mbolgar11/zenit/assets/video/zenit_projekt_poster.jpg

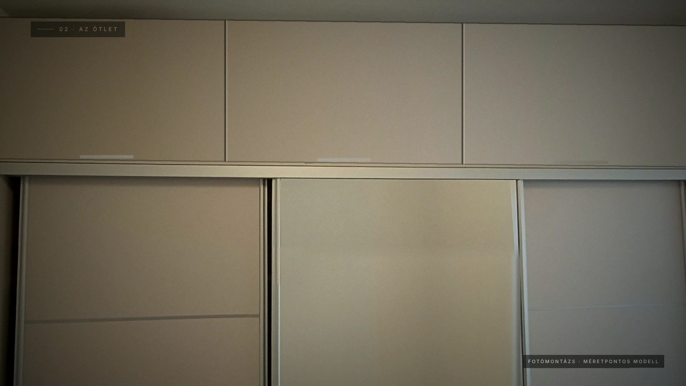
assets/video/zenit_projekt_poster.jpg
