mbolgar11/zenit/assets/img/r2/kezikonyv_hero_m.jpg

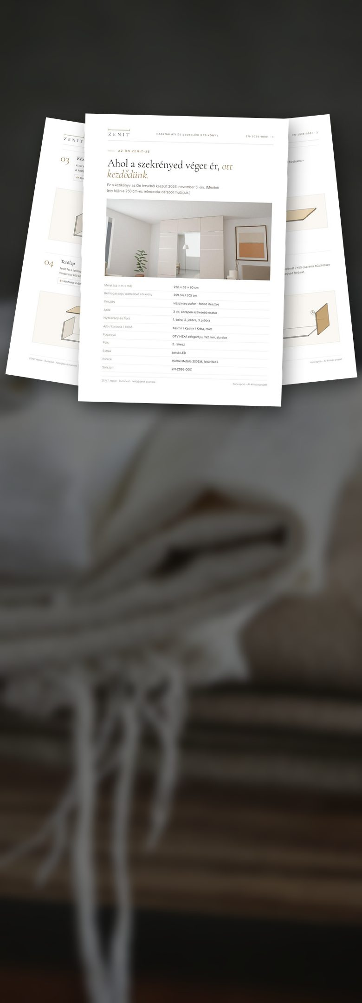
assets/img/r2/kezikonyv_hero_m.jpg
