mbolgar11/zenit/letoltes/ZENIT_kezikonyv_referencia.pdf

## Z E N I T

H A S Z N Á L AT I É S S Z E R E L É S I K É Z I K Ö N Y V | Z N - 2 0 2 6 - 0 0 0 1 · 1

A Z Ö N Z E N I T - J E

# Ahol a szekrényed véget ér, ott

kezdődünk.

Ez a kézikönyv az Ön tervéből készült 2026. november 5.-án. (Mentett terv híján a 250 cm-es referencia-darabot mutatjuk.)

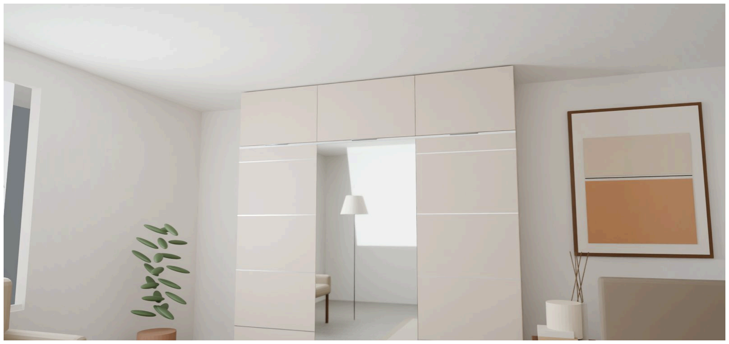
[picture p3: figure]

Méret (sz × m × mé) | 250 × 53 × 60 cm
Belmagasság / alatta lévő szekrény | 259 cm / 205 cm
Illesztés | vízszintes plafon · falhoz illesztve
Ajtók | 3 db, középen szélesebb osztás
Nyitásirány és front | 1. balra, 2. jobbra, 3. jobbra
Ajtó / korpusz / belső | Kasmír / Kasmír / Kréta, matt
Fogantyú | GTV HEXA élfogantyú, 192 mm, alu elox
Polc | 2. rekesz
Extrák | belső LED
Pántok | Häfele Metalla 300SM, felül fékes
Sorszám | ZN-2026-0001
ZENIT Atelier · Budapest · hello@zenit.example | Koncepció – AI-kihívás projekt

M I E L Ő T T E L K E Z D E N É | Z N - 2 0 2 6 - 0 0 0 1 · 2
Három szabály, és minden sikerül.
1. Puha takarón dolgozzon – a lapok éle és felülete hálás lesz érte.
2. A konfirmátot ütközésig húzza, utána csak negyed fordulatot.
3. Emelni mindig ketten kell: a korpusz ajtók nélkül kb. 56 kg.

# Szerszámok

Akkus csavarozó, PZ2 bit
Konfirmát kulcs (4 mm, a csomagban) Gumikalapács
Kis kalapács
Mérőszalag
Két létra
Ø2,5 fúrószár
PZ2 csavarhúzó
Vízmérték
Két ember

# Vasalat az Ön tervéhez

Fatipli 8×35 | 16 db
Konfirmát 7×50 + takarósapka | 16 db

Häfele Metalla 300SM
pánt (fékes + rugós)

6 db

Häfele szerelőtalp | 6 db
Csavar 3,5×16 | 30 db
Csavar 3,5×30 (rögzítés a szekrényhez) | 4 db
Polctartó csap Ø5 | 6 db
Hátfalszeg 1,6×25 | 50 db
GTV HEXA 192 élfogantyú | 3 db

LED-szalag +
ajtókapcsoló

3 db

Az ábrák a 250 cm-es, három ajtós referencia-darabot mutatják. Az Ön 3 ajtós ZENIT-je pontosan ugyanígy, ugyanebben a sorrendben áll össze – csak a közfalak és az ajtók száma más.

01

# Tiplik a helyükre

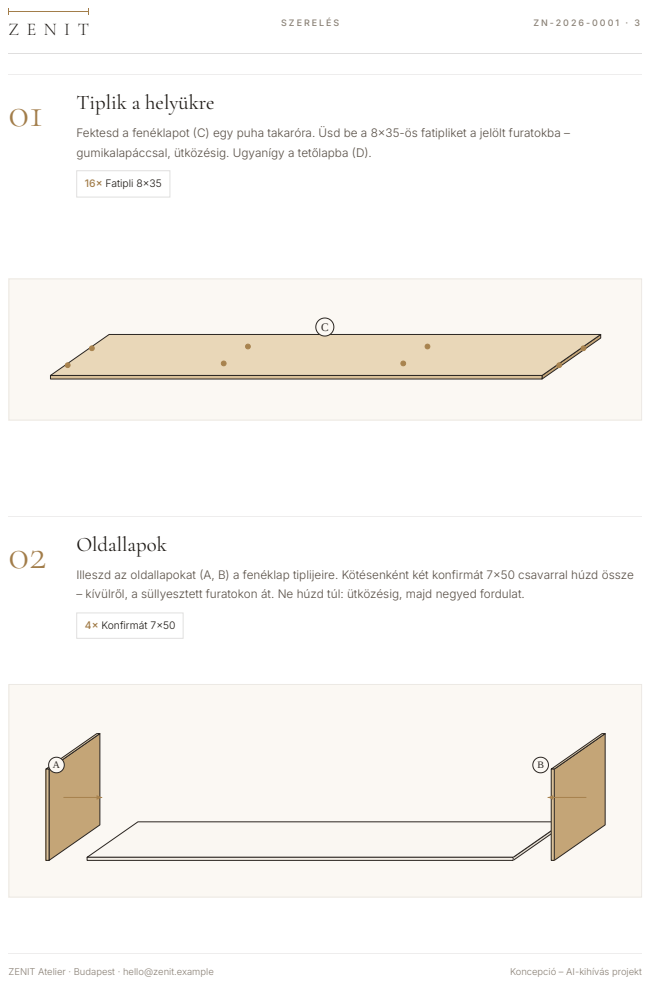
[picture p4: page 3]
16× Fatipli 8×35; Oldallapok; 4× Konfirmát 7×50

Fektesd a fenéklapot (C) egy puha takaróra. Üsd be a 8×35-ös fatipliket a jelölt furatokba –
gumikalapáccsal, ütközésig. Ugyanígy a tetőlapba (D).

Illeszd az oldallapokat (A, B) a fenéklap tiplijeire. Kötésenként két konfirmát 7×50 csavarral húzd össze
– kívülről, a süllyesztett furatokon át. Ne húzd túl: ütközésig, majd negyed fordulat.

03

# Közfalak

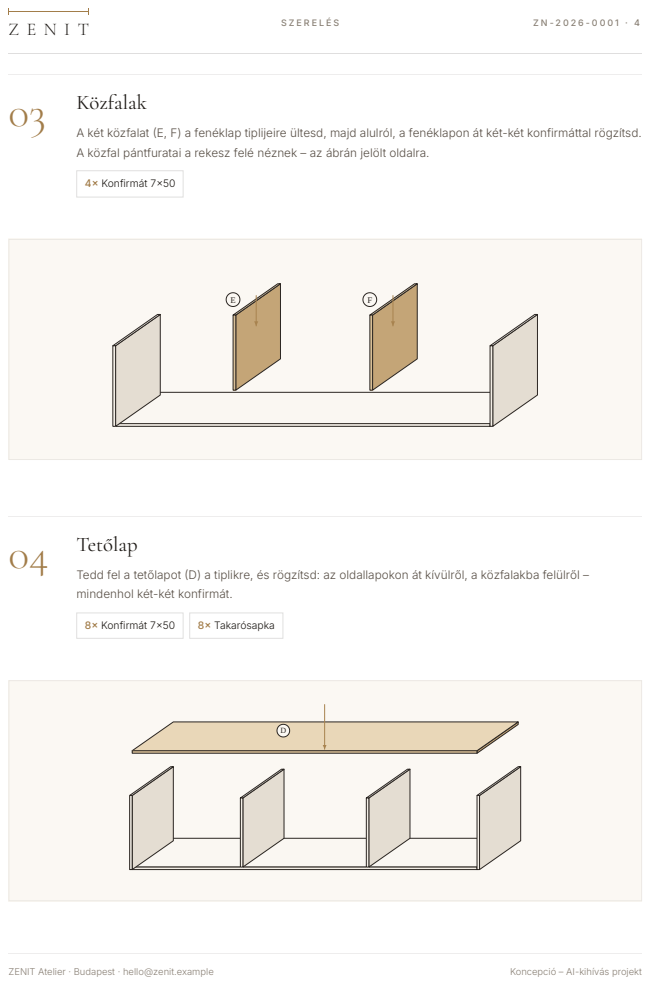
[picture p5: page 4]
4× Konfirmát 7×50; Tetőlap; 8× Konfirmát 7×50; 8× Takarósapka

A két közfalat (E, F) a fenéklap tiplijeire ültesd, majd alulról, a fenéklapon át két-két konfirmáttal rögzítsd.
A közfal pántfuratai a rekesz felé néznek – az ábrán jelölt oldalra.

Tedd fel a tetőlapot (D) a tiplikre, és rögzítsd: az oldallapokon át kívülről, a közfalakba felülről –
mindenhol két-két konfirmát.

05

# Derékszög

Mérd meg a korpusz két átlóját. Ha egyformák (±2 mm), a szekrény derékszögű – ez a záródó ajtók titka. Ha eltérnek, a hosszabb átló sarkait finoman nyomd össze.

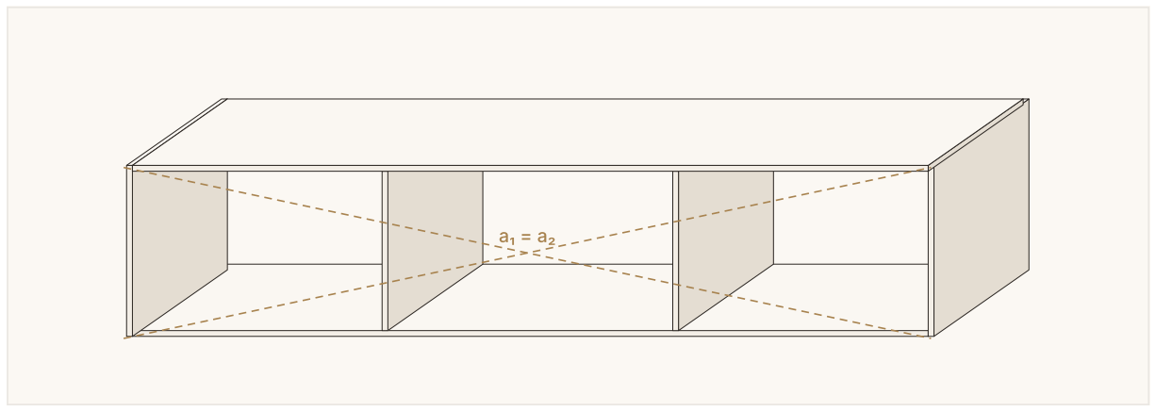
[picture p6: figure]

06

# Hátfal

Fordítsd a korpuszt elejével lefelé. Fektesd rá a hátfalat (H), igazítsd a sarkokhoz, és ~15 cm-enként üsd be a hátfalszegeket – körbe és a közfalakba is. Előfúrni nem kell.

50× Hátfalszeg 1,6×25

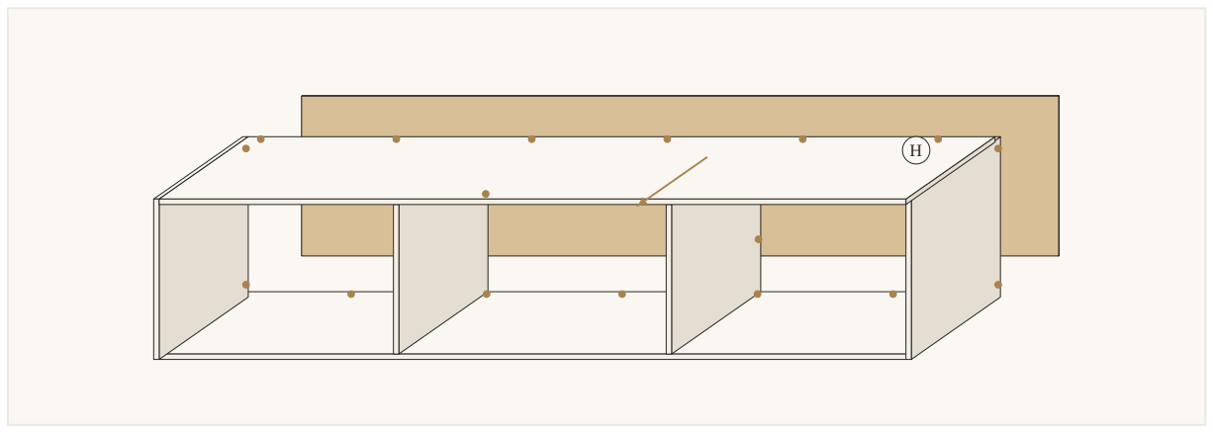
[picture p7: figure]

07

# Pánttalpak

Csavarozd fel a hat Häfele szerelőtalpat az előfúrt helyekre: az oldallapokra és a 2. közfalra, két-két 3,5×16 csavarral.

6× Häfele szerelőtalp 12× Csavar 3,5×16

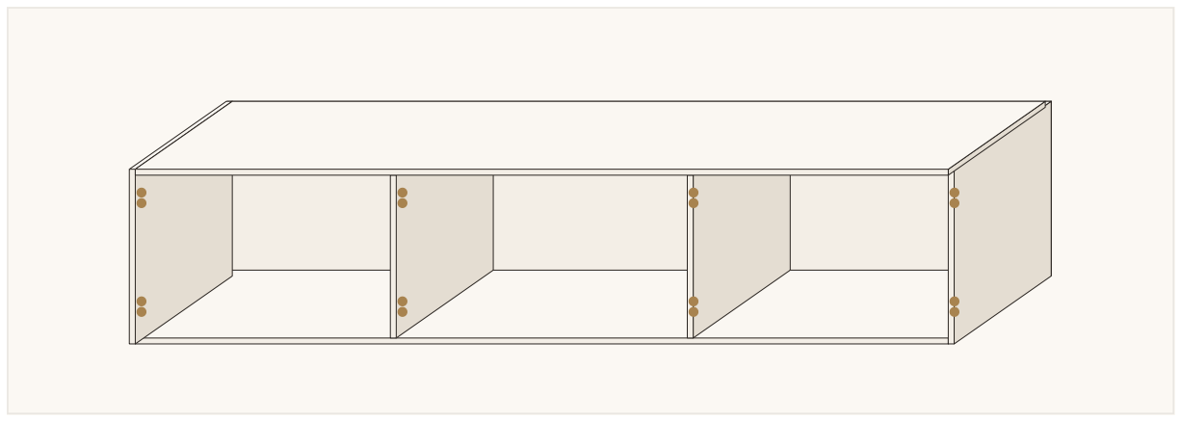
[picture p8: figure]

08

# Fel a szekrényre

Ketten emeljétek fel a korpuszt a meglévő szekrény tetejére – vízszintesen, és toljátok hátra. A plafonig ~10 mm marad, ezért billenteni nem lehet. Belülről, a két szélső rekeszben 2-2 csavarral rögzítsd a szekrény tetejéhez (Ø2,5 előfurat).

4× Csavar 3,5×30

Emeléskor mindig ketten! A korpusz kb. 56 kg ajtók nélkül.

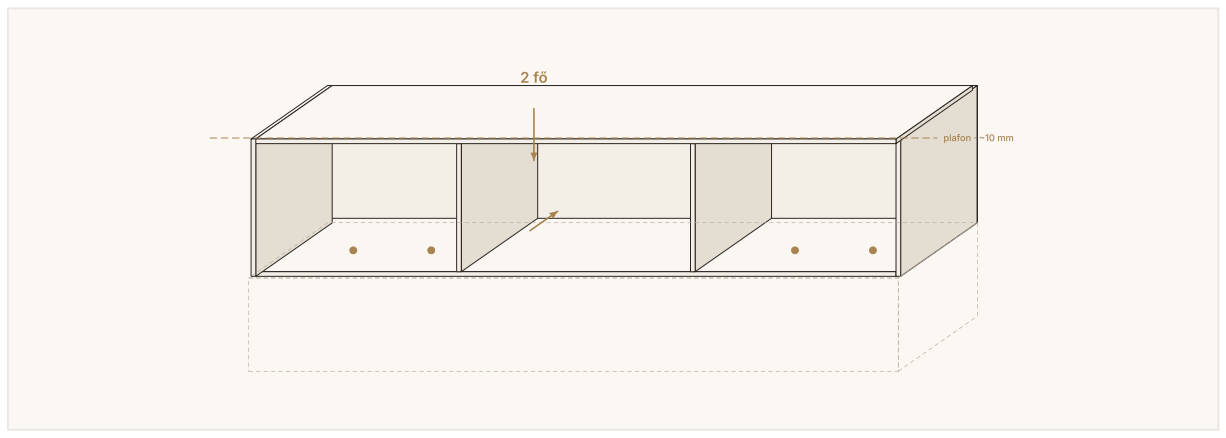
[picture p9: figure]
plafon · 10 mm

09

# Polc

Nyomd a polctartó csapokat a középső rekesz furataiba – oldalanként hármat. Csúsztasd be a polcot (G).

6× Polctartó csap Ø5

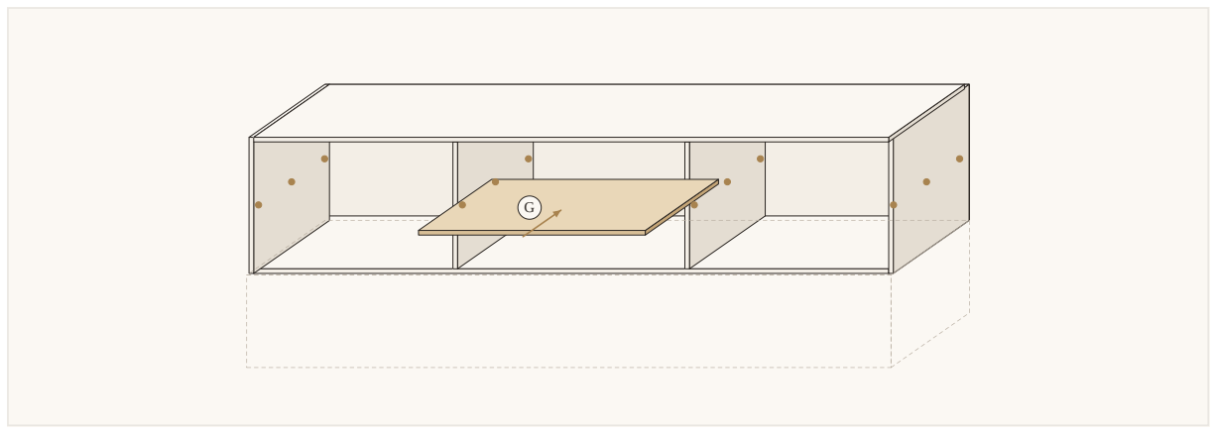
[picture p10: figure]

10

# Ajtók

Pattintsd az ajtókat (J, K, L) a szerelőtalpakra – szerszám nélkül, egy kattanásig. A pántok három csavarjával állítsd be a hézagokat: 3 mm az ajtók között, egyenes vonal alul és felül. Az Ön terve szerint: 1. ajtó balra, 2. ajtó jobbra, 3. ajtó jobbra.

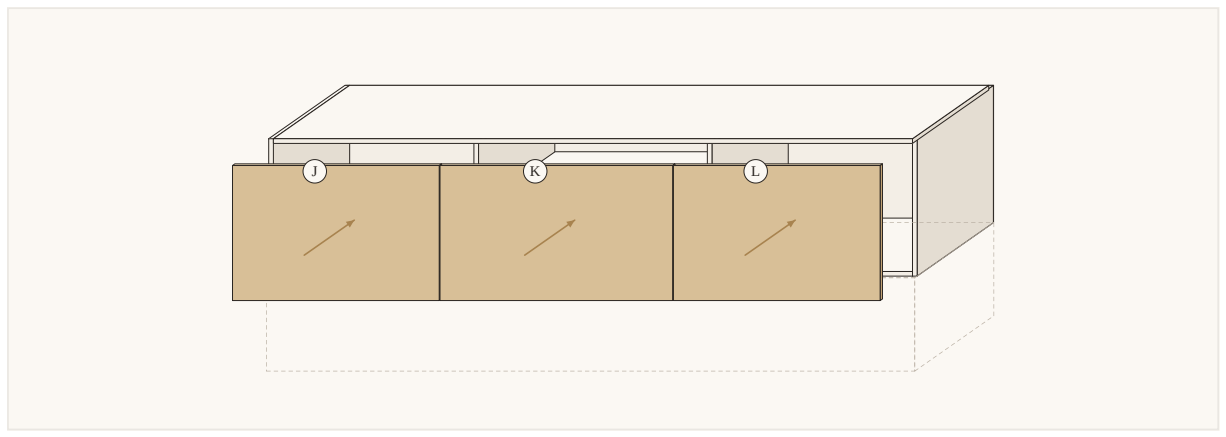
[picture p11: figure]

11

# Fogantyúk

Nyisd ki az ajtót, és belülről, két-két 3,5×16 csavarral rögzítsd a GTV HEXA élfogantyút az alsó él közepére. A furatok előre elkészültek, 192 mm-re egymástól.

3× GTV HEXA 192 élfogantyú 6× Csavar 3,5×16

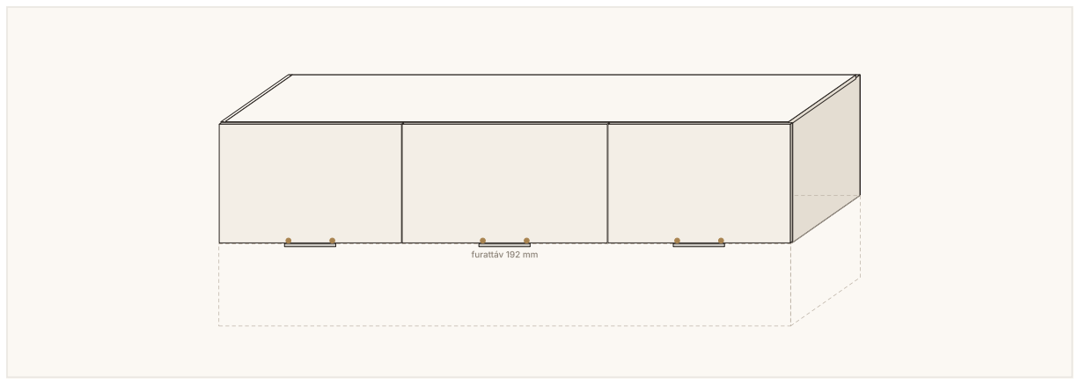
[picture p12: figure]
furattáv 192 mm

12
Kész. Csend.

Húzd le a védőfóliát, töröld át a felületeket puha, száraz kendővel. Csukd be az ajtókat – és hallgasd, ahogy a fékes pántok csendben behúzzák őket. A LED-et a csomagban lévő dugós csatlakozóval kösd össze, és tedd a konnektorba.

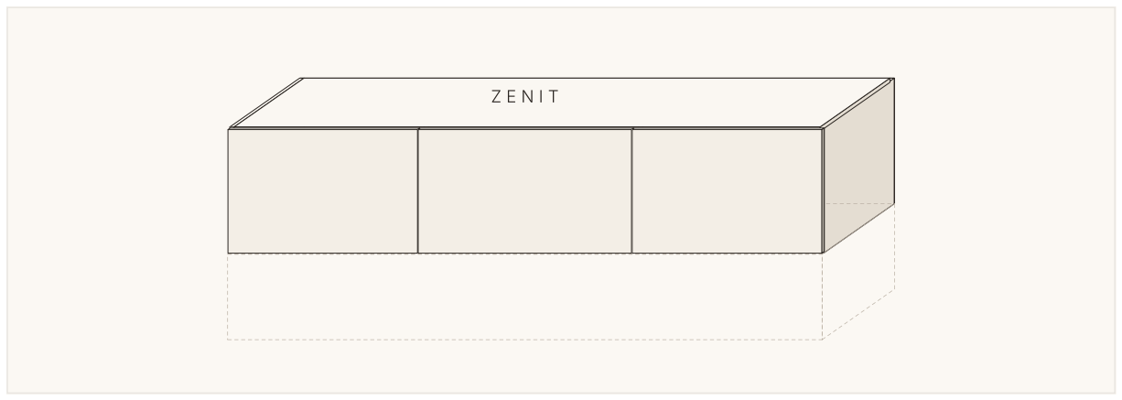
[picture p13: figure]

# Ápolás

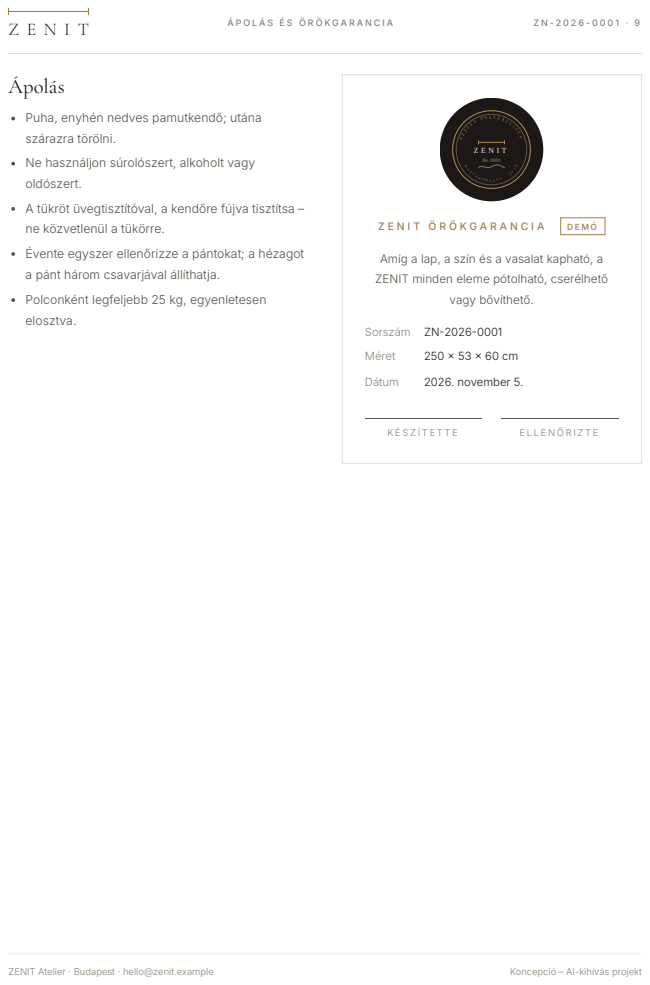
[picture p14: page 9]
vagy bővíthető.; Sorszám ZN-2026-0001; Méret; Dátum; 2026. november 5.

Puha, enyhén nedves pamutkendő; utána
szárazra törölni.
Ne használjon súrolószert, alkoholt vagy
oldószert.
A tükröt üvegtisztítóval, a kendőre fújva tisztítsa –
ne közvetlenül a tükörre.
Évente egyszer ellenőrizze a pántokat; a hézagot
a pánt három csavarjával állíthatja.
Polconként legfeljebb 25 kg, egyenletesen
elosztva.

Amíg a lap, a szín és a vasalat kapható, a
ZENIT minden eleme pótolható, cserélhető
