mbolgar11/zenit/letoltes/Ratet_v10_gyartasi_dokumentacio.pdf

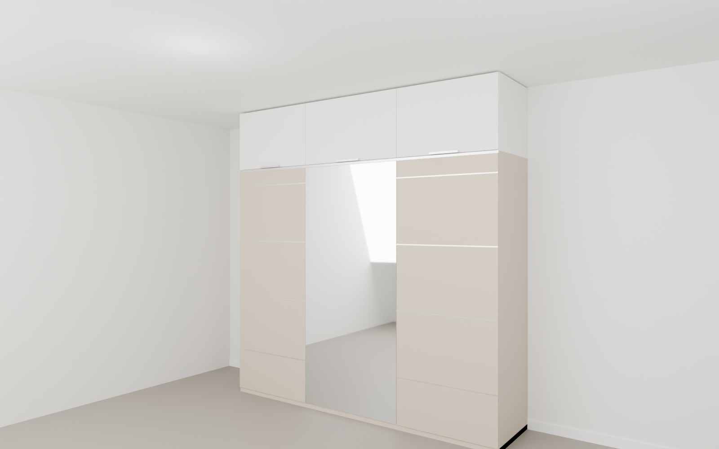
[picture p15: figure]

Rátétszekrény ELIA D 250-re · v10 végleges · gyártási dokumentáció · Bolgár Milán, 2026 | 1. oldal

# Rátétszekrény – v10 (végleges)

# az ELIA D 250 tolóajtós szekrény tetejére

Méret | 2500 × 530 × 600 mm (sz × m × mé) · 10 mm hely marad a plafonig (2590 mm)
Felépítés | Egy korpusz: 2 oldallap + 2 közfal, egybefüggő 2464 mm-es tető/fenék, 1 HDF hátfal · ajtóosztás 800 + 900 + 800 mm
Ajtók | 797 / 897 / 797 × 521 mm, körbe 2 mm ABS · hézag 1,5 mm oldalt, 3 mm az ajtók közt, 4.5 mm fent/lent · a középső megfordítható
Pántok | Häfele Metalla 300SM kombi 110° – ajtónként fent FÉKES, lent rugós; a közfalon félig ráütődő
Fogantyú | GTV HEXA lekerekített alu élfogantyú (elox), 192/225 mm, az ajtók alsó élének közepén, hátulról csavarozva
Anyag | OBI fehér 18 mm laminált forgácslap (4160321) · ajtók 2 mm ABS, minden más elülső él 0,4 mm ABS · 3 mm fehér HDF
Kötés | Élenként 2 konfirmát 7×50 + 2 bükk tipli 8×35 – szétszedhető
Polc | Középen levehető polc 3 + 3 Ø5 csapon; csapfuratok mindhárom rekeszben (később a szélsőkbe is tehető polc)
Hátfal | Beütős hátfalszeg 1,6×25, kb. 15 cm-enként körbe és a 4 függőleges elembe (50 db) – előfúrás, jelölés nem kell
Rögzítés | 4 db 3,5×30 a két szélső rekeszben, a fenéklapon át az ELIA tetejébe; falhoz/plafonhoz nem
Kötőelemek | 3 csavarfajta (7×50 · 3,5×16 · 3,5×30) + hátfalszeg
Tömeg | korpusz ajtó nélkül ~56.4 kg, ajtókkal ~71.6 kg (3 ember emelje)

Tartalom: 1 Áttekintés · 2 Nézetrajz és 3D modell · 3 Szabásjegyzék és szabásterv · 4 Vasalat · 5 Szerelés · 6–13 Alkatrészrajzok furattáblával · 14–16 Fúrósablon 1:1. Készült 2026. 11. 04. – Claude (Anthropic) + Bolgár Milán; paraméteres modell: Python → Fusion 360 / CadQuery.

# Nézetrajz és 3D modell (Autodesk Fusion)

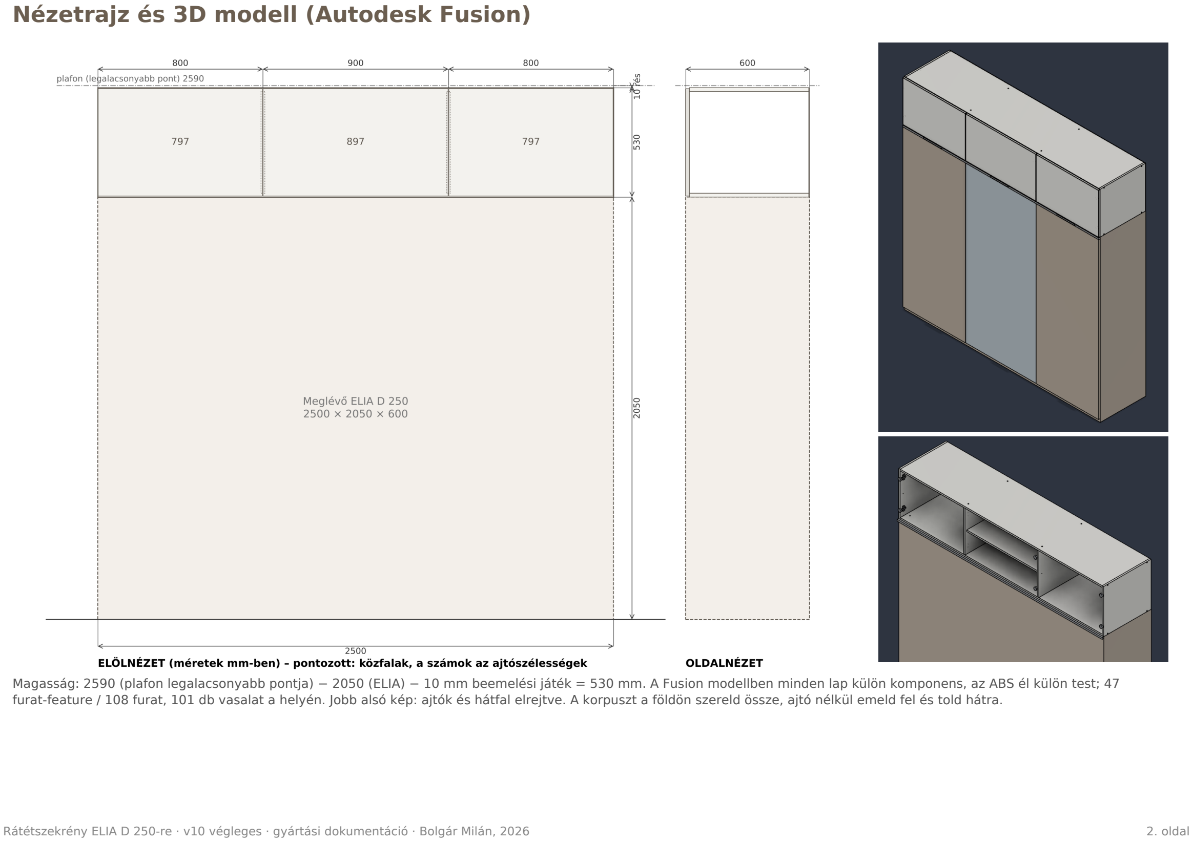
[picture p16: page 2]

Rátétszekrény ELIA D 250-re · v10 végleges · gyártási dokumentáció · Bolgár Milán, 2026 | 2. oldal

Magasság: 2590 (plafon legalacsonyabb pontja) − 2050 (ELIA) − 10 mm beemelési játék = 530 mm. A Fusion modellben minden lap külön komponens, az ABS él külön test; 47 furat-feature / 108 furat, 101 db vasalat a helyén. Jobb alsó kép: ajtók és hátfal elrejtve. A korpuszt a földön szereld össze, ajtó nélkül emeld fel és told hátra.

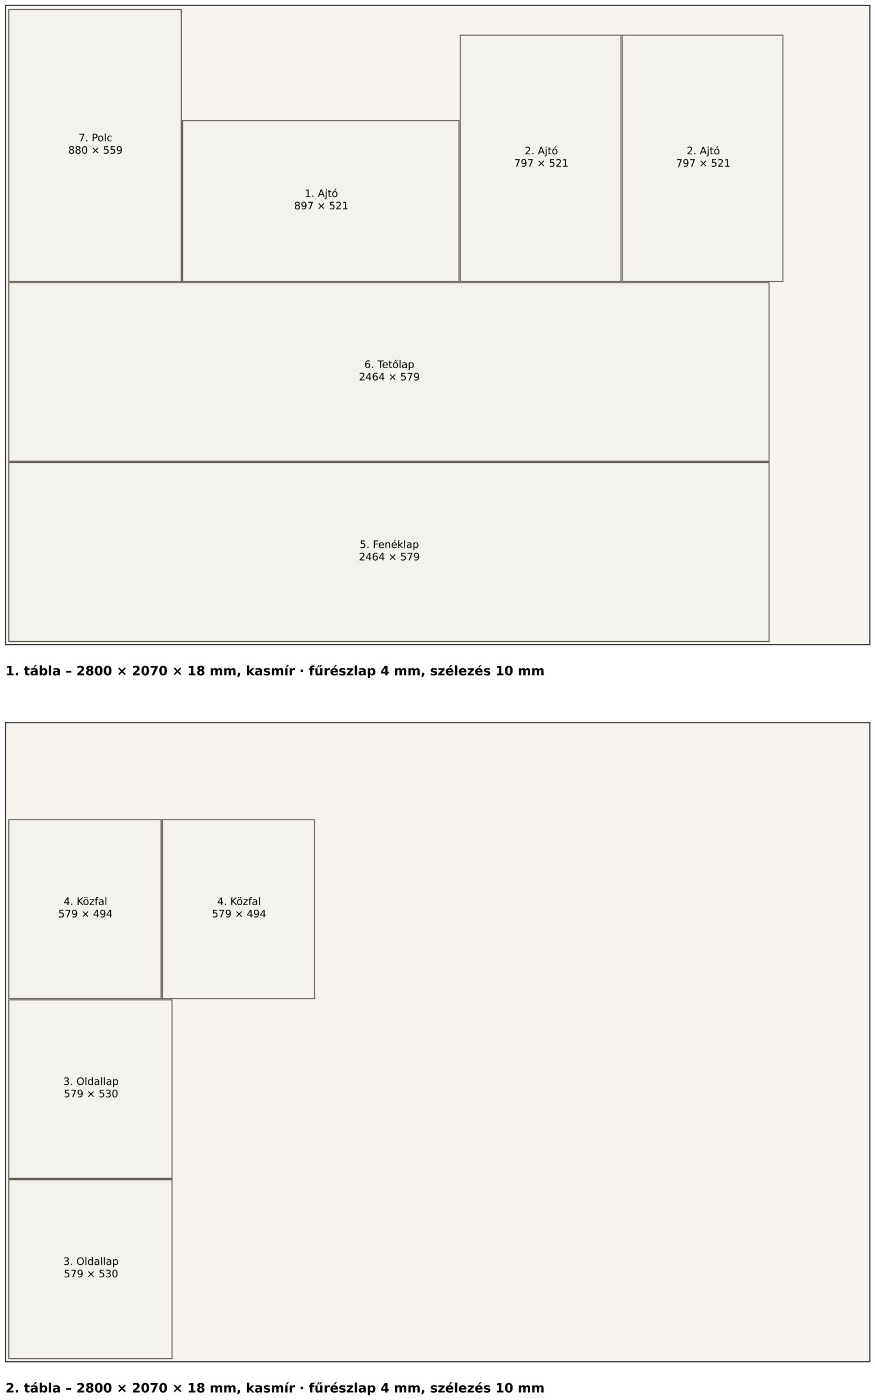
[picture p17: figure]

Rátétszekrény ELIA D 250-re · v10 végleges · gyártási dokumentáció · Bolgár Milán, 2026 | 3. oldal

# Szabásjegyzék és szabásterv – rendeléshez (OBI / lapszabászat)

Poz. | Megnevezés | Hossz | Szél. | Vast. | Db | Élzárás | Rajz
1 | Ajtó | 897 | 521 | 18 | 1 | körbe 2 mm ABS | A08–A10
2 | Ajtó | 797 | 521 | 18 | 2 | körbe 2 mm ABS | A08–A10
3 | Oldallap | 579 | 530 | 18 | 2 | 1 rövid él (530) 0,4 mm ABS – elülső él | A01
4 | Közfal | 579 | 494 | 18 | 2 | 1 rövid él (494) 0,4 mm ABS – elülső él | A04–A05
5 | Fenéklap | 2464 | 579 | 18 | 1 | 1 hosszú él (2464) 0,4 mm ABS – elülső él | A02
6 | Tetőlap | 2464 | 579 | 18 | 1 | 1 hosszú él (2464) 0,4 mm ABS – elülső él | A03
7 | Polc | 880 | 559 | 18 | 1 | 1 hosszú él (880) 0,4 mm ABS – elülső él | nincs furat
8 | Hátfal | 2498 | 528 | 3 | 1 | nincs | nincs furat
| Összesen | | | | 11

Készméretek mm-ben, élzárással együtt. Fehér uni: nincs szálirány. HDF hátfal 3 mm. Anyag: 18 mm lap nettó 5.83 m² → 2 tábla 2800×2070 · HDF 1 tábla · élzáró 0,4 mm 7.9 fm · 2 mm 8.1 fm.
Rendeléskor kérd: pántcsésze-fúrás az ajtókon – Ø35×13 mm, csészeközép 21,5 mm-re a pántoldali éltől, 95,5 mm-re az ajtó aljától és tetejétől; pántoldal: bal ajtó bal, középső jobb, jobb ajtó jobb. A 2464 mm-es lapok autóba nem férnek – szállítás kell. Ha a többi furatot is vállalják, add oda a 6–13. oldalt és az Excel „Furatok” lapját.

Rátétszekrény ELIA D 250-re · v10 végleges · gyártási dokumentáció · Bolgár Milán, 2026 | 4. oldal

# Vasalat, kötőelem, szerszám

Tétel | Menny. | Hova / megjegyzés
Pánt: Häfele Metalla 300SM kombi 110°, RÁÜTŐDŐ, FÉKES (311.60.525) | 2 db | Bal és jobb ajtó FELSŐ pántja. Csésze Ø35×13, 21,5 mm-re a pántoldali éltől, 95,5 mm-re az ajtó tetejétől
Pánt: Häfele Metalla 300SM kombi 110°, RÁÜTŐDŐ, rugós (311.60.620) | 2 db | Bal és jobb ajtó ALSÓ pántja, 95,5 mm-re az ajtó aljától
Pánt: Häfele Metalla 300SM kombi 110°, FÉLIG RÁÜTŐDŐ, FÉKES (311.60.526) | 1 db | Középső ajtó FELSŐ pántja (a 2. közfalon)
Pánt: Häfele Metalla 300SM kombi 110°, FÉLIG RÁÜTŐDŐ, rugós (311.60.621) | 1 db | Középső ajtó ALSÓ pántja
Szerelőtalp: Häfele Metalla 300SM kombi D0 (311.71.540) | 6 db | Mind a 6 pánthoz ugyanaz; 2 db 3,5×16 csavarral, Ø2,5×10 előfuratba
Élfogantyú: GTV HEXA, alu elox, 192 mm furattáv / 225 mm hossz (UA-HEXA-192-05, butorkellek.hu 1342) | 3 db | Ajtónként 1 db az alsó él közepén, lekerekített profil; hátulról, az ajtó belső lapjába 2 db 3,5×16 csavarral, Ø2,5×12 előfurat, 192 mm-re egymástól, 10 mm-re az alsó éltől
Polctartó csap Ø5, fém | 6 db | A középső levehető polchoz, oldalanként 3 db (elöl, középen, hátul); szélső rekeszekbe későbbi polchoz +6-6 db
1. csavar: konfirmát 7×50 + takarósapka | 20 db | Modellben 16 db (kötésenként 2); takarósapka 8 db kell (a két külső oldallapra)
Bükk fatipli 8×35 mm, hornyolt | 20 db | Modellben 16 db (kötésenként 2)
2. csavar: forgácslapcsavar 3,5×16, süllyesztett, PZ2 | 50 db | Pántcsészék 12, pánttalpak 12, élfogantyúk 6 = 30 db
3. csavar: forgácslapcsavar 3,5×30, süllyesztett, PZ2 | 10 db | Rögzítés az ELIA tetejéhez: 4 db, a két szélső rekeszben 2-2 (az ELIA tetejét Ø2,5-tel előfúrni)
Hátfalszeg 1,6×25, horganyzott (beütős) | 100 db | Hátfal: 50 db, kb. 15 cm-enként körbe és a 4 függőleges elembe; előfúrás és jelölés nem kell, kalapáccsal beütni
Szerszám | Mire kell
Akkus fúró-csavarozó | Mindenhez
Konfirmát lépcsős fúrószár Ø5/Ø7 | Konfirmát furatok egy mozdulattal (~1500–2500 Ft)
Ø8 mm fafúró + mélységütköző gyűrű | Tiplifuratok: 12 mm (lapfelület) és 25 mm (lapél)
Ø35 mm Forstner fúró | Csak ha a lapszabászat nem fúrja ki a pántcsészéket
Ø5 mm fafúró + mélységütköző (12 mm) | Polctartó csapfuratok: oldallapon 12 mm mély, közfalon átmenő
Ø2,5 mm fafúró | Előfuratok: pánttalp, élfogantyú, ELIA teteje
Mérőszalag, derékszög, ceruza, kinyomtatott fúrósablon | A sablon 1:1-ben a dokumentáció végén
Gumikalapács + kis kalapács | Tiplis kötések összeütése; hátfalszegek

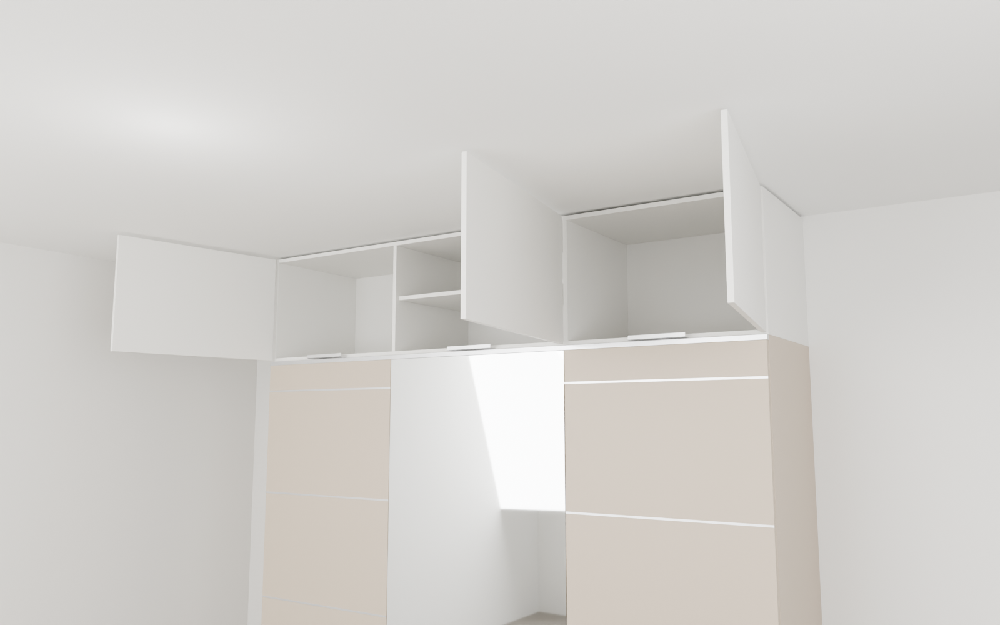
[picture p18: figure]

Rátétszekrény ELIA D 250-re · v10 végleges · gyártási dokumentáció · Bolgár Milán, 2026 | 5. oldal

# Szerelési útmutató

1. Előkészítés | Fúrósablon nyomtatása 100%-on (ellenőrizd a 100 mm-es vonalzót). Tető- és fenéklapon a közfalak középvonala: 800 és 1700 mm balról.
2. Fúrás | A 6–13. oldal szerint: konfirmát Ø7 átmenő + süllyesztés, Ø5×50 a lapélben; tipli Ø8×12 / Ø8×25; polccsap Ø5 – oldallapon 12 mm mély, közfalon átmenő, oldalanként 3 db (37 / 289.5 / 542 mm elölről, oldallapon 253.5, közfalon 235.5 mm magasan); pánttalp Ø2,5×10 (100 és 430 mm magasan, 37 mm elölről); élfogantyú Ø2,5×12 az ajtók belső lapján, 10 mm-re az alsó éltől, 192 mm-re egymástól.
3. Korpusz a FÖLDÖN | Fenéklapra tiplik → oldallapok és közfalak rá → konfirmátok alulról a fenéklapon át és oldalról az oldallapokon át.
4. Tetőlap | Tetőlap a tiplikre → konfirmátok felülről a közfalakba, oldalról az oldallapokon át.
5. Hátfal | Átlómérés (egyformák legyenek), majd a 2498×528 HDF beütős hátfalszeggel, kb. 15 cm-enként körbe és a 4 függőleges elembe – előfúrás, jelölés nélkül, a lapok közepére célozva. A polcba nem.
6. Vasalat | Pánttalpak 2-2 db 3,5×16 csavarral (bal oldallap, 2. közfal bal lapja, jobb oldallap). Fent a FÉKES, lent a rugós pánt. Élfogantyúk az ajtók alsó élének közepére, hátulról a belső lapba, 2-2 db 3,5×16. Polccsapok (3 + 3) és polc a középső rekeszbe.
7. Felemelés | Ajtó nélkül ~56.4 kg, 2,5 m hosszú – 3 ember. A plafonig csak 10 mm marad: a korpuszt elölről, vízszintesen told fel az ELIA tetejére, ne billentsd. Rögzítés: 4 db 3,5×30 a fenéklapon át (az ELIA tetejét Ø2,5-tel előfúrni).
8. Ajtók | Rákattintás a pántokra, beállítás: 1,5 mm oldalt, 3 mm az ajtók között, 4.5 mm fent/lent. A középső ajtó fejjel lefelé fordítva a másik közfalra is felrakható (tartalék előfuratok).

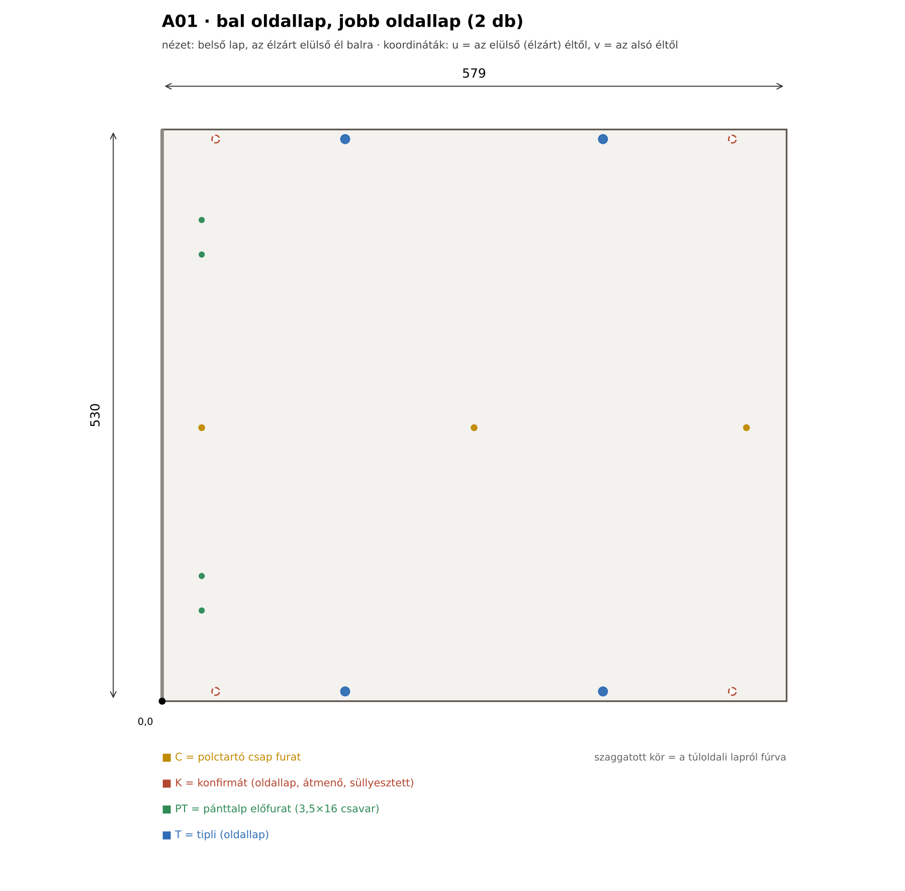
[picture p19: figure]

Rátétszekrény ELIA D 250-re · v10 végleges · gyártási dokumentáció · Bolgár Milán, 2026 | 6. oldal

# Alkatrészrajz A01 – bal és jobb oldallap (2 db)

Jel | Felület | u | v | Ø | Mély. | Süll.
C | belső lap | 37 | 253.5 | 5 | 12
C | belső lap | 289.5 | 253.5 | 5 | 12
C | belső lap | 542 | 253.5 | 5 | 12
PT | belső lap | 37 | 84 | 2.5 | 10
PT | belső lap | 37 | 116 | 2.5 | 10
PT | belső lap | 37 | 414 | 2.5 | 10
PT | belső lap | 37 | 446 | 2.5 | 10
T | belső lap | 170 | 9 | 8 | 12
T | belső lap | 409 | 9 | 8 | 12
T | belső lap | 170 | 521 | 8 | 12
T | belső lap | 409 | 521 | 8 | 12
K | külső lap | 50 | 9 | 7 | 18 | 10.5
K | külső lap | 529 | 9 | 7 | 18 | 10.5
K | külső lap | 50 | 521 | 7 | 18 | 10.5
K | külső lap | 529 | 521 | 7 | 18 | 10.5

Jelek: K konfirmát · T tipli · P pántcsésze · PT pánttalp-előfurat (* tartalék a megfordítható középső ajtóhoz) · C polctartó csap · F élfogantyú-előfurat · R rögzítőcsavar. Lapél-furatnál a „v” az elülső éltől mért távolság, a furat az él közepén (9 mm) van. A polc (880×559) és a hátfal furat nélküli.

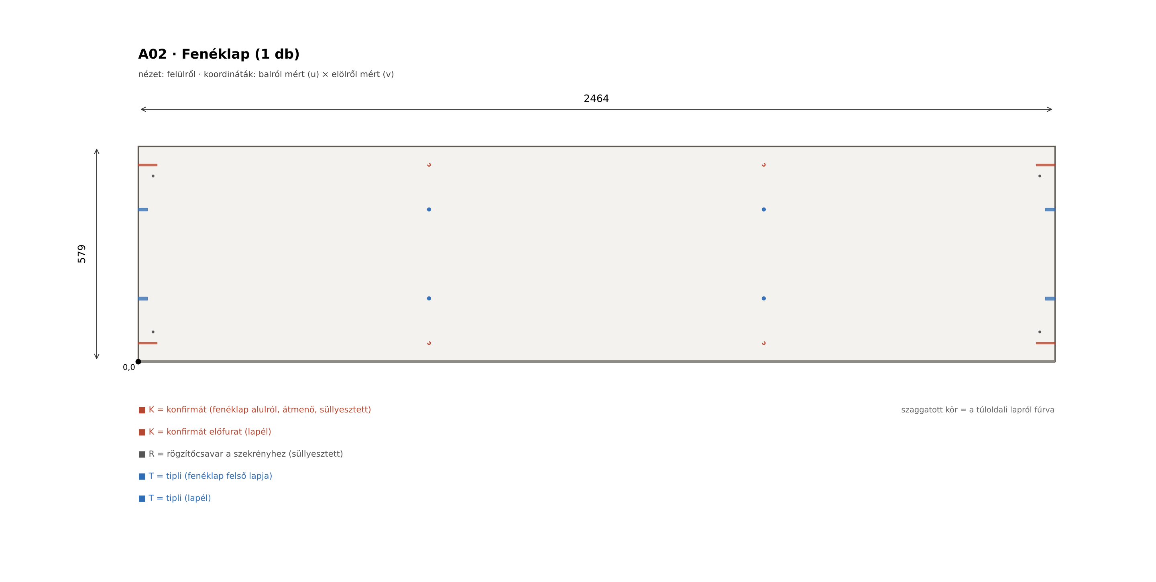
[picture p20: figure]

Rátétszekrény ELIA D 250-re · v10 végleges · gyártási dokumentáció · Bolgár Milán, 2026 | 7. oldal

# Alkatrészrajz A02 – fenéklap

Jel | Felület | u | v | Ø | Mély. | Süll.
K | alsó lap | 782 | 50 | 7 | 18 | 10.5
K | alsó lap | 1682 | 50 | 7 | 18 | 10.5
K | alsó lap | 782 | 529 | 7 | 18 | 10.5
K | alsó lap | 1682 | 529 | 7 | 18 | 10.5
K | bal él | él | 50 | 5 | 50
K | bal él | él | 529 | 5 | 50
T | bal él | él | 170 | 8 | 25
T | bal él | él | 409 | 8 | 25
R | felső lap | 40 | 80 | 4 | 18 | 8
R | felső lap | 2424 | 80 | 4 | 18 | 8
R | felső lap | 40 | 499 | 4 | 18 | 8
R | felső lap | 2424 | 499 | 4 | 18 | 8
T | felső lap | 782 | 170 | 8 | 12
T | felső lap | 1682 | 170 | 8 | 12
T | felső lap | 782 | 409 | 8 | 12
T | felső lap | 1682 | 409 | 8 | 12
K | jobb él | él | 50 | 5 | 50
K | jobb él | él | 529 | 5 | 50
T | jobb él | él | 170 | 8 | 25
T | jobb él | él | 409 | 8 | 25

Jelek: K konfirmát · T tipli · P pántcsésze · PT pánttalp-előfurat (* tartalék a megfordítható középső ajtóhoz) · C polctartó csap · F élfogantyú-előfurat · R rögzítőcsavar. Lapél-furatnál a „v” az elülső éltől mért távolság, a furat az él közepén (9 mm) van. A polc (880×559) és a hátfal furat nélküli.

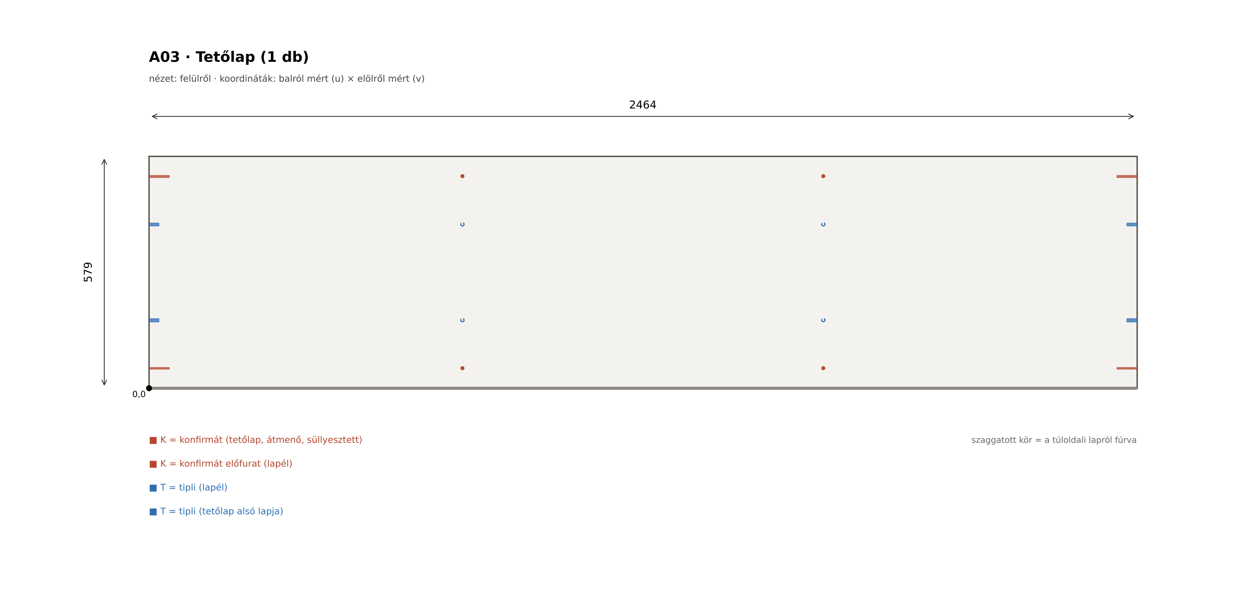
[picture p21: figure]

Rátétszekrény ELIA D 250-re · v10 végleges · gyártási dokumentáció · Bolgár Milán, 2026 | 8. oldal

# Alkatrészrajz A03 – tetőlap

Jel | Felület | u | v | Ø | Mély. | Süll.
T | alsó lap | 782 | 170 | 8 | 12
T | alsó lap | 1682 | 170 | 8 | 12
T | alsó lap | 782 | 409 | 8 | 12
T | alsó lap | 1682 | 409 | 8 | 12
K | bal él | él | 50 | 5 | 50
K | bal él | él | 529 | 5 | 50
T | bal él | él | 170 | 8 | 25
T | bal él | él | 409 | 8 | 25
K | felső lap | 782 | 50 | 7 | 18 | 10.5
K | felső lap | 1682 | 50 | 7 | 18 | 10.5
K | felső lap | 782 | 529 | 7 | 18 | 10.5
K | felső lap | 1682 | 529 | 7 | 18 | 10.5
K | jobb él | él | 50 | 5 | 50
K | jobb él | él | 529 | 5 | 50
T | jobb él | él | 170 | 8 | 25
T | jobb él | él | 409 | 8 | 25

Jelek: K konfirmát · T tipli · P pántcsésze · PT pánttalp-előfurat (* tartalék a megfordítható középső ajtóhoz) · C polctartó csap · F élfogantyú-előfurat · R rögzítőcsavar. Lapél-furatnál a „v” az elülső éltől mért távolság, a furat az él közepén (9 mm) van. A polc (880×559) és a hátfal furat nélküli.

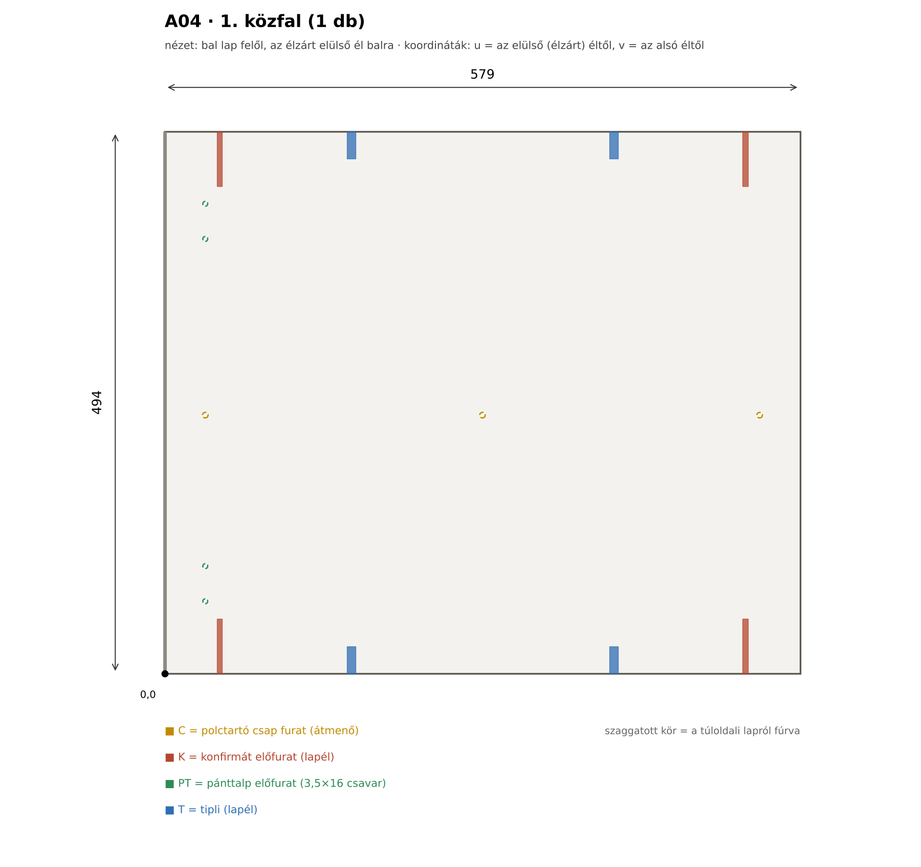
[picture p22: figure]

Rátétszekrény ELIA D 250-re · v10 végleges · gyártási dokumentáció · Bolgár Milán, 2026 | 9. oldal

# Alkatrészrajz A04 – 1. közfal

Jel | Felület | u | v | Ø | Mély. | Süll.
K | alsó él | 50 | 0 | 5 | 50
K | alsó él | 529 | 0 | 5 | 50
T | alsó él | 170 | 0 | 8 | 25
T | alsó él | 409 | 0 | 8 | 25
K | felső él | 50 | 494 | 5 | 50
K | felső él | 529 | 494 | 5 | 50
T | felső él | 170 | 494 | 8 | 25
T | felső él | 409 | 494 | 8 | 25
C | jobb lap | 37 | 235.5 | 5 | 18
C | jobb lap | 289.5 | 235.5 | 5 | 18
C | jobb lap | 542 | 235.5 | 5 | 18
PT | jobb lap | 37 | 66 | 2.5 | 10
PT | jobb lap | 37 | 98 | 2.5 | 10
PT | jobb lap | 37 | 396 | 2.5 | 10
PT | jobb lap | 37 | 428 | 2.5 | 10

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

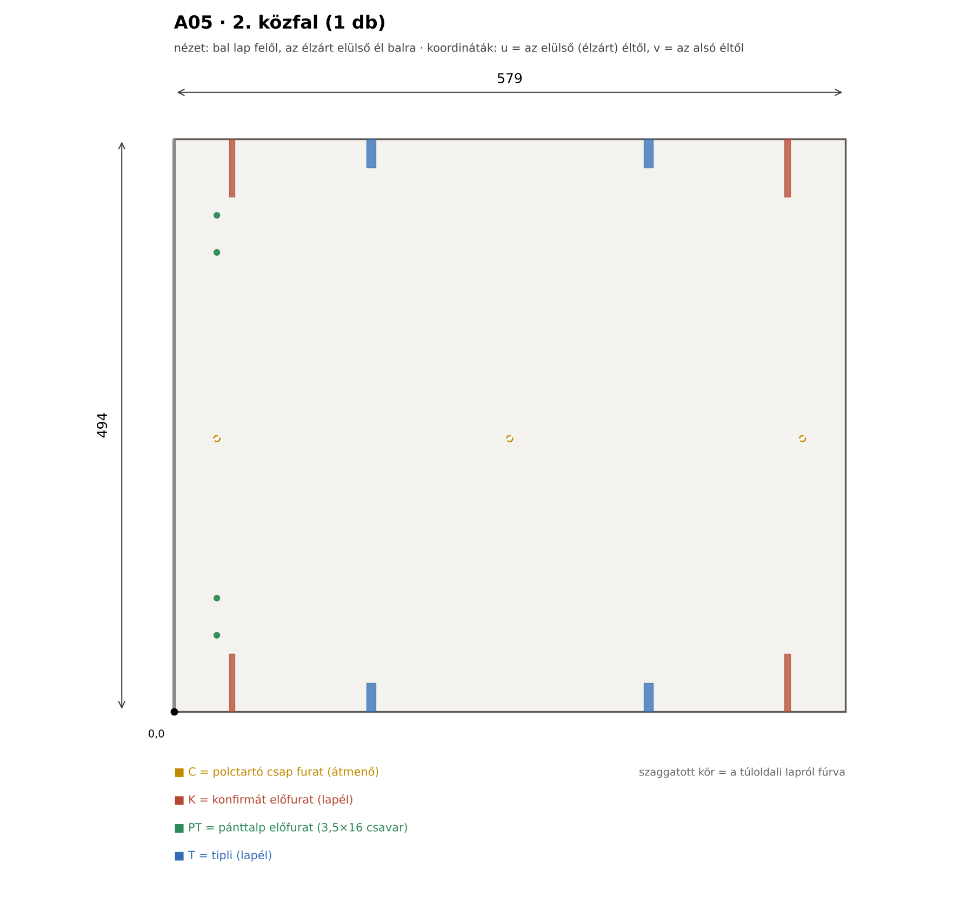
[picture p23: figure]

Rátétszekrény ELIA D 250-re · v10 végleges · gyártási dokumentáció · Bolgár Milán, 2026 | 10. oldal

# Alkatrészrajz A05 – 2. közfal

Jel | Felület | u | v | Ø | Mély. | Süll.
K | alsó él | 50 | 0 | 5 | 50
K | alsó él | 529 | 0 | 5 | 50
T | alsó él | 170 | 0 | 8 | 25
T | alsó él | 409 | 0 | 8 | 25
PT | bal lap | 37 | 66 | 2.5 | 10
PT | bal lap | 37 | 98 | 2.5 | 10
PT | bal lap | 37 | 396 | 2.5 | 10
PT | bal lap | 37 | 428 | 2.5 | 10
K | felső él | 50 | 494 | 5 | 50
K | felső él | 529 | 494 | 5 | 50
T | felső él | 170 | 494 | 8 | 25
T | felső él | 409 | 494 | 8 | 25
C | jobb lap | 37 | 235.5 | 5 | 18
C | jobb lap | 289.5 | 235.5 | 5 | 18
C | jobb lap | 542 | 235.5 | 5 | 18

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

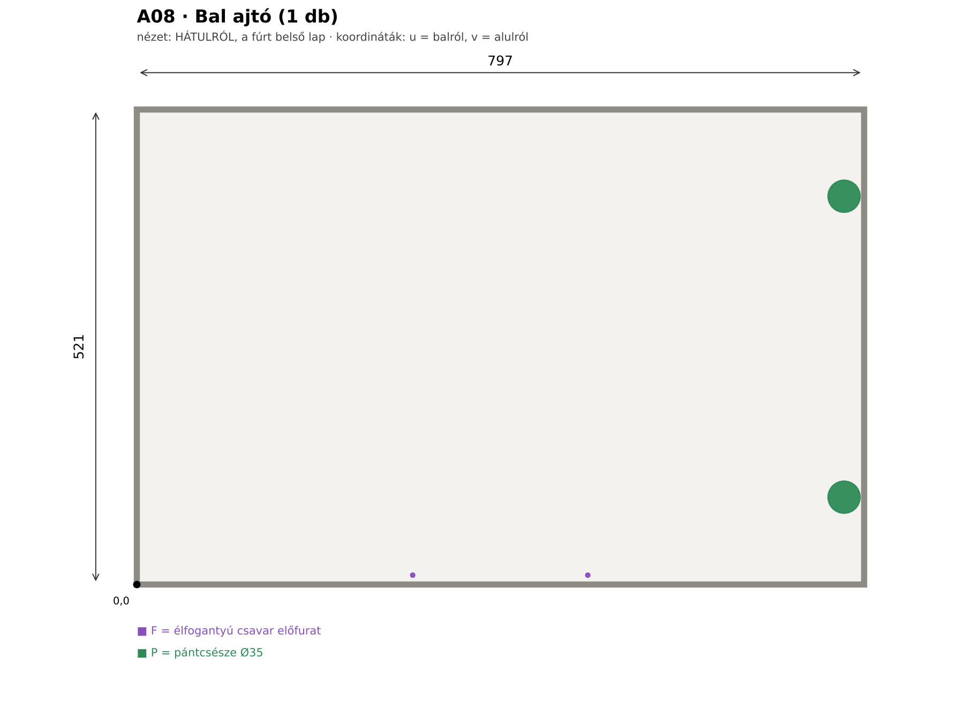
[picture p24: figure]

Rátétszekrény ELIA D 250-re · v10 végleges · gyártási dokumentáció · Bolgár Milán, 2026 | 11. oldal

# Alkatrészrajz A08 – bal ajtó, hátulról nézve

Jel | Felület | u | v | Ø | Mély. | Süll.
F | belső (hátsó) lap | 302.5 | 10 | 2.5 | 12
F | belső (hátsó) lap | 494.5 | 10 | 2.5 | 12
P | belső (hátsó) lap | 775.5 | 95.5 | 35 | 13
P | belső (hátsó) lap | 775.5 | 425.5 | 35 | 13

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

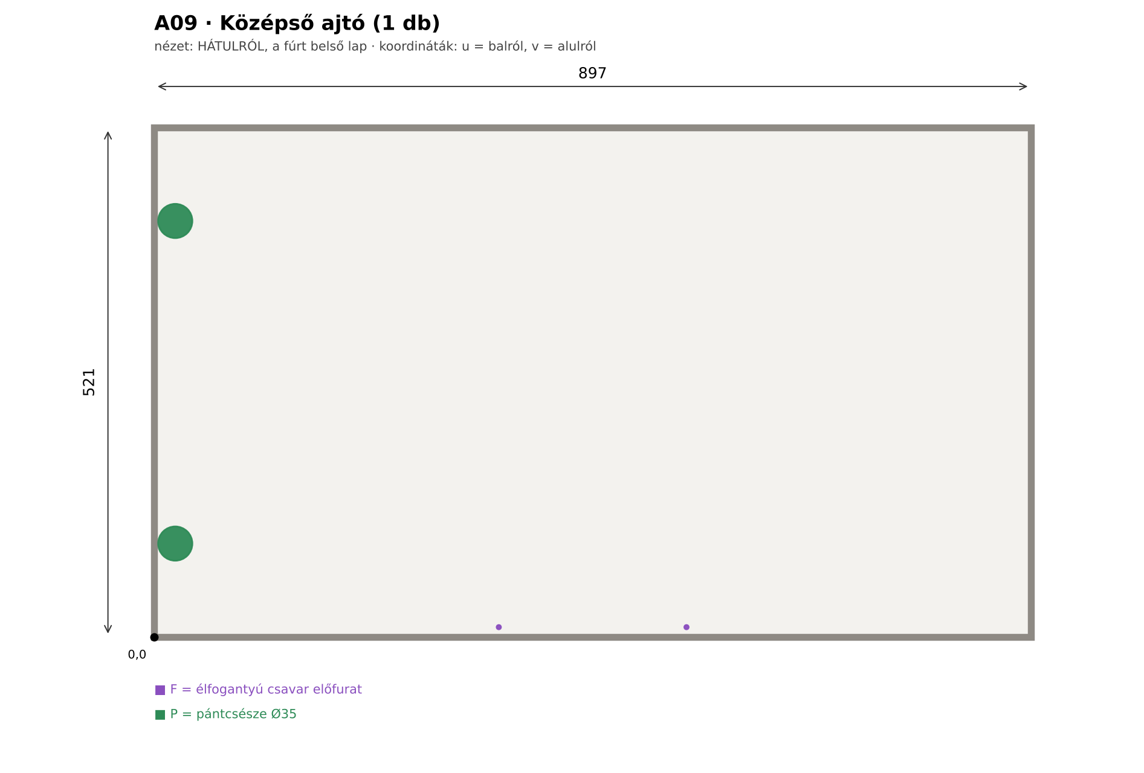
[picture p25: figure]

Rátétszekrény ELIA D 250-re · v10 végleges · gyártási dokumentáció · Bolgár Milán, 2026 | 12. oldal

# Alkatrészrajz A09 – középső ajtó, hátulról nézve

Jel | Felület | u | v | Ø | Mély. | Süll.
F | belső (hátsó) lap | 352.5 | 10 | 2.5 | 12
F | belső (hátsó) lap | 544.5 | 10 | 2.5 | 12
P | belső (hátsó) lap | 21.5 | 95.5 | 35 | 13
P | belső (hátsó) lap | 21.5 | 425.5 | 35 | 13

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

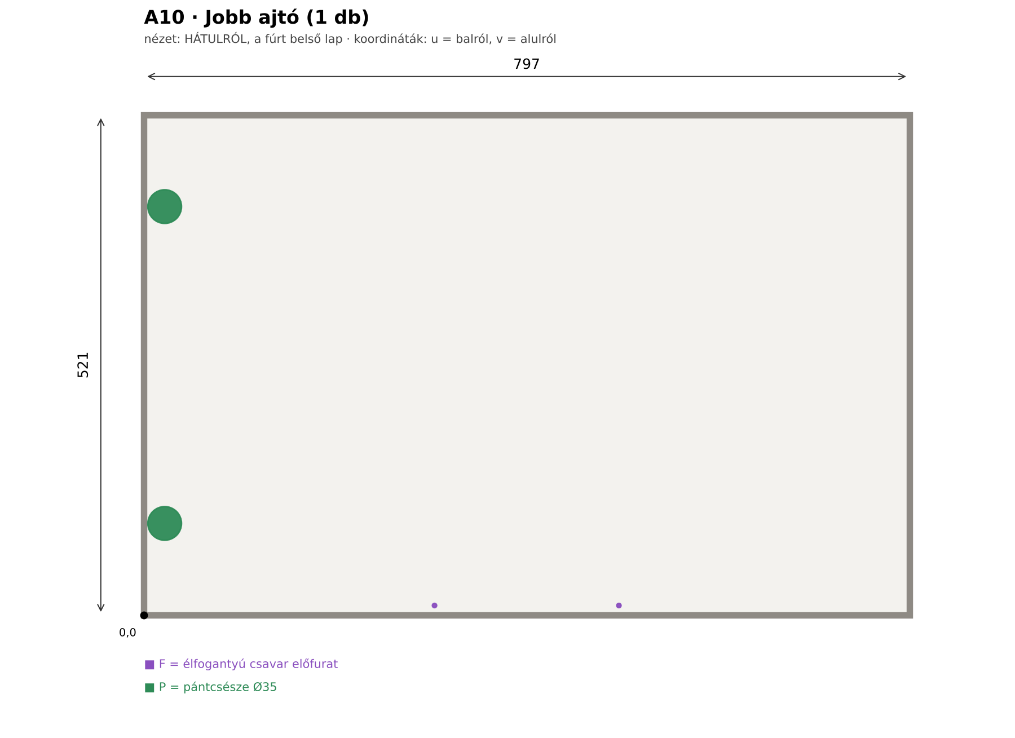
[picture p26: figure]

Rátétszekrény ELIA D 250-re · v10 végleges · gyártási dokumentáció · Bolgár Milán, 2026 | 13. oldal

# Alkatrészrajz A10 – jobb ajtó, hátulról nézve

Jel | Felület | u | v | Ø | Mély. | Süll.
F | belső (hátsó) lap | 302.5 | 10 | 2.5 | 12
F | belső (hátsó) lap | 494.5 | 10 | 2.5 | 12
P | belső (hátsó) lap | 21.5 | 95.5 | 35 | 13
P | belső (hátsó) lap | 21.5 | 425.5 | 35 | 13

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

Rátétszekrény ELIA D 250-re · v10 végleges · gyártási dokumentáció · Bolgár Milán, 2026 | 14. oldal

## Fúrósablon 1:1 – 1/3. lap (0–200 mm)

Nyomtatás: 100% / „Tényleges méret” – NE „Oldalhoz igazítva”. Ellenőrizd a lenti 100 mm-es vonalzót. Vágd ki a csíkokat, és ragaszd össze a lapokat az illesztésnél.

◄ EZT AZ ÉLT A LAP SZÉLÉHEZ ILLESZD (felső / alsó él, vagy a lapél felülete)

A sablon – oldallap/tető/fenék kötés; a közfal kötéséhez a tető/fenék lapján a szaggatott vonalat a közfal középvonalára (800 / 1700 mm) illeszd

0 = ELÖL

konfirmát

50
tipli

170

▲ illesztés

◄ EZT AZ ÉLT A LAP SZÉLÉHEZ ILLESZD (felső / alsó él, vagy a lapél felülete)

B sablon – polctartó csap (3 db) · az élt a ceruzavonalhoz illeszd: oldallapon 253.5 mm, közfalon 235.5 mm a lap aljától

0 = ELÖL

polccsap Ø5

37

▲ illesztés

100 mm – ha nem pontosan ennyi, rossz a nyomtatási méretezés

Rátétszekrény ELIA D 250-re · v10 végleges · gyártási dokumentáció · Bolgár Milán, 2026 | 15. oldal

## Fúrósablon 1:1 – 2/3. lap (190–400 mm)

Nyomtatás: 100% / „Tényleges méret” – NE „Oldalhoz igazítva”. Ellenőrizd a lenti 100 mm-es vonalzót. Vágd ki a csíkokat, és ragaszd össze a lapokat az illesztésnél.

◄ EZT AZ ÉLT A LAP SZÉLÉHEZ ILLESZD (felső / alsó él, vagy a lapél felülete)

A sablon – oldallap/tető/fenék kötés; a közfal kötéséhez a tető/fenék lapján a szaggatott vonalat a közfal középvonalára (800 / 1700 mm) illeszd

▲ illesztés | ▲ illesztés

◄ EZT AZ ÉLT A LAP SZÉLÉHEZ ILLESZD (felső / alsó él, vagy a lapél felülete)

B sablon – polctartó csap (3 db) · az élt a ceruzavonalhoz illeszd: oldallapon 253.5 mm, közfalon 235.5 mm a lap aljától

polccsap Ø5

289.5

▲ illesztés | ▲ illesztés

100 mm – ha nem pontosan ennyi, rossz a nyomtatási méretezés

Rátétszekrény ELIA D 250-re · v10 végleges · gyártási dokumentáció · Bolgár Milán, 2026 | 16. oldal

## Fúrósablon 1:1 – 3/3. lap (390–579 mm)

Nyomtatás: 100% / „Tényleges méret” – NE „Oldalhoz igazítva”. Ellenőrizd a lenti 100 mm-es vonalzót. Vágd ki a csíkokat, és ragaszd össze a lapokat az illesztésnél.

◄ EZT AZ ÉLT A LAP SZÉLÉHEZ ILLESZD (felső / alsó él, vagy a lapél felülete)

A sablon – oldallap/tető/fenék kötés; a közfal kötéséhez a tető/fenék lapján a szaggatott vonalat a közfal középvonalára (800 / 1700 mm) illeszd

konfirmát

529
tipli

409

▲ illesztés

◄ EZT AZ ÉLT A LAP SZÉLÉHEZ ILLESZD (felső / alsó él, vagy a lapél felülete)

B sablon – polctartó csap (3 db) · az élt a ceruzavonalhoz illeszd: oldallapon 253.5 mm, közfalon 235.5 mm a lap aljától

polccsap Ø5

542

▲ illesztés

100 mm – ha nem pontosan ennyi, rossz a nyomtatási méretezés
