mbolgar11/zenit/letoltes/ZENIT_uzleti_terv.pdf

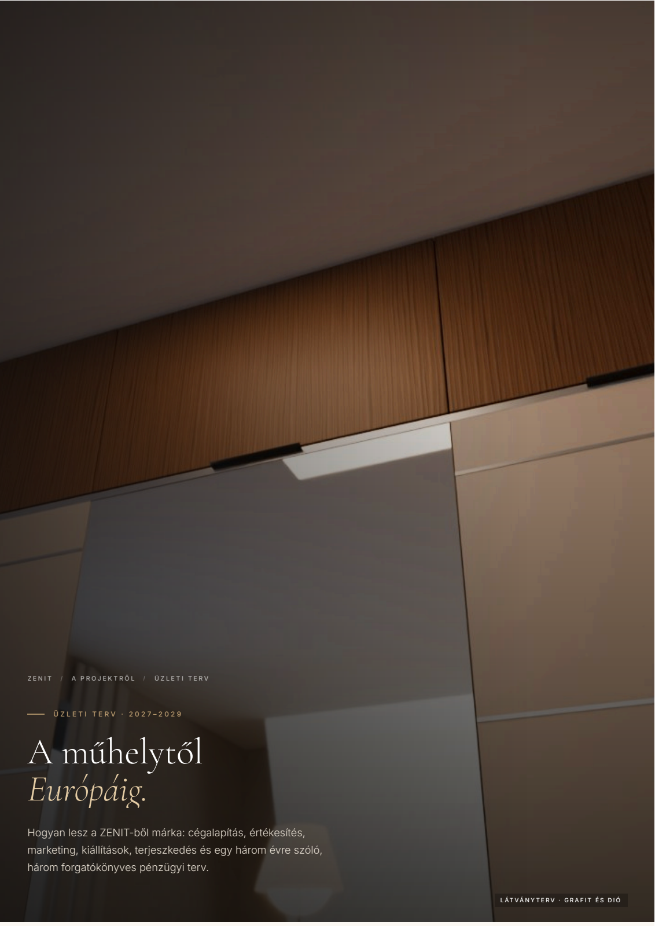
[picture p27: page 1]

Ü Z L E T I T E R V · 2 0 2 7 – 2 0 2 9

# A műhelytől

Európáig.

Hogyan lesz a ZENIT-ből márka: cégalapítás, értékesítés, marketing, kiállítások, terjeszkedés és egy három évre szóló, három forgatókönyves pénzügyi terv.

Z E N I T (http://localhost:8766/index.html) / A P R O J E K T R Ő L (http://localhost:8766/projekt.html) / Ü Z L E T I T E R V

L ÁT VÁ N Y T E R V · G R A F I T É S D I Ó

Koncepció.

Ez a terv az AI-kihívás része: a piaci adatok forrásoltak, a darabszámok, árak és költségek tervezői becslések (guesswork), egy induló prémium bútormárka szokásos arányaival.

Ö S S Z E F O G L A L Ó

# Egy új kategória, prémium

áron, nyugodt tempóban.

A ZENIT a meglévő gardrób fölötti fél métert alakítja egyetlen, méretre gyártott felső szekrénnyé. Budapesten indulunk, 2028-ban Bécs, Pozsony és Prága, 2029-ben a német nyelvterület és Észak-Olaszország következik. Az alap forgatókönyvben a működés 2028 végére nyereséges, a legmagasabb finanszírozási igény kb. 60 M Ft.

I N D U L Á S 2027. március pilot Budapesten, 20 alapító ügyféllel | T Ő K E I G É N Y ( A L A P ) 59,7 M Ft a legmélyebb pont + 8% tartalék, 2029 Q2 | P O Z I T Í V E B I T D A 2028 Q4 a 22. hónaptól; óvatosan 2029 Q3
E L A D Á S 3 É V A L AT T 1 930 db alap forgatókönyv, 4 csatorna | Á R B E V É T E L 2 0 2 9 427,6 M Ft ≈ 1.1 M €, 7 országban | F E D E Z E T ≈ 50% közvetlen költségek után, csatornától függően

0 1 · P I A C É S R E A L I T Á S

# Van piaca? Igen – ha

megmutatjuk.

A szekrény fölötti üres sáv szinte minden otthonban ott van, de ritkán keresnek rá: ez rejtett igény. A feladat ezért nem a kereslet kiszolgálása, hanem a probléma láthatóvá tétele.

# 330 Mrd Ft

a hazai háztartások bútor- és világításköltése 2020-ban (GVH / Pénzcentrum)

# ~98 Mrd Ft

az IKEA magyarországi árbevétele egy évben (2019/20)

# 3,2 Mrd $

az európai beépített gardróbpiac becsült mérete (DataHorizzon)

300 000+

vevő 28 országban a lengyel Tylko méretre szabott bútoraira – az online konfigurátoros modell működik

## Kinek szól?

30–55 éves, jól kereső városi párok és családok új lakásba költözők és felújítók
meglévő gardróbbal: IKEA PAX, Bútorline, XXXLutz, asztalosmunka
belsőépítészek, akiknek „befejezett” megoldás kell

## Becslés a piac méretére

Magyarországon kb. 4,5 millió lakás; nagyjából minden harmadikban van beépített vagy álló gardrób
prémium szegmens (vásárlóerő + igény): kb. 3–4%, azaz 45– 60 ezer háztartás
a 3 éves terv ebből kb. 0,8 ezer magyar vevővel számol – a prémium szegmens 1,5–2%-a
Európában a beépített gardróbpiac kb. 3,2 Mrd $, évi 5% körüli növekedéssel

Ítélet: a piac létezik, de kicsi és rejtett – ezért a ZENIT prémium rés-márkaként működik: magas árrés, kevés, de büszke vevő, erős tartalom. A tanulság a német deinSchrank.de-től (2010, kb. 80 fő, 2023-ban fizetésképtelenség, majd felvásárlás): a méretre gyártás online is eladható, de a túl korai saját gyár és a tőkeigényes növekedés veszélyes. Ezért gyártunk partnerrel, és csak 2029-ben lépünk saját CNC-cella felé.

0 2 · M Á R K A
A szekrény, amit befejeztek.

A ZENIT nem újabb szekrény, hanem egy hiányzó gesztus: a meglévő bútor befejezése a plafonig. Erről kell, hogy beszéljenek.

0 1 Kategória Nem szekrényt adunk el, hanem egy új kategóriát: a felső szekrényt, ami befejezi a meglévőt. A név a jelenség neve legyen: „ZENIT-elni” a szekrényt. | 0 2 Ígéret Ahol a szekrényed véget ér, ott kezdődünk. Méretre, 10 mm-re a plafontól, falfúrás nélkül, három óra alatt.
0 3 Jelek Bronz vonal, 10 mm-es rés, sorszámozott tetőlap, aláírt tanúsítvány, Örökgarancia – minden érintési ponton ugyanaz. | 0 4 Hang Nyugodt, pontos, meleg. Nem kiabál akciót – megmutatja az előtte–utánát, és hagyja, hogy a csend beszéljen.

0 3 · Ü Z L E T I M O D E L L E K

# Hat út ugyanahhoz a

vevőhöz.

Az első év a közvetlen eladásé és a belsőépítészeké, a második a partnereké, a harmadik a licencé és a visszatérő bevételé.

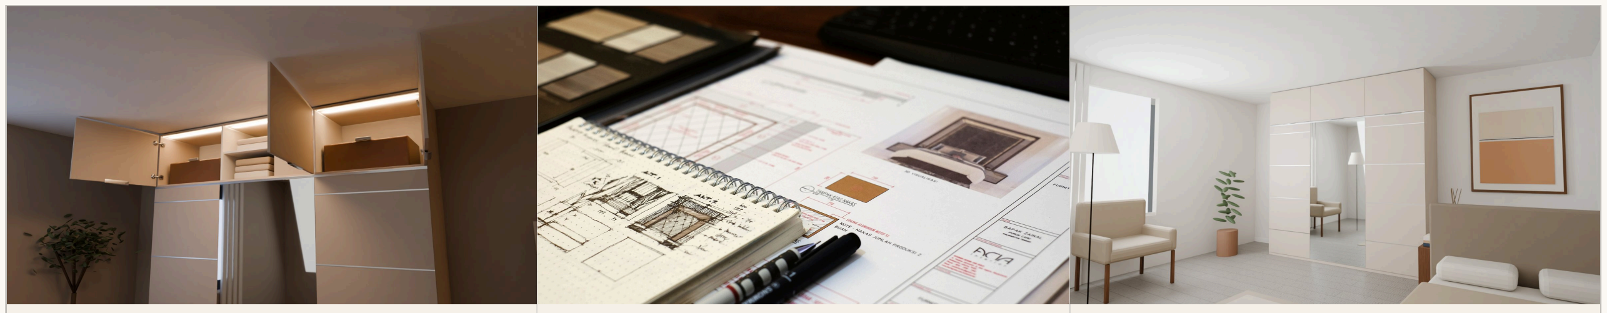
[picture p28: figure]

0 1 · D 2 C Közvetlen online eladás Tervező → mentett terv → videós konzultáció → felmérés → 50% előleg. A legmagasabb árrés, a márka itt épül. | 0 2 · B 2 B 2 C Belsőépítészek és stúdiók 10% jutalék, mintadoboz, saját tervezői hozzáférés. Bizalmi ajánlás, nagyobb kosárérték. | 0 3 · B 2 B Ingatlanfejlesztők „Plafonig” felárcsomag prémium új lakásokhoz – sorozatgyártási ár, egy szerződés sok lakásra.

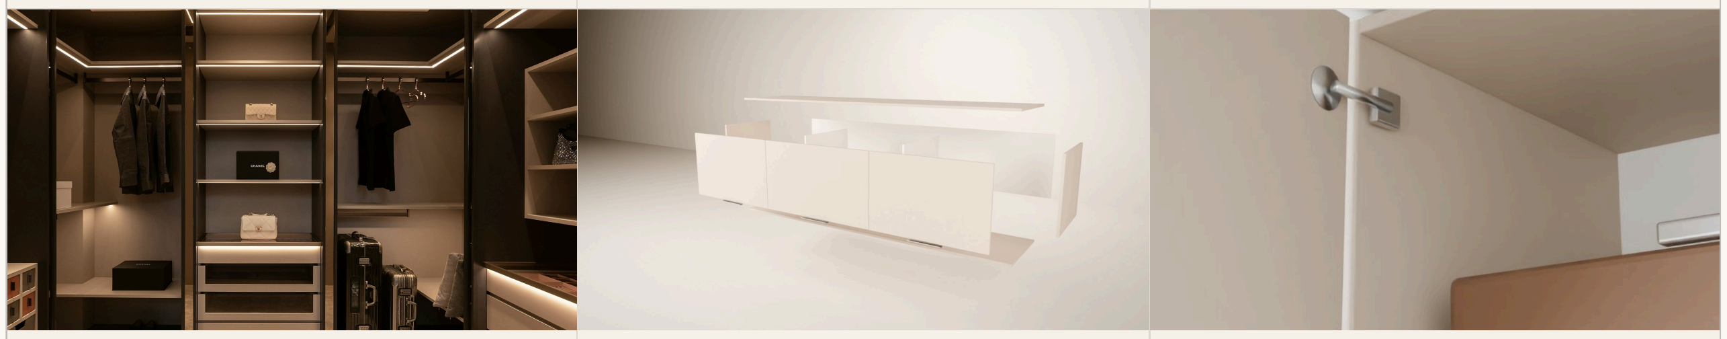
[picture p29: figure]

0 4 · R E TA I L Bemutatótermi partnerek Shop-in-shop sarok gardróbstúdiókban: mintadarab, QR-kód a tervezőhöz, nagykereskedelmi ár (−35%). | 0 5 · L I C E N C White label és licenc Szekrénygyártóknak: a ZENIT-rendszer (tervező + gyártási modell) licencdíjért vagy darabdíjért. | 0 6 · S Z O L G Á LTATÁ S Örökgarancia és bővítés Pót- és bővítőelemek, költözési átszerelés, LED-utólag – visszatérő bevétel a meglévő vevőktől.

# Harminchat hónap, kilenc

mérföldkő.

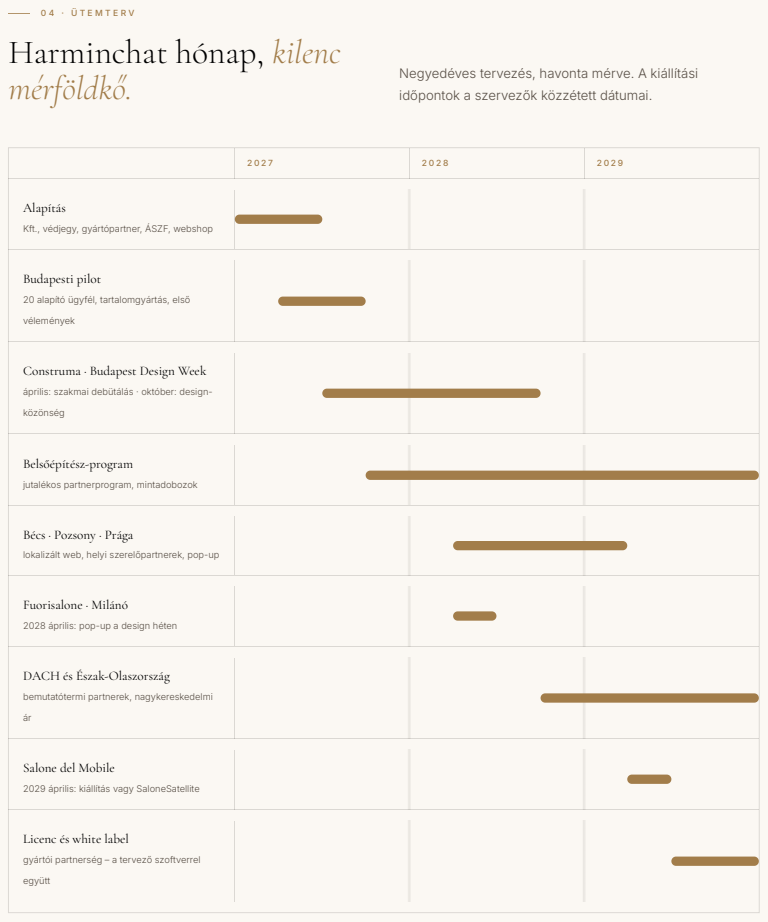
[picture p30: page 6]
Alapítás; Budapesti pilot; vélemények; közönség; Belsőépítész-program; Fuorisalone · Milánó; együtt

Negyedéves tervezés, havonta mérve. A kiállítási
időpontok a szervezők közzétett dátumai.

Kft., védjegy, gyártópartner, ÁSZF, webshop

20 alapító ügyfél, tartalomgyártás, első

Construma · Budapest Design Week

április: szakmai debütálás · október: design-

jutalékos partnerprogram, mintadobozok

Bécs · Pozsony · Prága

lokalizált web, helyi szerelőpartnerek, pop-up

2028 április: pop-up a design héten

DACH és Észak-Olaszország

bemutatótermi partnerek, nagykereskedelmi

Salone del Mobile

2029 április: kiállítás vagy SaloneSatellite

Licenc és white label

gyártói partnerség – a tervező szoftverrel

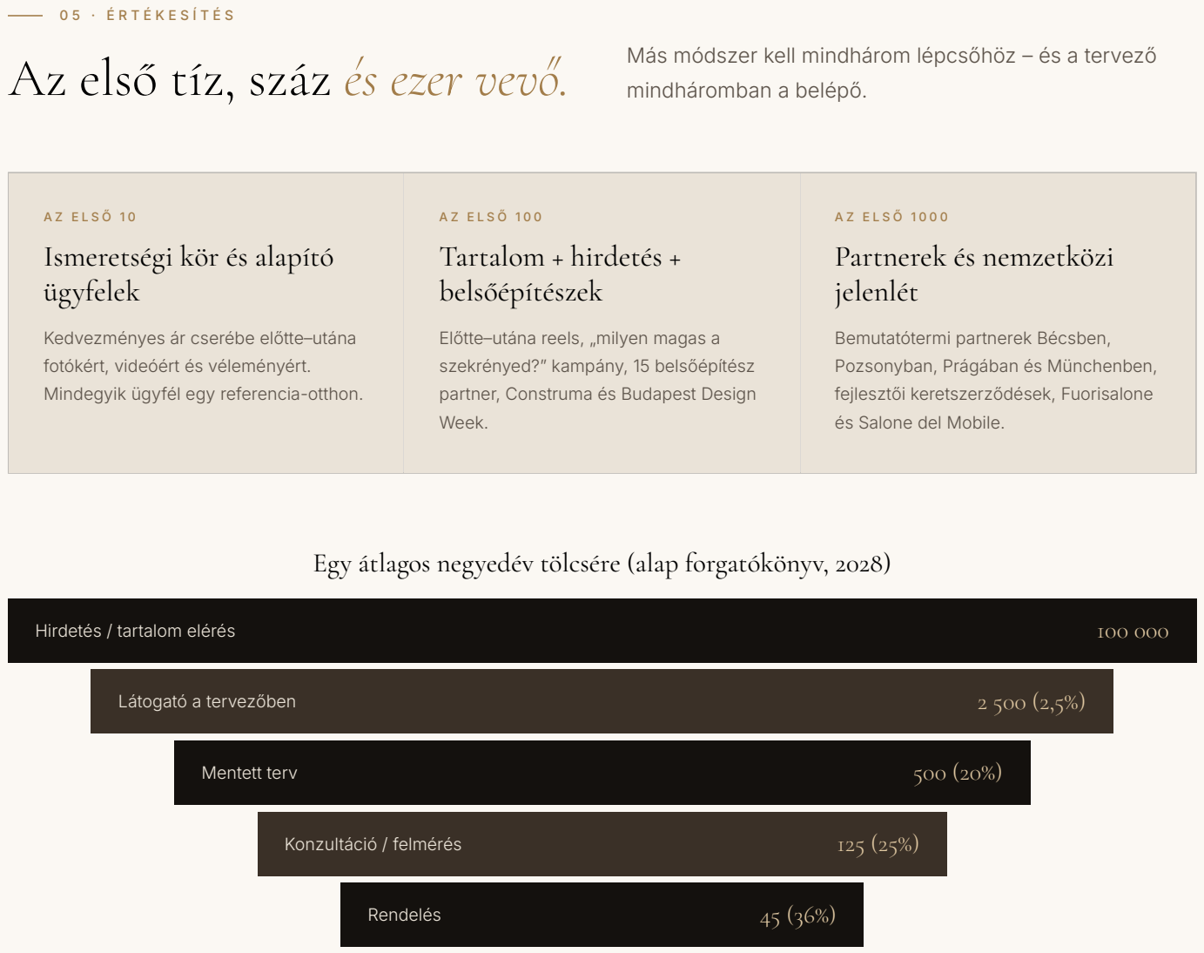
[picture p31: figure]
0 5 · É R T É K E S Í T É S Az első tíz, száz és ezer vevő.; mindháromban a belépő.; A Z E L S Ő 1 0 Ismeretségi kör és alapító ügyfelek; Kedvezményes ár cserébe előtte–utána fotókért, videóért és véleményért. Mindegyik ügyfél egy referencia-otthon.; A Z E L S Ő 1 0 0 Tartalom + hirdetés + belsőépítészek; Előtte–utána reels, „milyen magas a szekrényed?” kampány, 15 belsőépítész partner, Construma és Budapest Design Week.; A Z E L S Ő 1 0 0 0 Partnerek és nemzetközi jelenlét; Bemutatótermi partnerek Bécsben, Pozsonyban, Prágában és Münchenben,; és Salone del Mobile.; Hirdetés / tartalom elérés; Látogató a tervezőben; Mentett terv; Konzultáció / felmérés; Rendelés

Más módszer kell mindhárom lépcsőhöz – és a tervező

fejlesztői keretszerződések, Fuorisalone

## Egy átlagos negyedév tölcsére (alap forgatókönyv, 2028)

0 6 · M A R K E T I N G É S P R

# Online és fizikai térben –

ugyanazzal a csenddel.

A tartalom motorja az előtte–utána: minden beépítésből fotó, rövid videó és vélemény lesz.

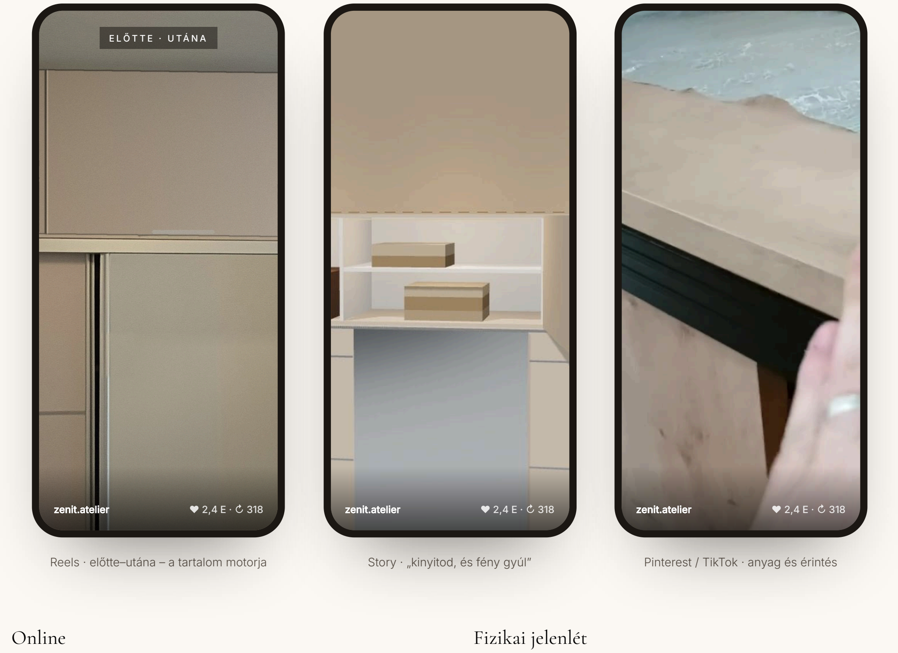
[picture p32: figure]
Online; Fizikai jelenlét

Reels · előtte–utána – a tartalom motorja | Story · „kinyitod, és fény gyúl” | Pinterest / TikTok · anyag és érintés

SEO és tartalom. „szekrény fölötti tér”, „gardrób magasítás”, „plafonig érő szekrény” kulcsszavak; útmutatók, mérési segédlet, előtte–utána galéria.

Meta és Pinterest. Előtte–utána reels, carousel a tervezőből, retargeting a mentett tervekre; Pinterest-táblák lakberendezőknek.

Google Search. Magas szándékú keresések (egyedi gardrób, szekrény plafonig, beépített szekrény ár) – a tervezőre irányítva.

YouTube és TikTok. Szerelési videó, „3 óra alatt plafonig” time-lapse, belsőépítész-interjúk, a műhely kulisszái.

Influencerek. 8–12 lakberendezési mikroinfluenszer (10–80 ezer követő) – valódi beépítéssel, nem fizetett képpel.

CRM és hírlevél. Mentett terv → emlékeztető, mintadoboz-ajánlat, ünnepi kampány; ajánlói program: 25 000 Ft kupon mindkét félnek.

Kiállítások. Construma (Hungexpo, 2027. ápr. 8–11.), Budapest Design Week (október), Vienna Design Week, Designblok Prága.

Milánó. 2027: látogatás és kapcsolatépítés · 2028: Fuorisalone pop-up · 2029: Salone del Mobile vagy SaloneSatellite (35 év alatti tervezőknek).

Bemutatóterem. Budapesti „atelier” időponttal – mintafal 3 színnel, élő tervezővel; később shop-in-shop partnereknél.

Sajtó és díjak. Lakáskultúra, Elle Decoration, Otthon; nemzetközileg Dezeen, Designboom. Valódi nevezés: Magyar Formatervezési Díj, German Design Award, Red Dot.

Partnerprogram. Belsőépítészeknek mintadoboz, tervezői belépés, 10% jutalék és közös referenciafotózás.

Fejlesztők. Mintalakás-beépítés prémium projektekben, „Plafonig” felárcsomag a vevői menüben.

zenit.atelier | ♥ 2,4 E · ↻ 318 | zenit.atelier | ♥ 2,4 E · ↻ 318 | zenit.atelier | ♥ 2,4 E · ↻ 318

Három kör Európában.

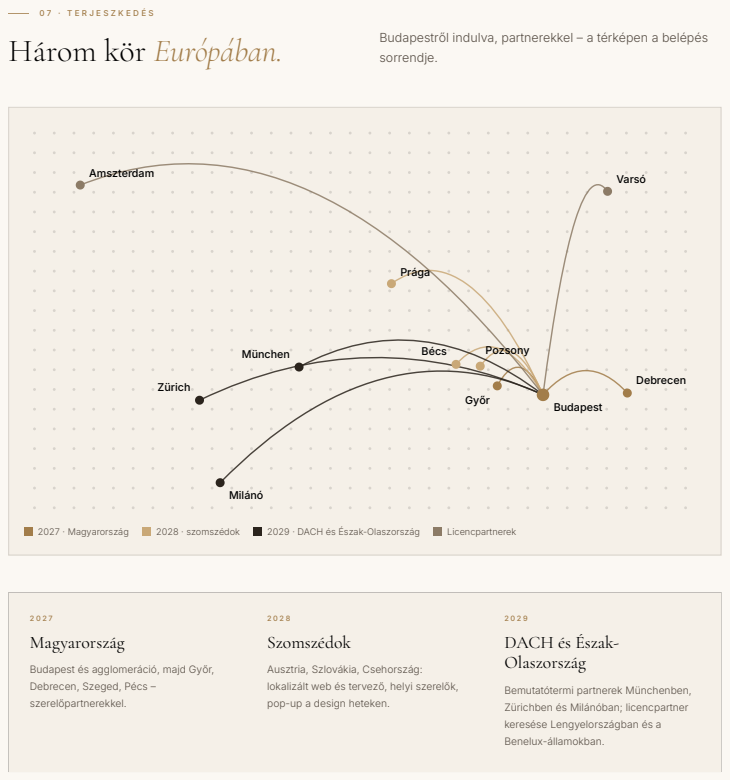
[picture p33: page 9]
Budapest; Győr; Debrecen; Bécs; Pozsony; Prága; München; Zürich; Milánó; Varsó Amszterdam; 2027 · Magyarország; 2028 · szomszédok; 2029 · DACH és Észak-Olaszország; Licencpartnerek; 2 0 2 7 Magyarország; 2 0 2 8 Szomszédok; 2 0 2 9 DACH és Észak- Olaszország

Budapestről indulva, partnerekkel – a térképen a belépés
sorrendje.

Budapest és agglomeráció, majd Győr,
Debrecen, Szeged, Pécs –
szerelőpartnerekkel.

Ausztria, Szlovákia, Csehország:
lokalizált web és tervező, helyi szerelők,
pop-up a design heteken.

Bemutatótermi partnerek Münchenben,
Zürichben és Milánóban; licencpartner
keresése Lengyelországban és a
Benelux-államokban.

0 8 · M Ű K Ö D É S É S C S A P A T
Kicsi csapat, erős partnerek.
0 1 Cégforma Kft., 3 M Ft törzstőke; alapítás ügyvéddel, egyszerűsített eljárásban. | 0 2 Védjegy Előzetes névkutatás (ZENIT/Zenith ütközés!), majd HU és EUIPO bejelentés – EU-ban 1 osztály 850 €, 2 osztály 900 €. | 0 3 Gyártás Partner asztalosüzem CNC-vel és élzáróval; a 3D modellből gépi fájl; Häfele vasalat keretszerződéssel; minőségellenőrzés nálunk.
0 4 Szerelés Saját kétfős csapat Budapesten, alvállalkozó szerelők vidéken és külföldön, egységes szerelési protokoll és kézikönyv. | 0 5 Jog és pénzügy ÁSZF (egyedi gyártás – elállási kivétel), 3 év kötelező jótállás 250 e Ft felett, termékfelelősség-biztosítás, online könyvelés. | 0 6 Rendszerek Saját tervező + webshop, Barion/Stripe fizetés, HubSpot vagy Pipedrive CRM, felmérő app, gyártási ütemező tábla.

## Csapat évente

2027. 2 alapító (értékesítés és termék) + 1 szerelő (H2-től), külsős marketing és könyvelés.

2028. + ügyfélkapcsolati vezető, + szerelő, + DACH/CEE partnermenedzser (részmunkaidő).

2029. + marketingvezető, + 2 szerelő, + gyártáskoordinátor; országonkénti partnerhálózat.

## Az első 90 nap

1. Névkutatás és védjegybejelentés
2. Kft. alapítása, bankszámla, könyvelő
3. Két gyártópartner ajánlata, próbagyártás
4. ÁSZF, jótállási jegy, biztosítás
5. Webshop és fizetés élesítése
6. 20 alapító ügyfél kiválasztása
7. Construma-stand foglalása (korai ár)

0 9 · P É N Z Ü G Y I T E R V

# Három év, három

forgatókönyv.

Nettó, ezer forintos negyedéves modell; árfolyam 390 Ft/ €. Az óvatos forgatókönyv 60%-os darabszámmal és karcsúbb költségekkel, az optimista 140%-kal számol.

## Árbevétel évente · M Ft

Óvatos | Alap | Optimista

22,4

37,2

52,0

2027

93,5

155,8

218,0

2028

256,4

427,6

598,8

2029

## Halmozott pénzállás negyedévente · M Ft

0

-50

+50

+100

2027 | 2028 | 2029

Óvatos

Optimista

Alap

legnagyobb tőkeigény: 55,2 M Ft

## Eladott darabszám csatornánként · alap forgatókönyv

2027 | 125 | 143 db
2028 | 300 | 90 | 105 | 518 db
2029 | 455 | 170 | 304 | 340 | 1269 db
HU közvetlen (D2C) | Belsőépítészek, fejlesztők | CEE közvetlen (AT·SK·CZ) | DACH·IT partnerek
ALAP FORGATÓKÖNYV · M FT | 2027 | 2028 | 2029
Eladott darab | 143 | 518 | 1 269
Nettó árbevétel | 37,2 | 155,8 | 427,6
Közvetlen költség (gyártás, szerelés, szállítás) | 19,8 | 79,7 | 214,4
Fedezet | 17,3 | 76,0 | 213,2
Működési költség | 44,0 | 92,4 | 163,2
EBITDA | -26,7 | -16,4 | 50,0
Halmozott pénzállás (év végén) | -30,7 | -51,5 | -9,5

ÓVATOS FORGATÓKÖNYV · M FT | 2027 | 2028 | 2029
Eladott darab | 86 | 311 | 761
Nettó árbevétel | 22,4 | 93,5 | 256,4
Közvetlen költség (gyártás, szerelés, szállítás) | 11,9 | 47,9 | 128,6
Fedezet | 10,4 | 45,7 | 127,8
Működési költség | 32,8 | 67,3 | 118,1
EBITDA | -22,4 | -21,6 | 9,8
Halmozott pénzállás (év végén) | -26,4 | -52,5 | -50,7
OPTIMISTA FORGATÓKÖNYV · M FT | 2027 | 2028 | 2029
Eladott darab | 200 | 725 | 1 777
Nettó árbevétel | 52,0 | 218,0 | 598,8
Közvetlen költség (gyártás, szerelés, szállítás) | 27,8 | 111,6 | 300,3
Fedezet | 24,2 | 106,4 | 298,6
Működési költség | 44,0 | 92,4 | 163,2
EBITDA | -19,8 | 14,0 | 135,4
Halmozott pénzállás (év végén) | -23,8 | -14,2 | 113,2

## Egységgazdaságtan

CSATORNA | NETTÓ ÁR / DB | KÖZVETLEN KÖLTSÉG / DB | FEDEZET
HU közvetlen (D2C) | 265 eFt | 140 eFt | 47%
Belsőépítészek, fejlesztők | 225 eFt | 130 eFt | 42%

CEE közvetlen
(AT·SK·CZ)
448 eFt | 205 eFt | 54%
DACH·IT partnerek | 390 eFt | 195 eFt | 50%

A közvetlen költség tartalmazza a lapot, a megmunkálást, a Häfele-vasalatot, a fogantyút, a csomagolást, a szállítást és a szerelést. LED és tükör felár külön fedezetet hoz.

## Az első év költségvetése

Csapat (bér + járulék) | 12,5 M Ft
Marketing és hirdetés | 10,0 M Ft
Kiállítás, design hét, pop-up | 7,8 M Ft
Bemutatóterem, minták | 6,1 M Ft
Beruházás (minták, eszközök) | 4,0 M Ft
Jog, könyvelés, védjegy, biztosítás | 3,0 M Ft
Szoftver, web, tervező | 2,4 M Ft
Egyéb, utazás, tartalék | 2,2 M Ft
Összesen kb. 48,0 M Ft. A Construma-stand 24 m²-en a korai árral (170–195 €/m²) és építéssel kb. 4 M Ft.

## Megtérülés

Alap: pozitív EBITDA 2028 Q4-től, a legmélyebb pénzállás 2029 Q2-ben kb. 55,2 M Ft, a halmozott megtérülés 2030 elején.
Óvatos: pozitív EBITDA 2029 Q3-tól, kb. 67,4 M Ft tőkeigény, megtérülés 2031 körül.
Optimista: pozitív EBITDA 2028 Q3-tól, kb. 32,3 M Ft tőkeigény, a halmozott megtérülés 2029 Q2-ben.

## Finanszírozás (alap)

8 M Ft alapítói saját forrás
20–25 M Ft kedvezményes vállalkozói hitel (pl. Széchenyi Kártya Program)
30 M Ft angyalbefektető, két mérföldkőhöz kötve (100. és 400. eladás)
2028-tól exportpiaci és innovációs pályázatok figyelése

1 0 · K O C K Á Z A T O K
Ami elsőre nem fog menni.
KOCKÁZAT | MI TÖRTÉNHET? | VÁLASZ
Rejtett igény | Kevesen keresnek rá a „szekrény fölötti térre”. | Problémát mutató tartalom (előtte–utána), és a tervező mint játékos belépő.
Ár-érzékenység itthon | Helyi asztalos olcsóbb. | Sebesség, garantált illeszkedés, design, Örökgarancia; részletfizetés.
Gyártói kapacitás | Partnernél csúszás. | Két gyártópartner, sorozatba rendezett gyártási napok, 2029-től saját CNC- cella.
Utánzás | Nagy szereplők lemásolják. | Márka, közösség, partnerhálózat, a tervező és a szerelési protokoll mint előny; formatervezési minta oltalom.
Export-logisztika | Szállítás és szerelés drága. | Lapra szerelt csomag, helyi szerelőpartnerek, régiónkénti gyűjtőszállítás.
Finanszírozás | Lassabb növekedés. | Óvatos forgatókönyv karcsú költségekkel; mérföldkőhöz kötött befektetési részletek.

F O R R Á S O K
Amire a számok épülnek.
1. Salone del Mobile 2027 időpont (https://www.salonemilano.it/en/articles/salone-del-mobile-2027-dates)
2. CONSTRUMA 2027 kiállítói anyag (időpont, m²-ár) (https://hungexpo.hu/wp-content/uploads/CONSTRUMA2027_kiallitoi_prezi_EN.pdf)
3. Budapest Design Week 2025 (Time Out) (https://www.timeout.com/hu/budapest/hirek/hamarosan-kezdodik-a-budapest-design-week-2025-100725)
4. EU védjegy díjak 2026 (https://tmarkmetric.com/insights/eu-trademark-cost)
5. Fitted wardrobe market (DataHorizzon) (https://datahorizzonresearch.com/fitted-wardrobe-market-38623)
6. Bútorpiac, IKEA és XXXLutz számok (Pénzcentrum) (https://www.penzcentrum.hu/vallalkozas/20210606/folytatodik-a-magyar-butorhaboru-lenyomhatja-az-ikea-t-a-tronkovetelo-xxxlutz-1115167/amp)
7. Tylko – vélemények, 28 ország (https://tylko.com/en-dk/review-list)
8. deinSchrank.de felvásárlása (2023) (https://www.unternehmeredition.de/rheinische-moebelwerke-kauft-deinschrank-de/)
9. Kft. alapítás költségei (https://financera.hu/befektetes/cegalapitas-menete/)
10. Facebook hirdetési benchmarkok 2026 (https://influee.co/hu/blog/facebook-ads-benchmarks)

Minden más szám – darabszám, ár, költség, konverzió – tervezői becslés. A ZENIT márka, a díjak és az események a látványprojekt részeként kitaláltak.
