mbolgar11/zenit/assets/img/fusion_inside.png

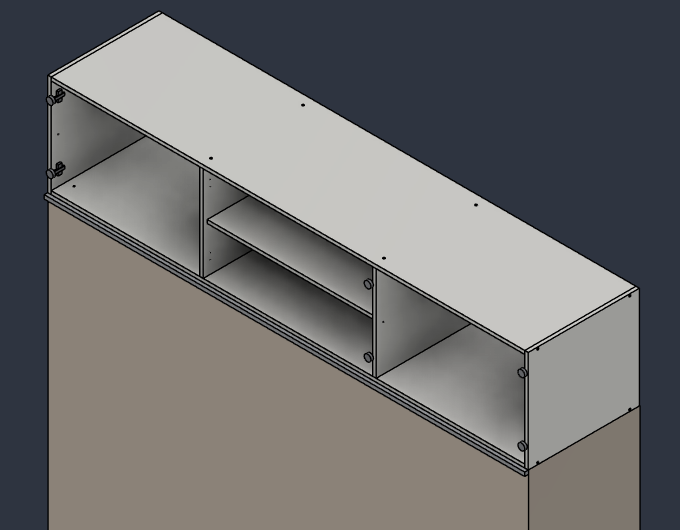
assets/img/fusion_inside.png
