mbolgar11/zenit/assets/img/og/anyagok.jpg

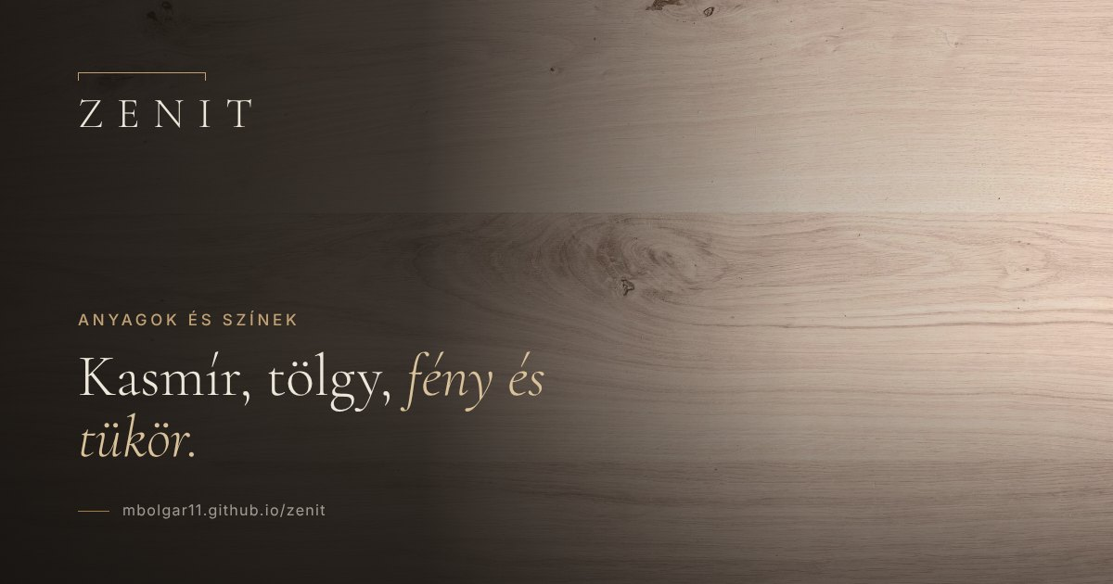
assets/img/og/anyagok.jpg
