mbolgar11/zenit/assets/img/og/aszf.jpg

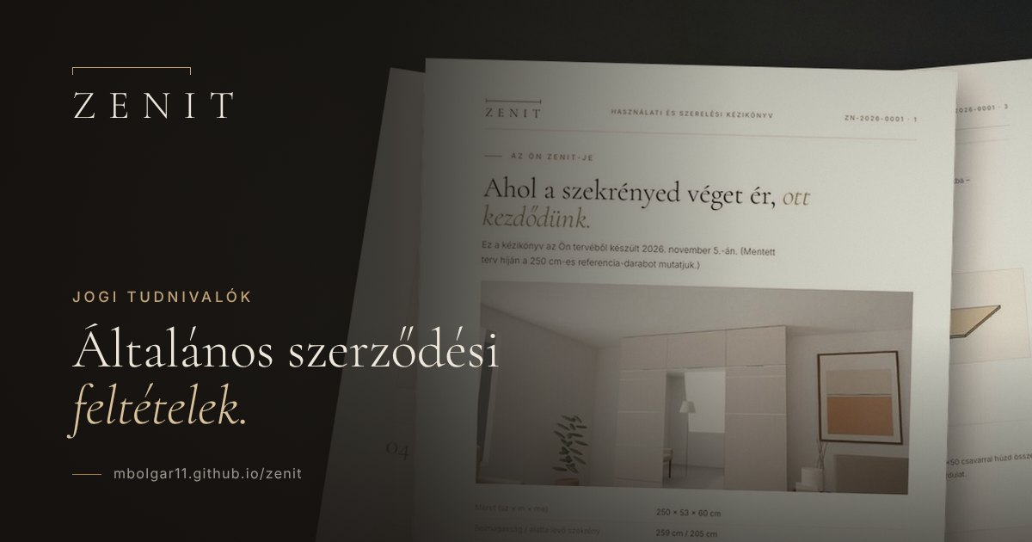
assets/img/og/aszf.jpg
