mbolgar11/zenit/assets/img/og/concierge.jpg

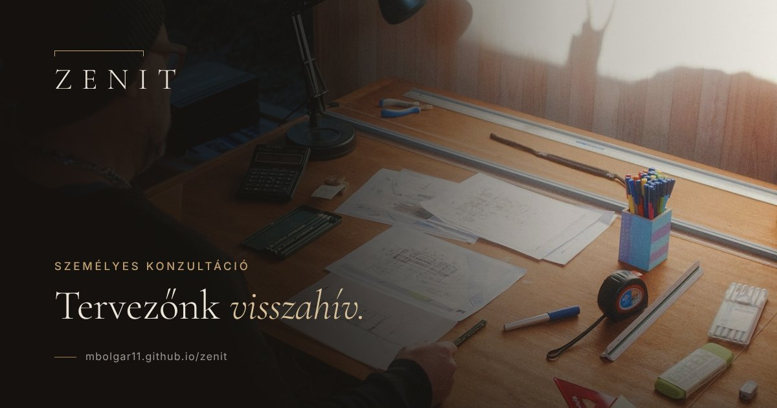
assets/img/og/concierge.jpg
