mbolgar11/zenit/assets/img/og/garancia.jpg

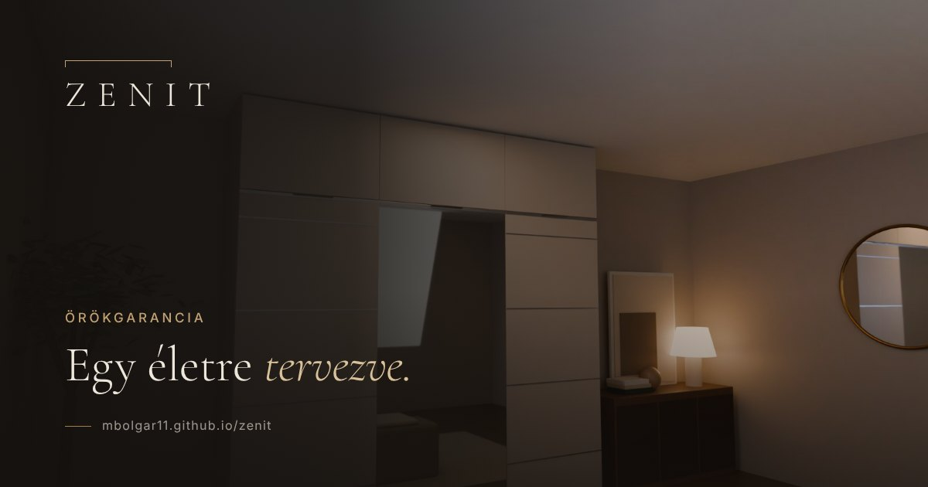
assets/img/og/garancia.jpg
