mbolgar11/zenit/assets/img/og/index.jpg

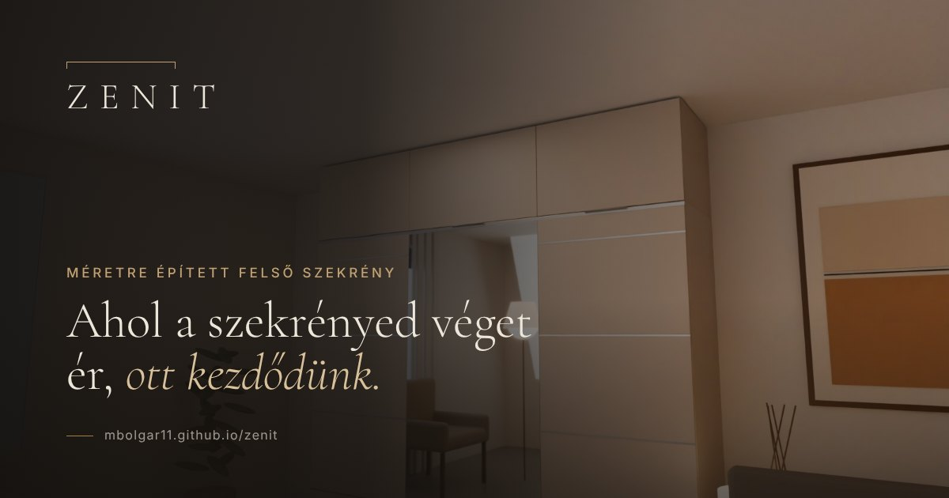
assets/img/og/index.jpg
