mbolgar11/zenit/assets/img/og/inspiracio.jpg

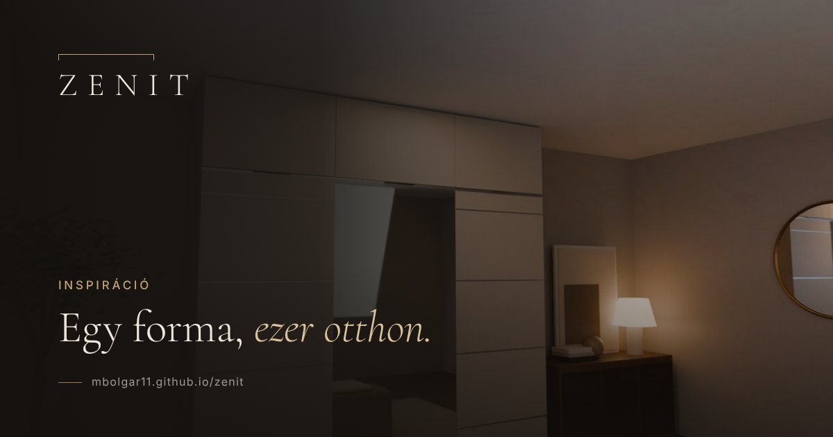
assets/img/og/inspiracio.jpg
