mbolgar11/zenit/assets/img/og/keszites.jpg

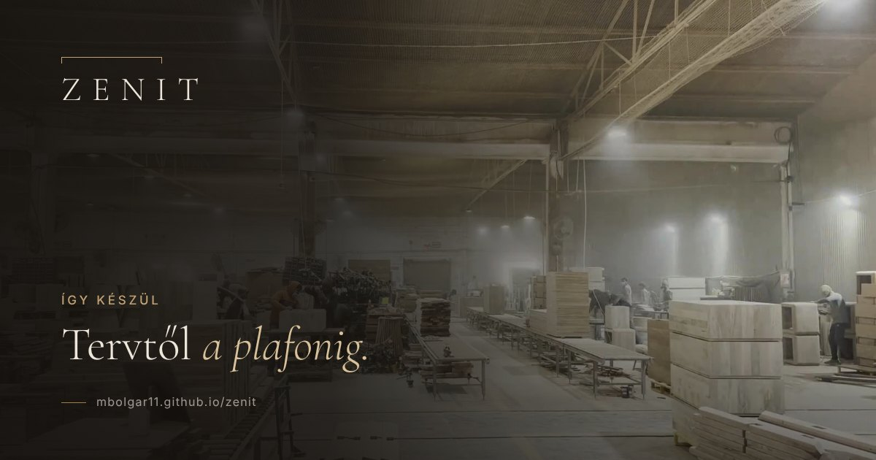
assets/img/og/keszites.jpg
