mbolgar11/zenit/assets/img/og/kezikonyv.jpg

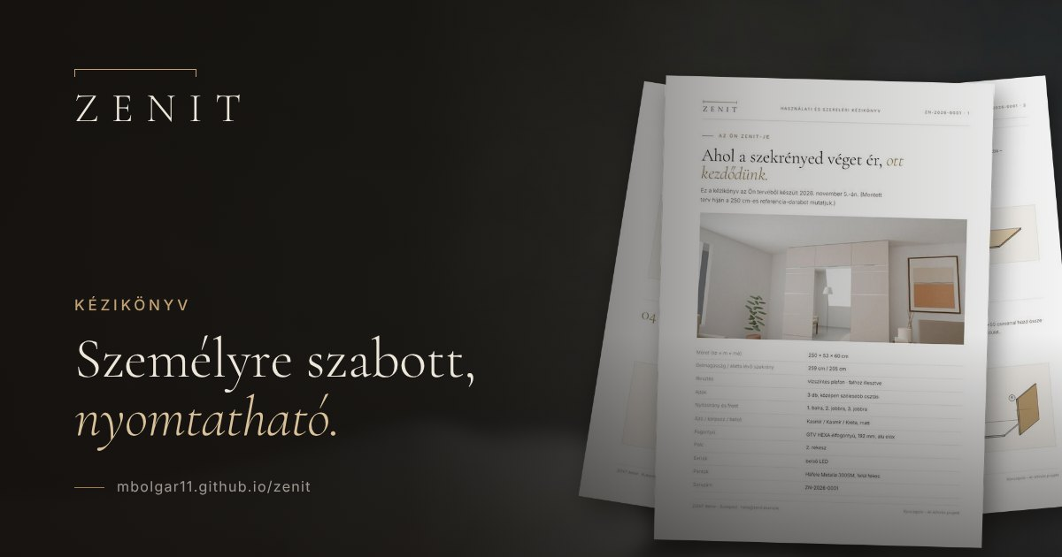
assets/img/og/kezikonyv.jpg
