mbolgar11/zenit/assets/img/og/letoltes.jpg

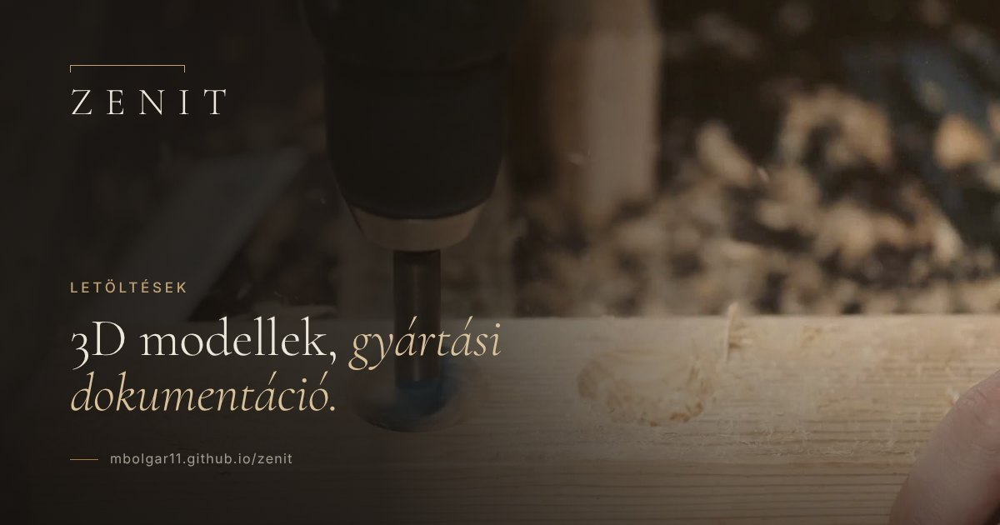
assets/img/og/letoltes.jpg
