mbolgar11/zenit/assets/img/og/manufaktura.jpg

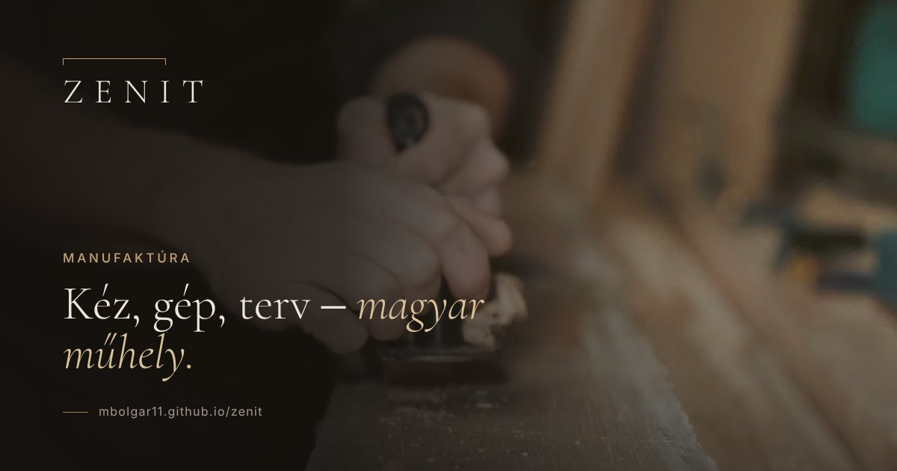
assets/img/og/manufaktura.jpg
