mbolgar11/zenit/assets/img/og/naplo.jpg

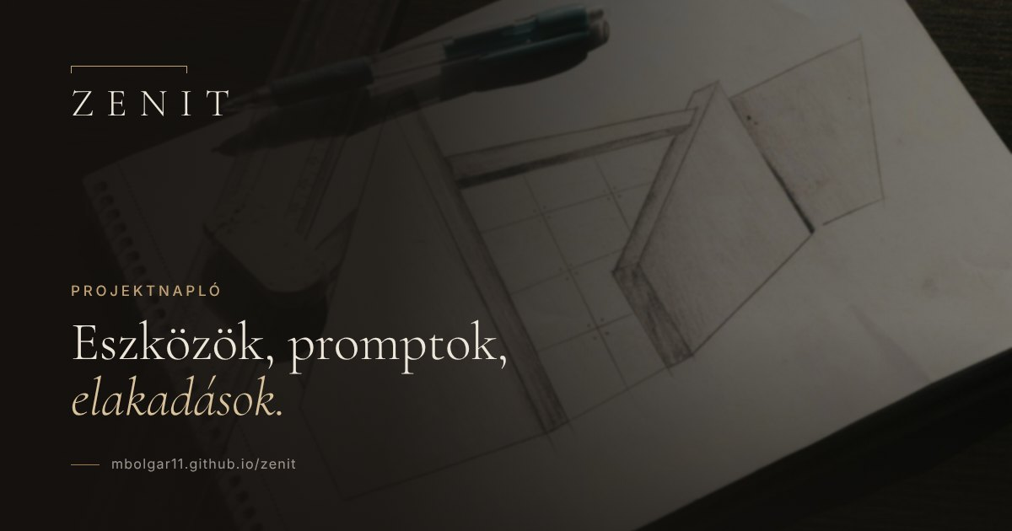
assets/img/og/naplo.jpg
