mbolgar11/zenit/assets/img/og/suti.jpg

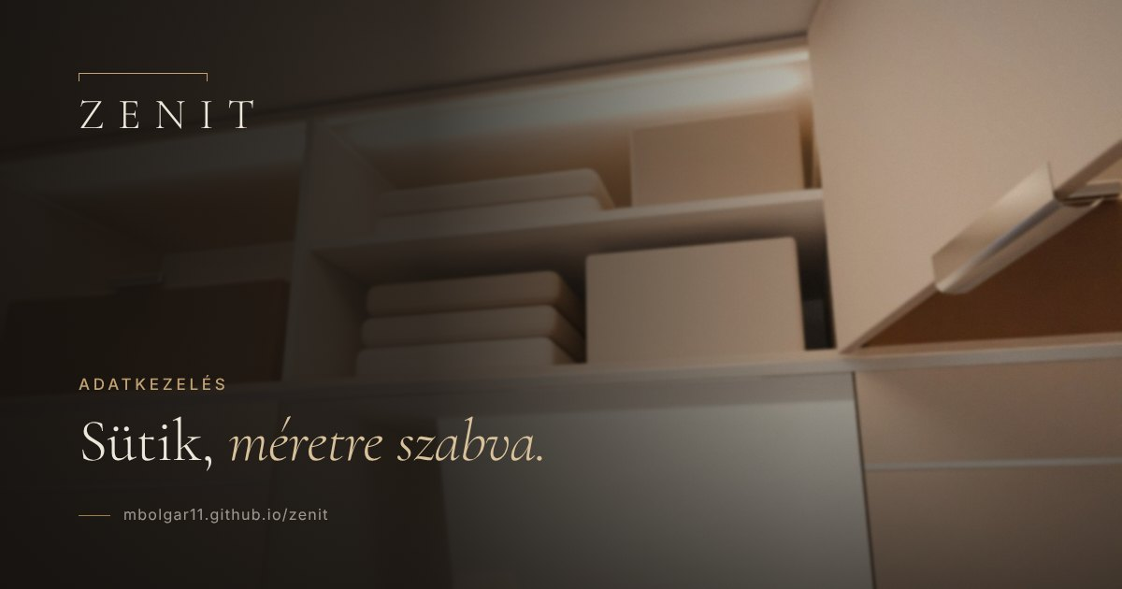
assets/img/og/suti.jpg
