mbolgar11/zenit/assets/img/og/szereles.jpg

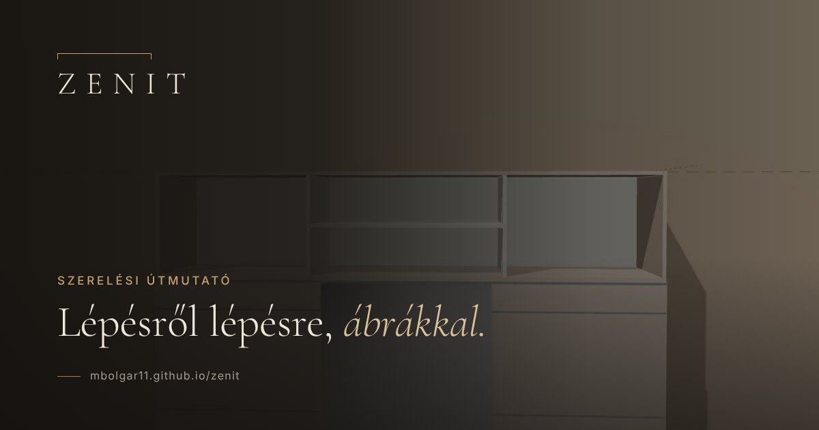
assets/img/og/szereles.jpg
