mbolgar11/zenit/assets/img/og/terv.jpg

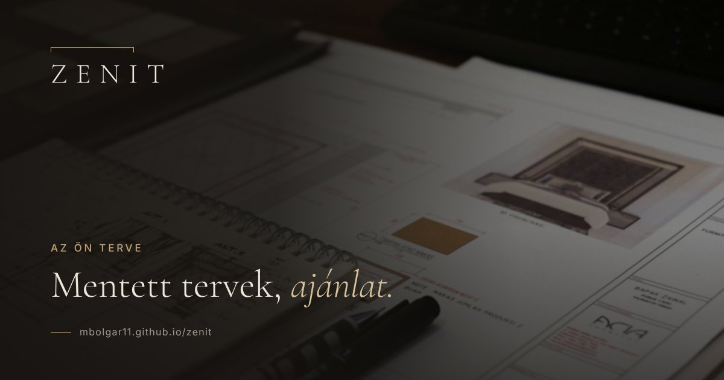
assets/img/og/terv.jpg
