mbolgar11/zenit/assets/img/og/tervezo.jpg

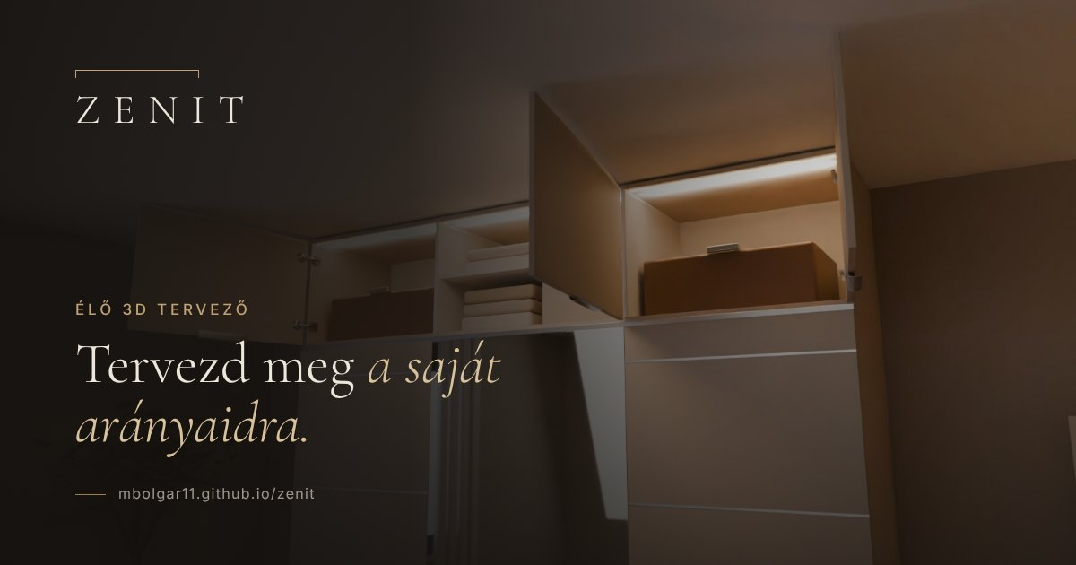
assets/img/og/tervezo.jpg
