mbolgar11/zenit/assets/img/og/uzleti-terv.jpg

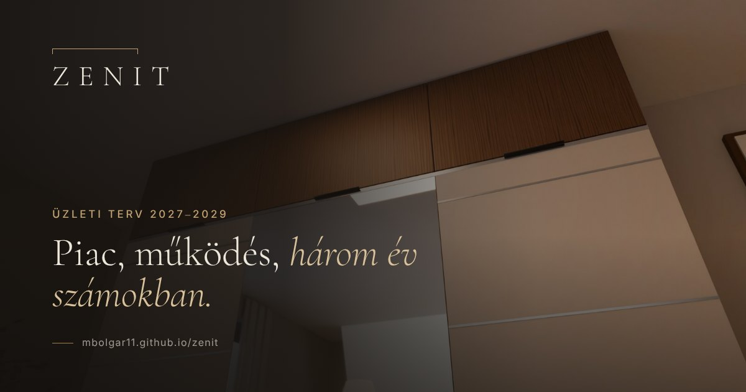
assets/img/og/uzleti-terv.jpg
