mbolgar11/zenit/assets/img/og/zenit.jpg

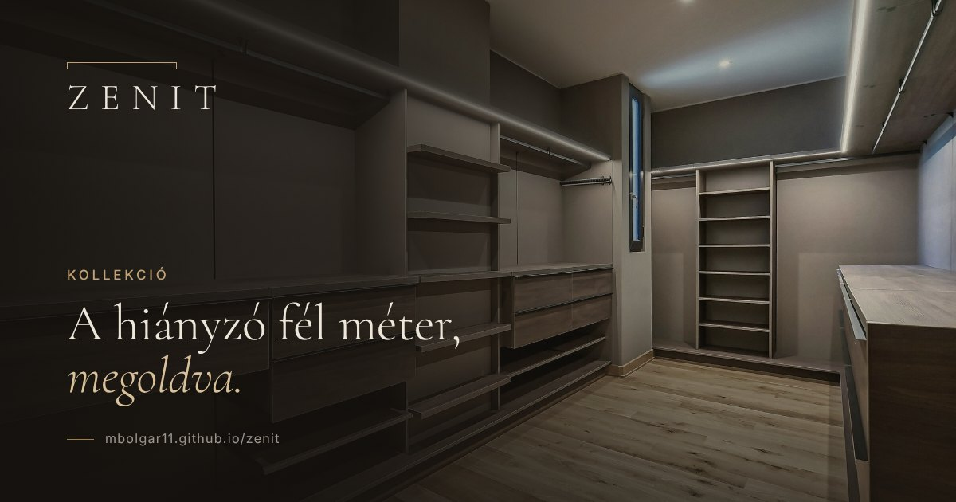
assets/img/og/zenit.jpg
