mbolgar11/zenit/assets/img/own/after_real.jpg

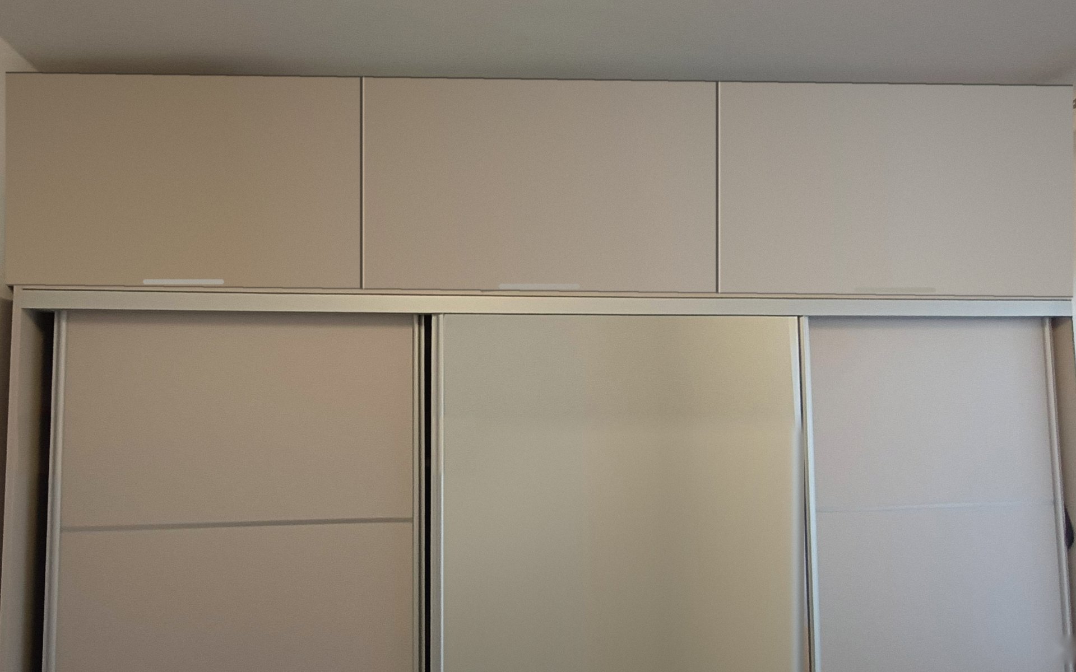
assets/img/own/after_real.jpg
