mbolgar11/zenit/assets/img/own/alapito.jpg

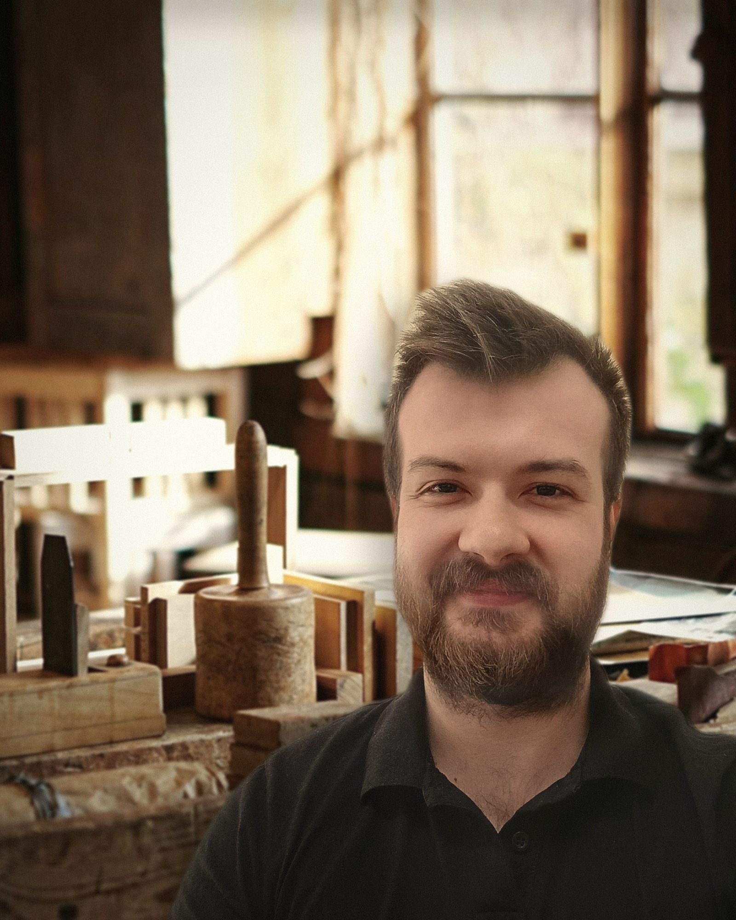
assets/img/own/alapito.jpg
