mbolgar11/zenit/assets/img/own/aszf_hero.jpg

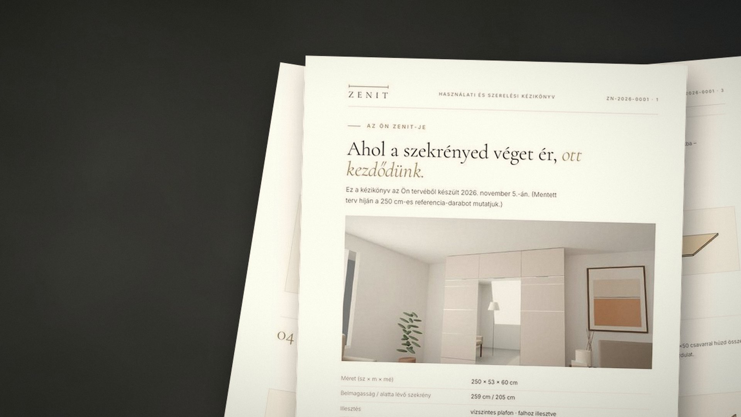
assets/img/own/aszf_hero.jpg
