mbolgar11/zenit/assets/img/own/before_real.jpg

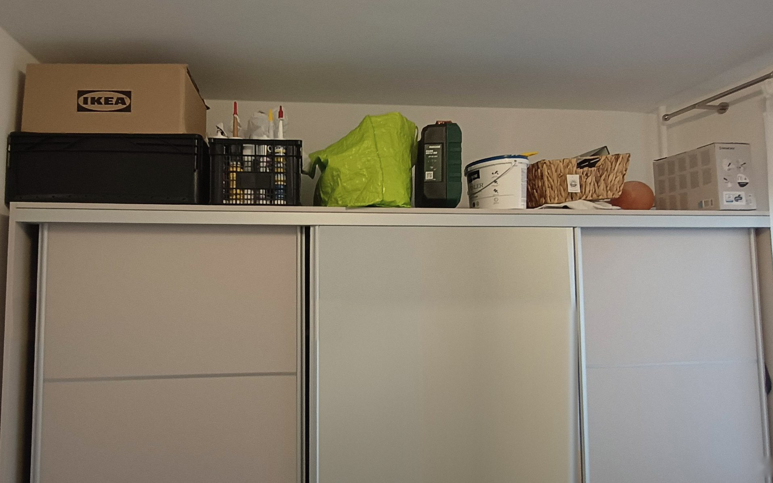
assets/img/own/before_real.jpg
