mbolgar11/zenit/assets/img/own/suti_hero.jpg

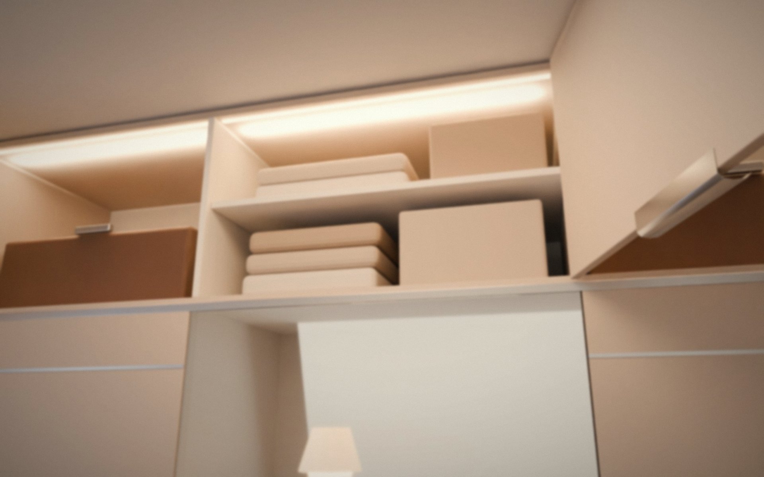
assets/img/own/suti_hero.jpg
