mbolgar11/zenit/assets/img/r2/after_day.jpg

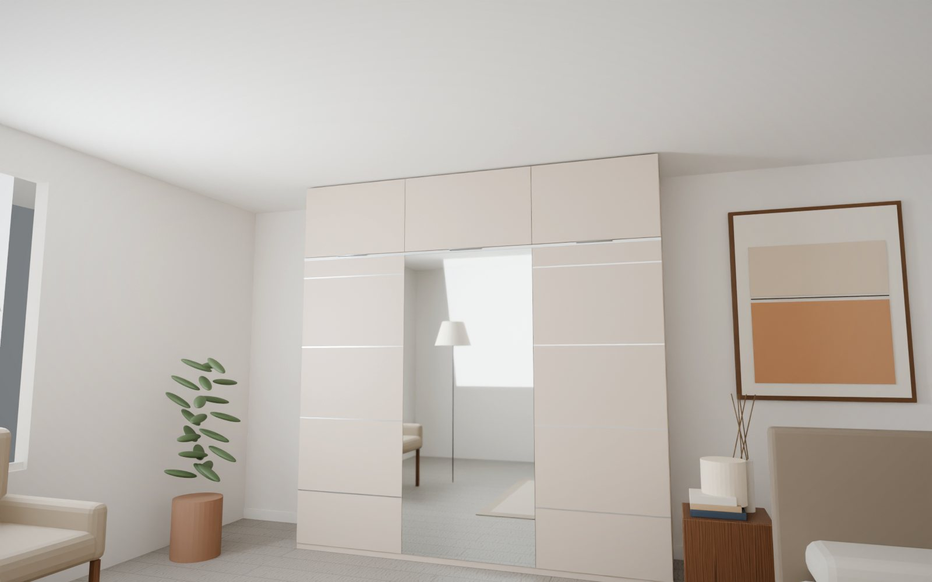
assets/img/r2/after_day.jpg
