mbolgar11/zenit/assets/img/r2/b_ejkek_evening.jpg

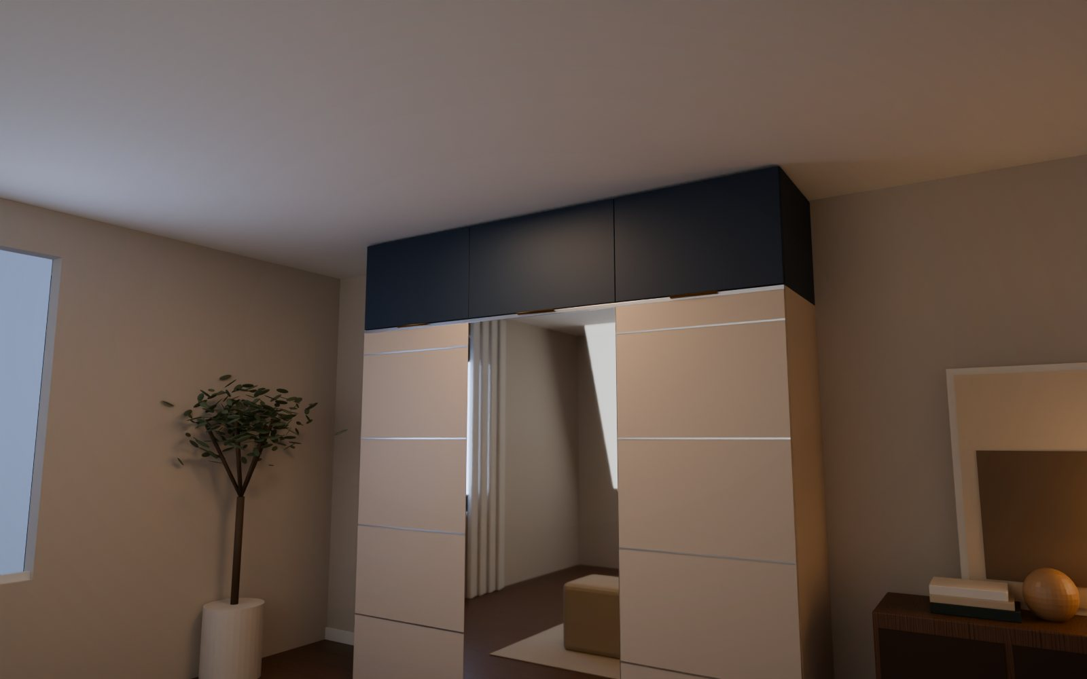
assets/img/r2/b_ejkek_evening.jpg
