mbolgar11/zenit/assets/img/r2/b_kasmir_evening.jpg

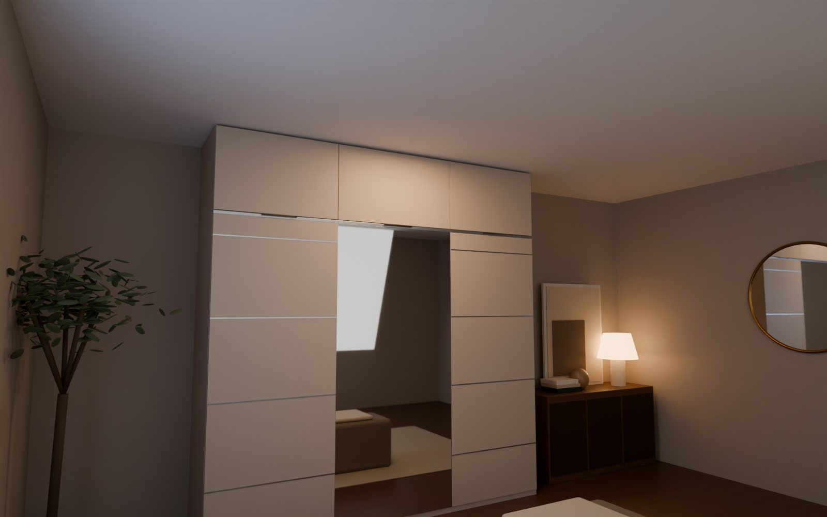
assets/img/r2/b_kasmir_evening.jpg
