mbolgar11/zenit/assets/img/r2/b_open_led.jpg

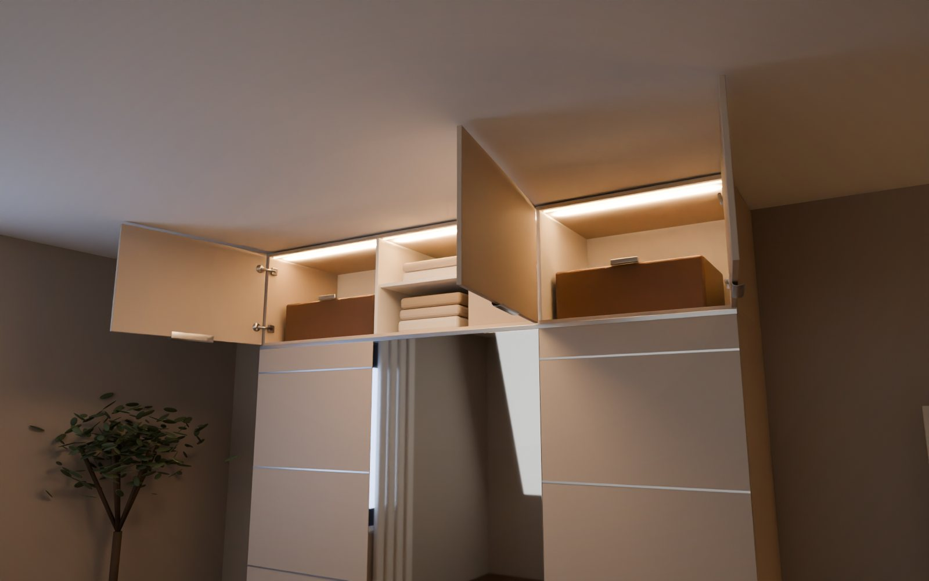
assets/img/r2/b_open_led.jpg
