mbolgar11/zenit/assets/img/r2/b_zsalya_day.jpg

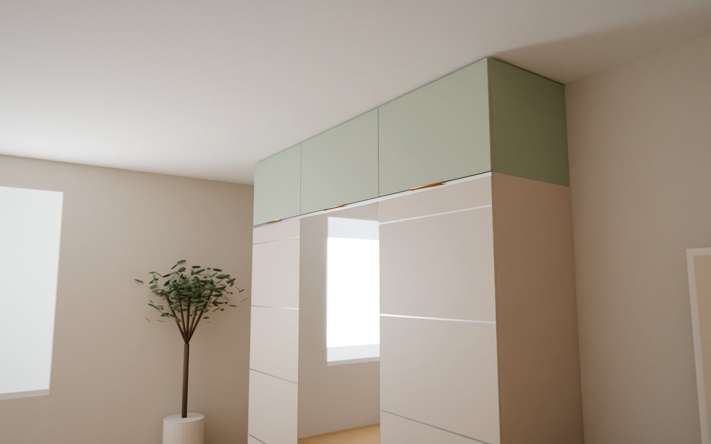
assets/img/r2/b_zsalya_day.jpg
