mbolgar11/zenit/assets/img/r2/before_day.jpg

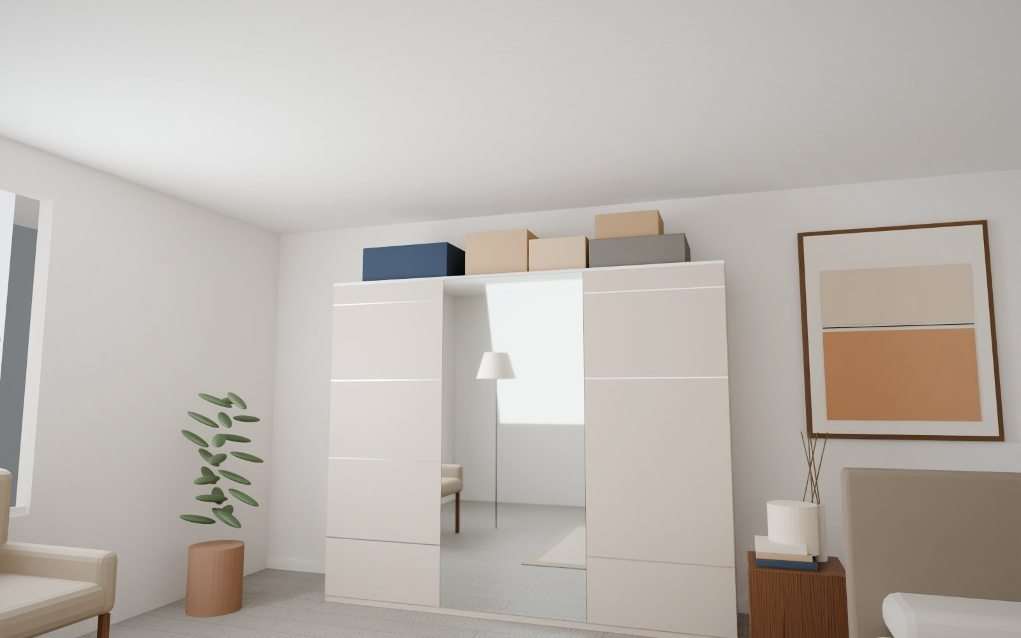
assets/img/r2/before_day.jpg
