mbolgar11/zenit/assets/img/r2/exploded.jpg

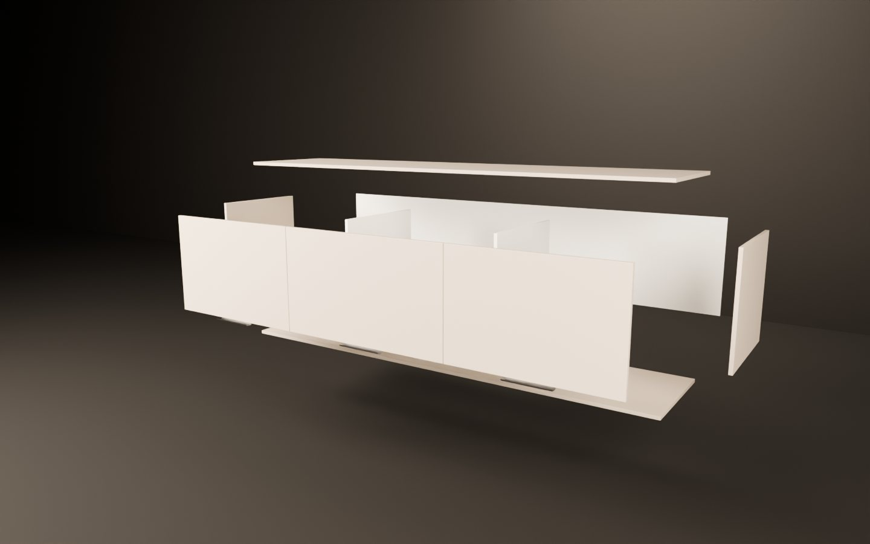
assets/img/r2/exploded.jpg
