mbolgar11/zenit/assets/img/r2/exploded_light.jpg

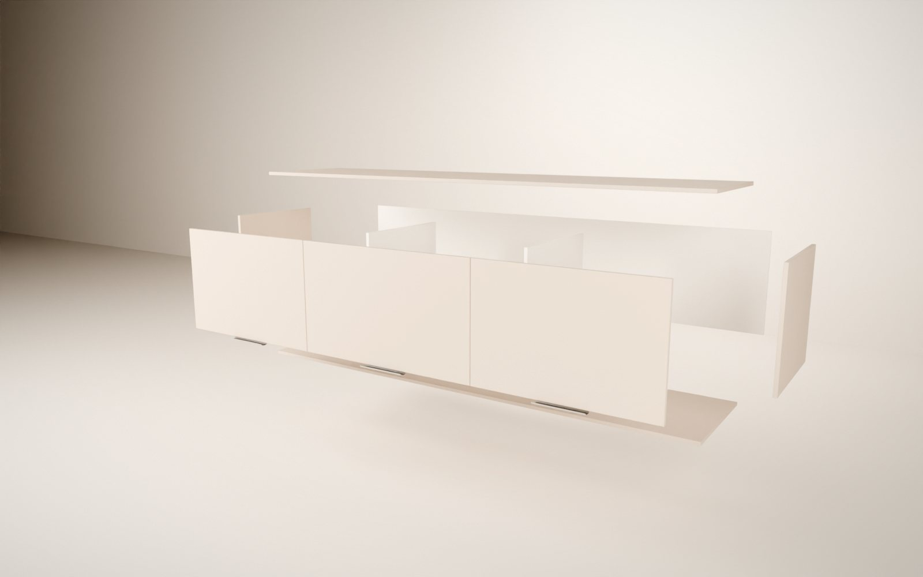
assets/img/r2/exploded_light.jpg
