mbolgar11/zenit/assets/img/r2/hero_day.jpg

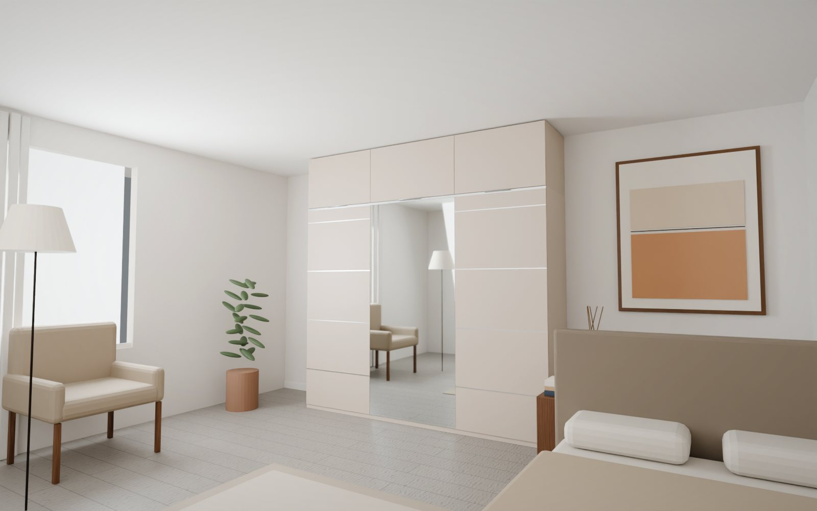
assets/img/r2/hero_day.jpg
