mbolgar11/zenit/assets/img/r2/hero_evening.jpg

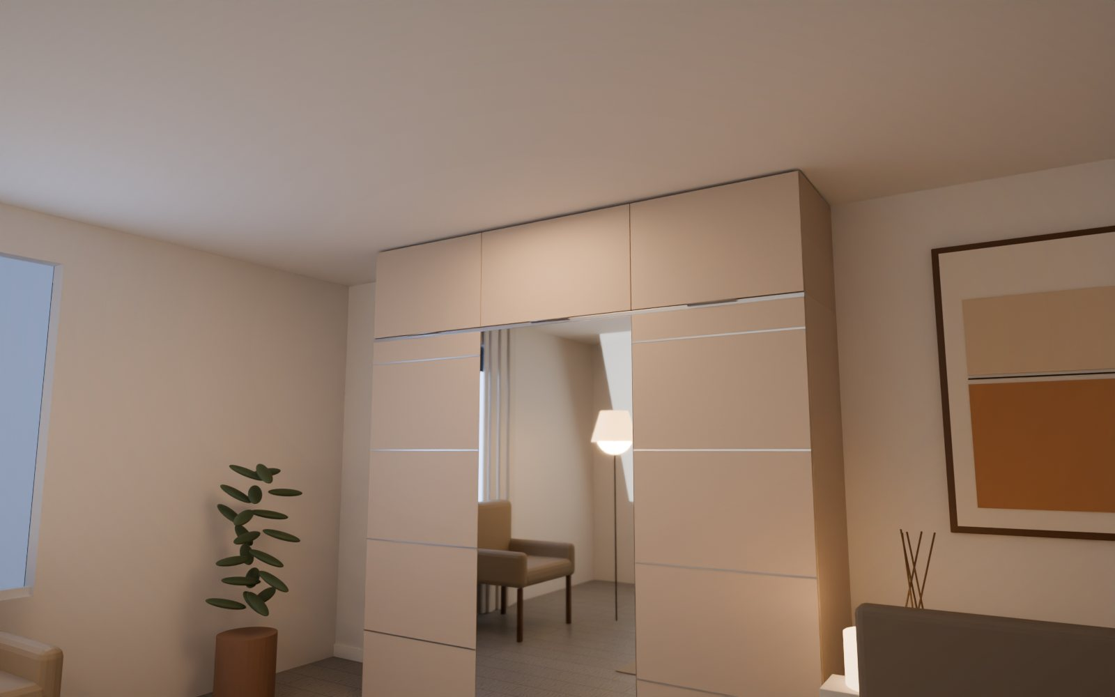
assets/img/r2/hero_evening.jpg
