mbolgar11/zenit/assets/img/r2/hinge_in.jpg

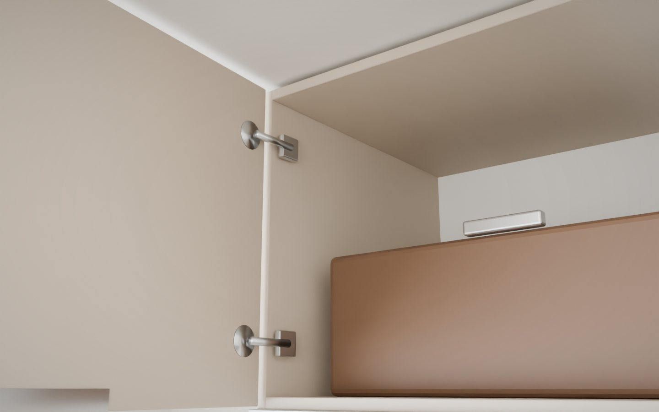
assets/img/r2/hinge_in.jpg
