mbolgar11/zenit/assets/img/r2/hinge_in_detail.jpg

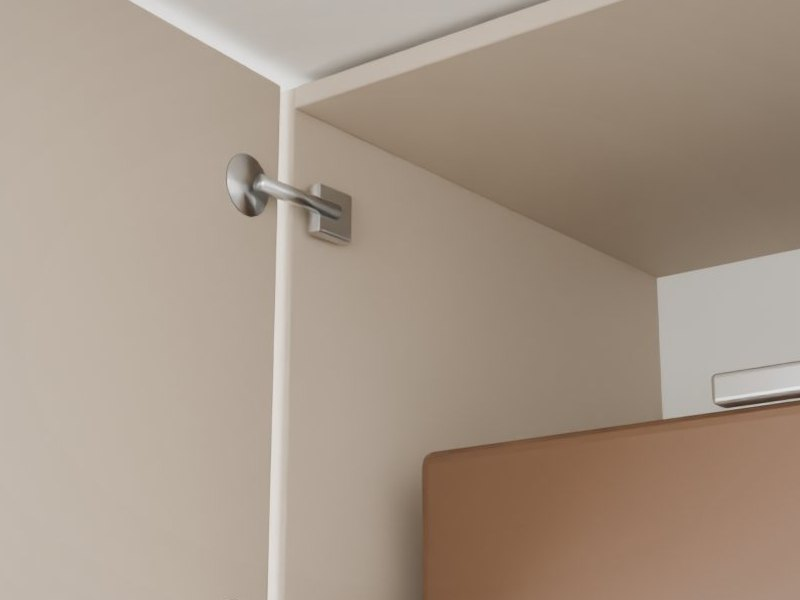
assets/img/r2/hinge_in_detail.jpg
