mbolgar11/zenit/assets/img/r2/insp_ejkek.jpg

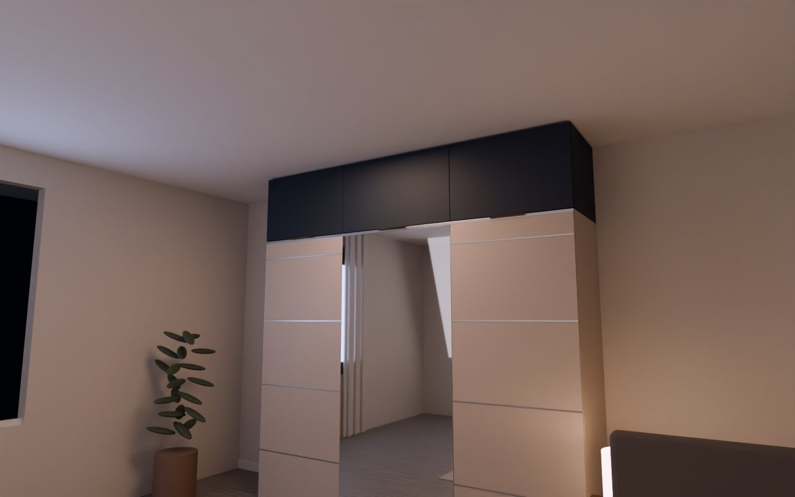
assets/img/r2/insp_ejkek.jpg
