mbolgar11/zenit/assets/img/r2/insp_kreta.jpg

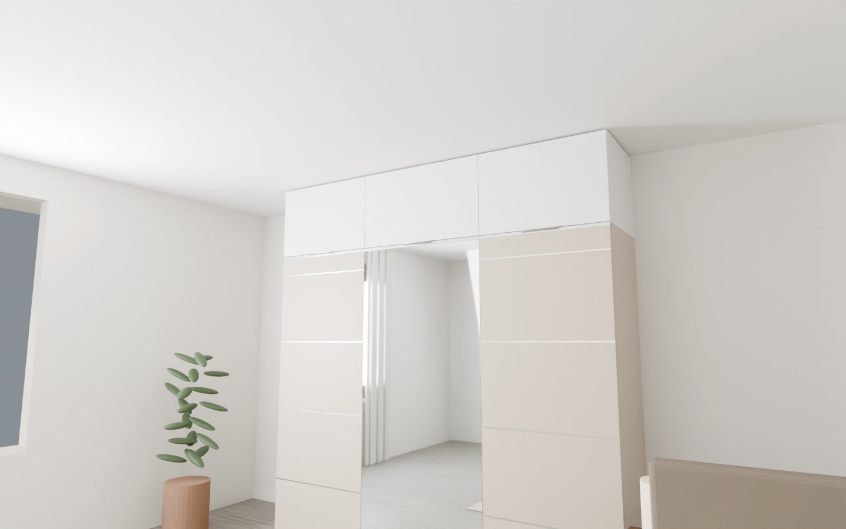
assets/img/r2/insp_kreta.jpg
