mbolgar11/zenit/assets/img/r2/kezikonyv_hero.jpg

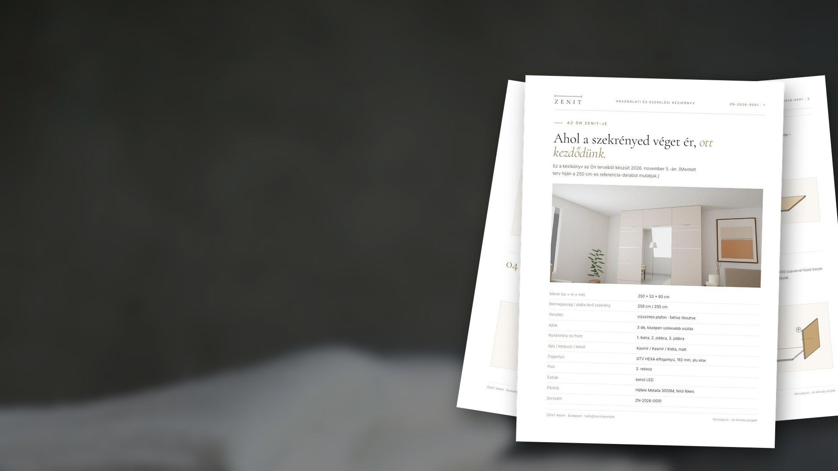
assets/img/r2/kezikonyv_hero.jpg
