mbolgar11/zenit/assets/img/r2/macro_edge.jpg

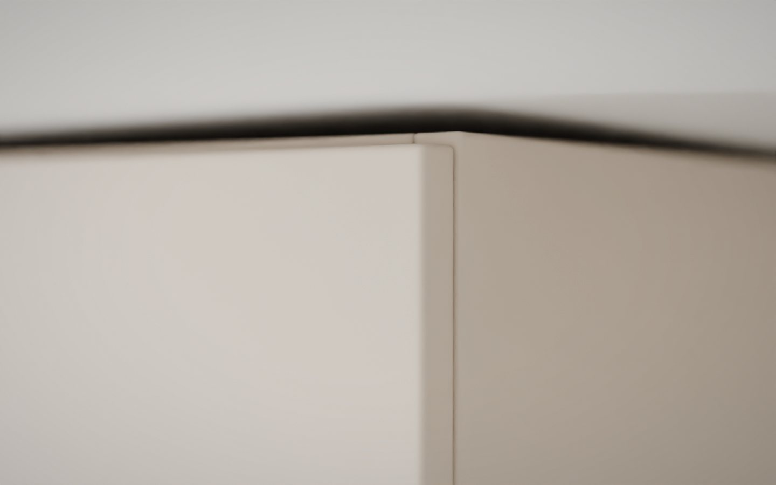
assets/img/r2/macro_edge.jpg
