mbolgar11/zenit/assets/img/r2/macro_handle.jpg

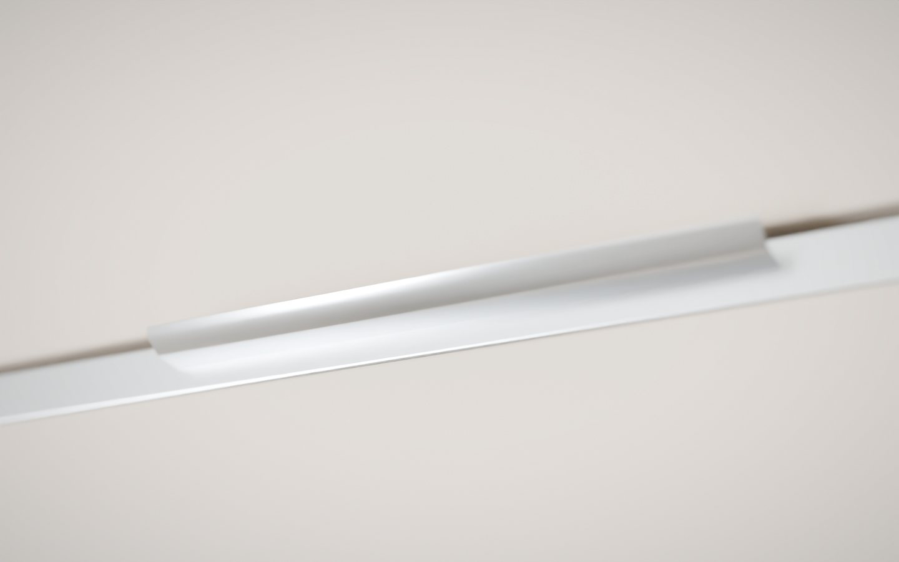
assets/img/r2/macro_handle.jpg
