mbolgar11/zenit/assets/img/r2/macro_hinge.jpg

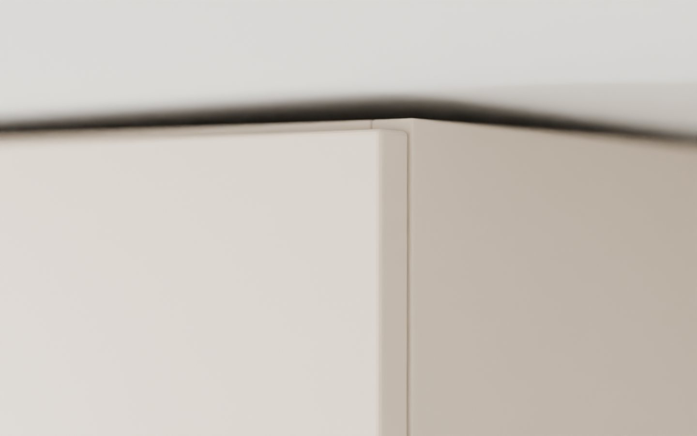
assets/img/r2/macro_hinge.jpg
