mbolgar11/zenit/assets/img/r2/mirror_day.jpg

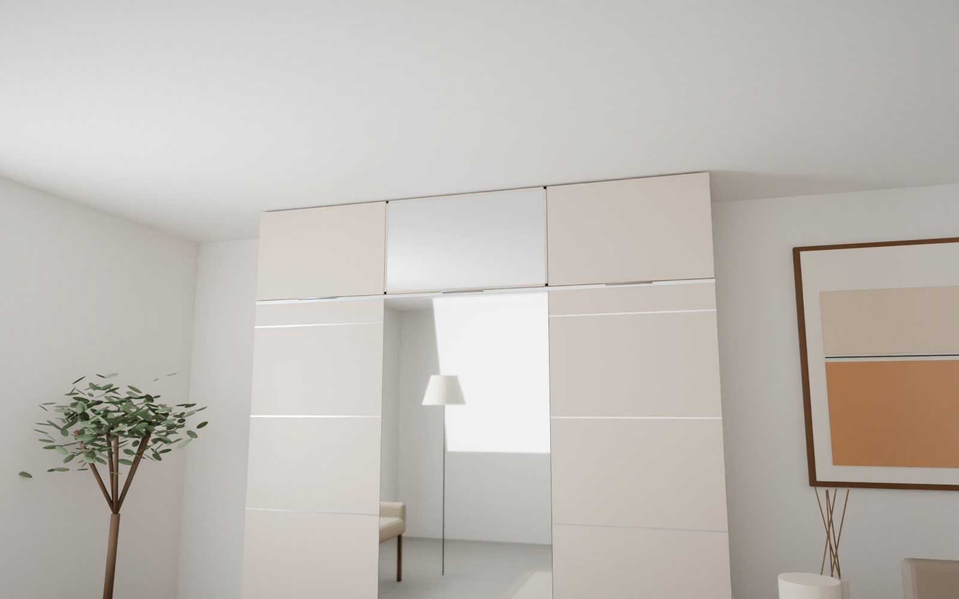
assets/img/r2/mirror_day.jpg
