mbolgar11/zenit/assets/img/r2/open_led.jpg

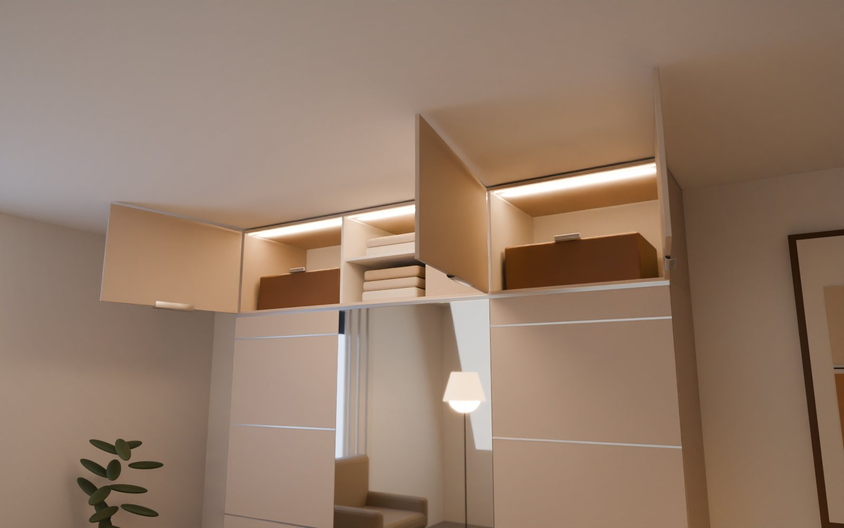
assets/img/r2/open_led.jpg
