mbolgar11/zenit/assets/img/r2/story_morning.jpg

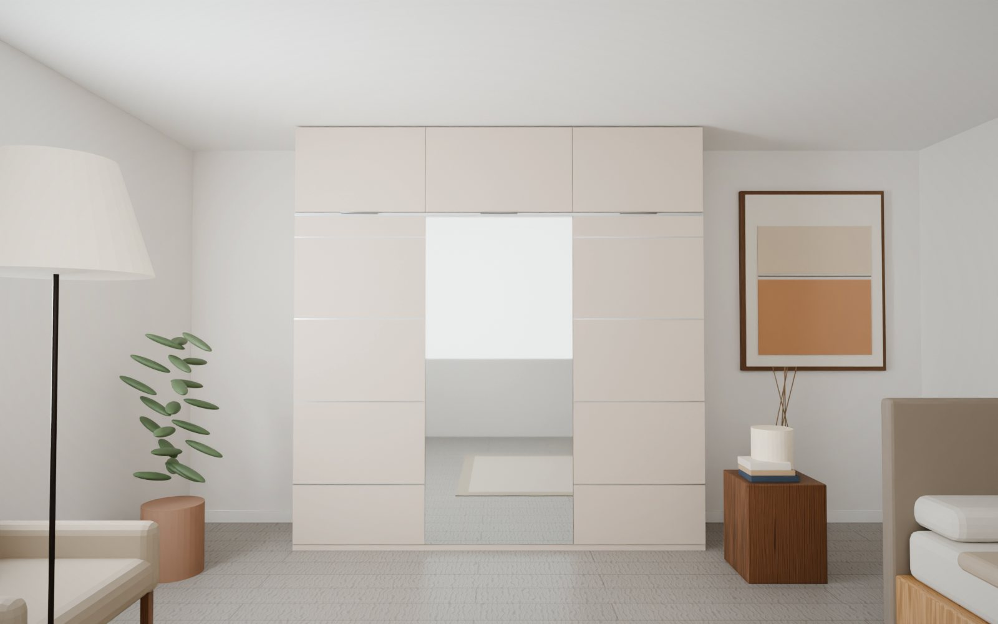
assets/img/r2/story_morning.jpg
