mbolgar11/zenit/assets/img/r2/story_night.jpg

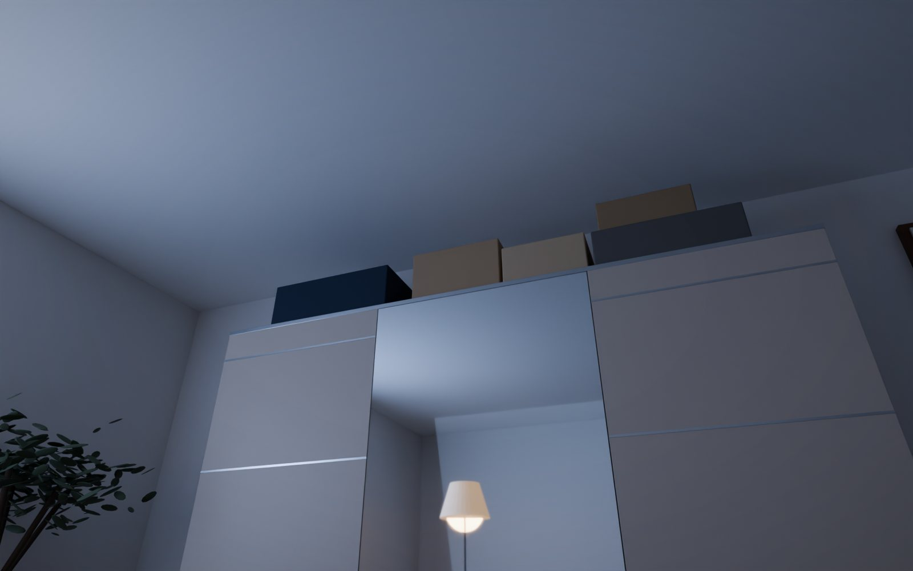
assets/img/r2/story_night.jpg
