mbolgar11/zenit/assets/img/r2/v_grafit_dio.jpg

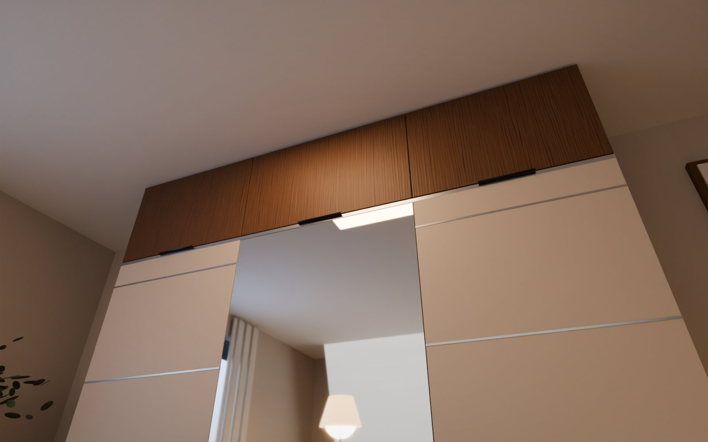
assets/img/r2/v_grafit_dio.jpg
