mbolgar11/zenit/assets/img/r2/v_tolgy_day.jpg

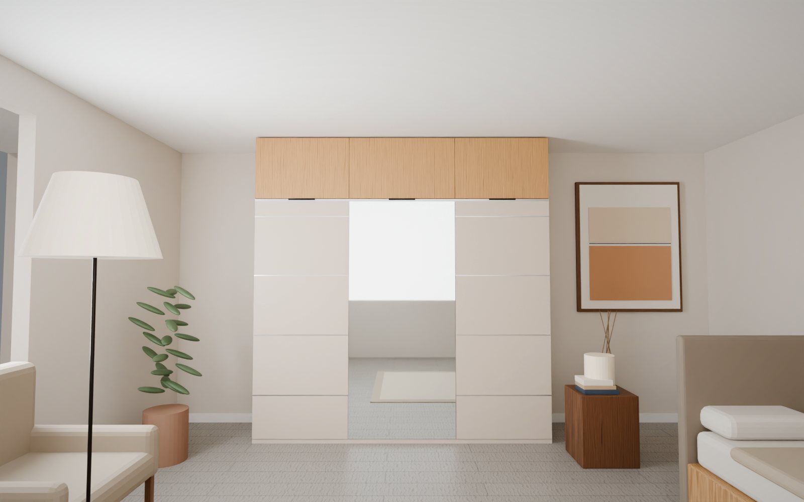
assets/img/r2/v_tolgy_day.jpg
