mbolgar11/zenit/assets/img/r/macro_handle_oak.jpg

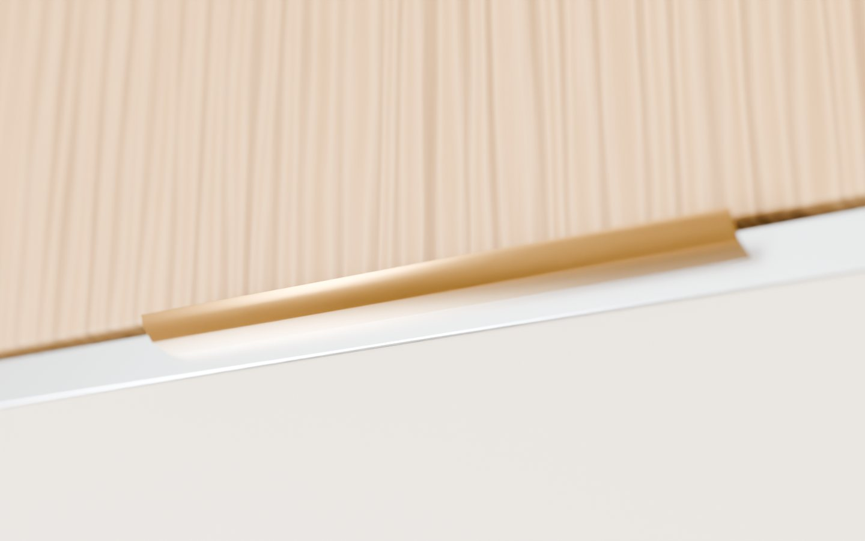
assets/img/r/macro_handle_oak.jpg
