mbolgar11/zenit/assets/img/r/tex_concrete.jpg

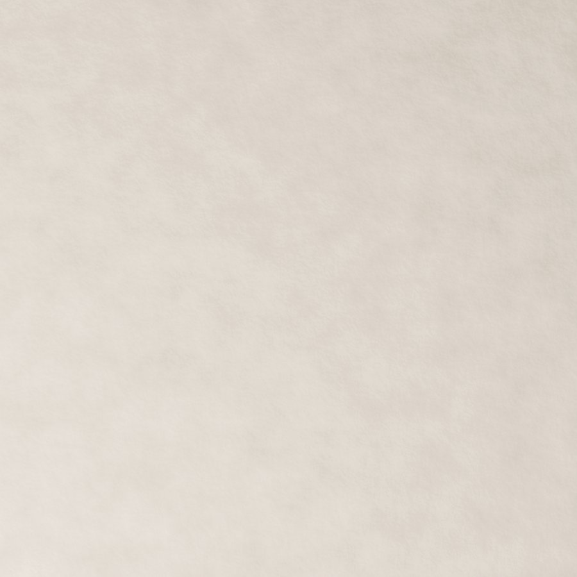
assets/img/r/tex_concrete.jpg
