mbolgar11/zenit/assets/m/foto/foto_002.jpg

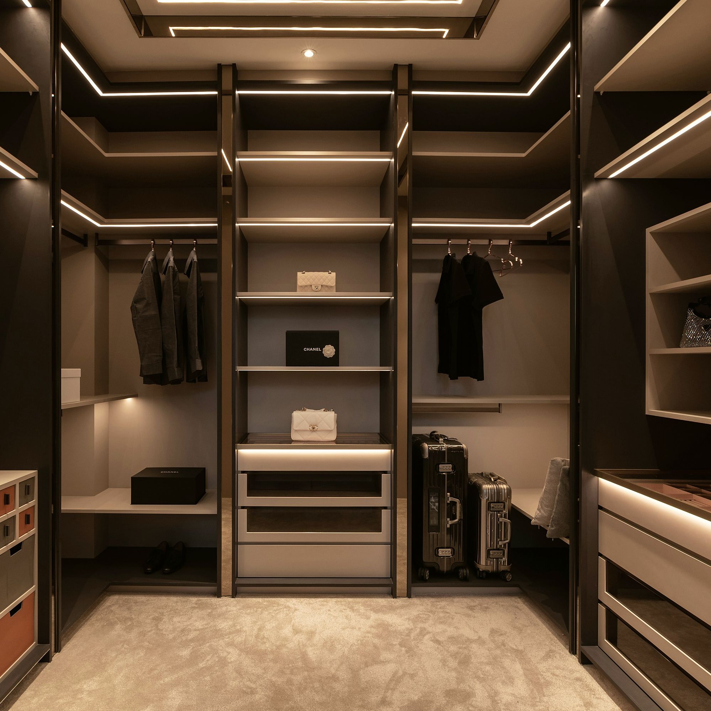
assets/m/foto/foto_002.jpg
