mbolgar11/zenit/assets/m/foto/foto_003.jpg

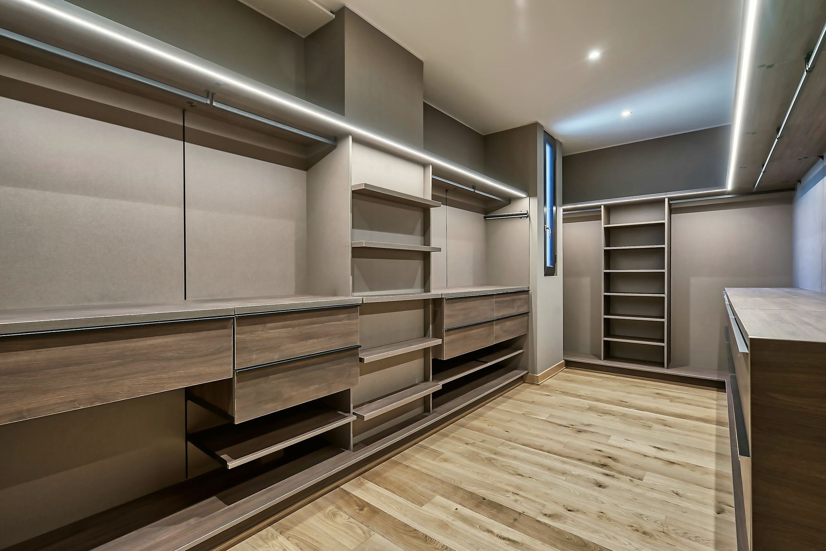
assets/m/foto/foto_003.jpg
