mbolgar11/zenit/assets/m/foto/foto_003_hero.jpg

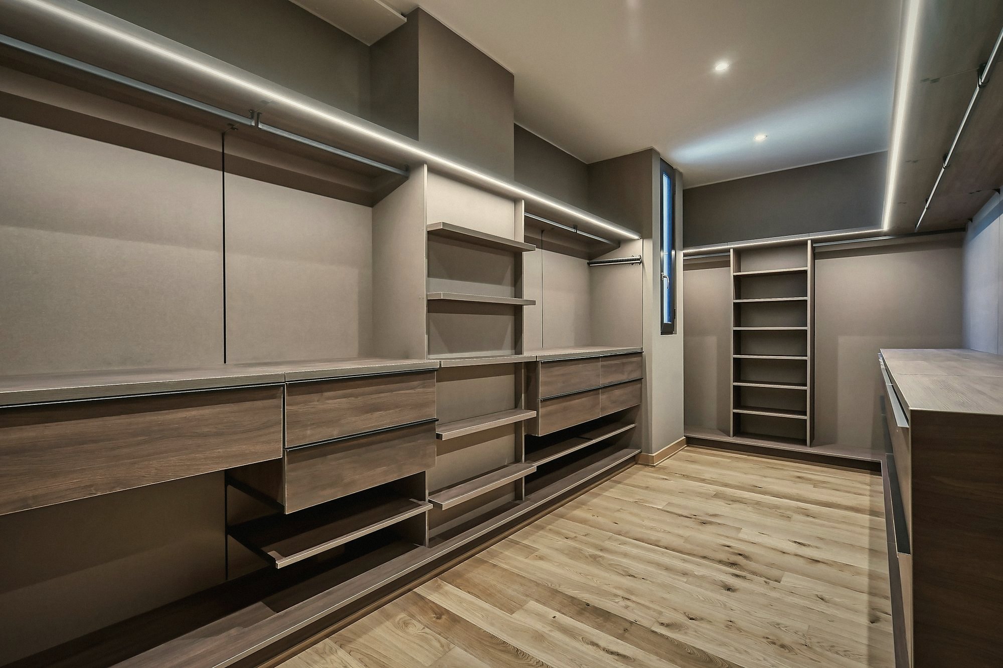
assets/m/foto/foto_003_hero.jpg
