mbolgar11/zenit/assets/m/foto/foto_009.jpg

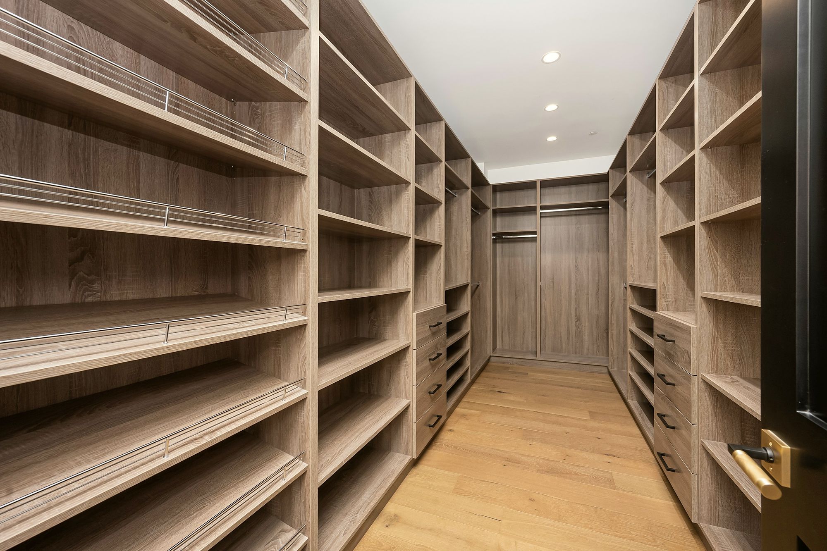
assets/m/foto/foto_009.jpg
