mbolgar11/zenit/assets/m/foto/foto_011.jpg

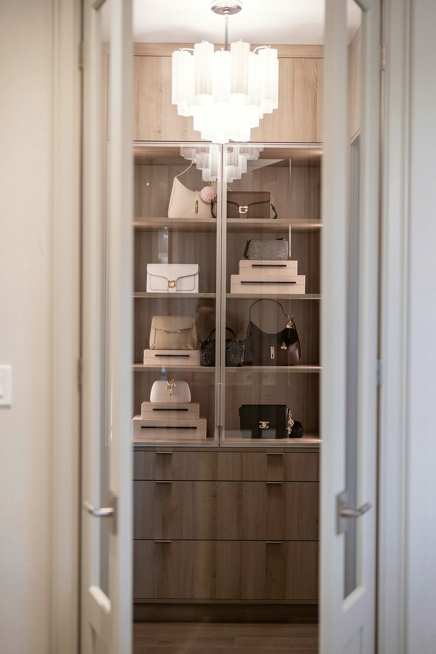
assets/m/foto/foto_011.jpg
