mbolgar11/zenit/assets/m/foto/foto_015.jpg

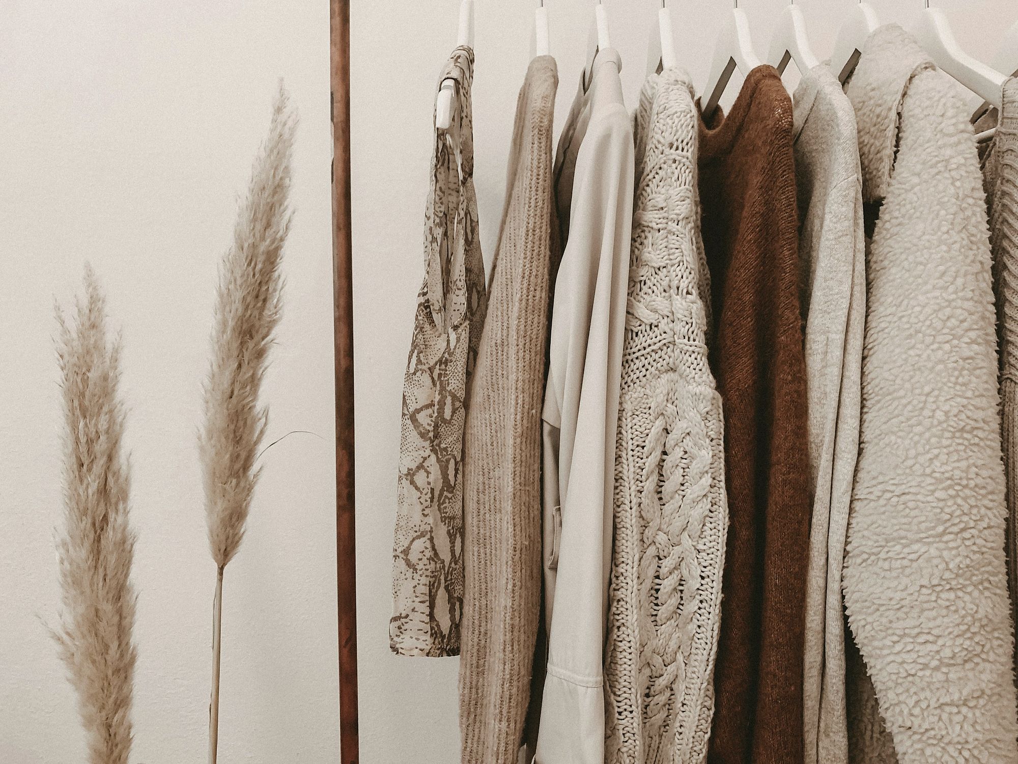
assets/m/foto/foto_015.jpg
