mbolgar11/zenit/assets/m/foto/foto_020.jpg

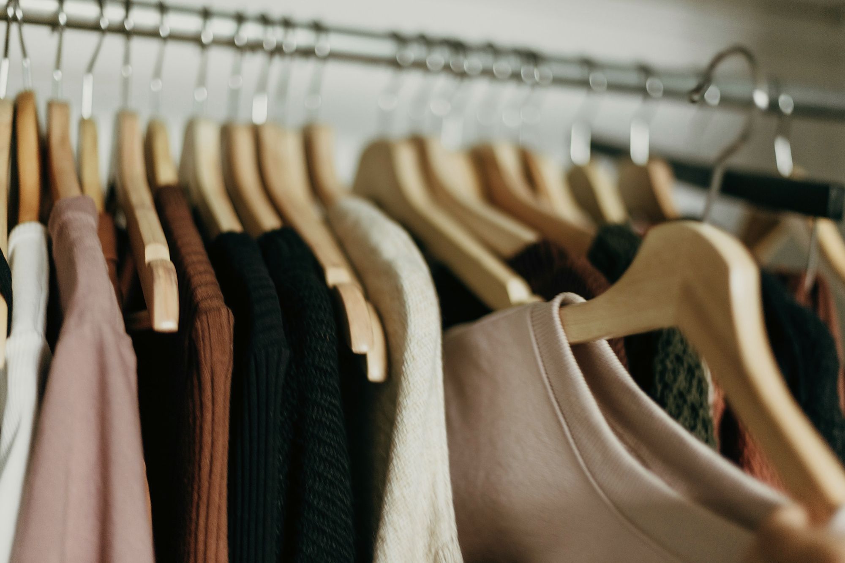
assets/m/foto/foto_020.jpg
