mbolgar11/zenit/assets/m/foto/foto_024.jpg

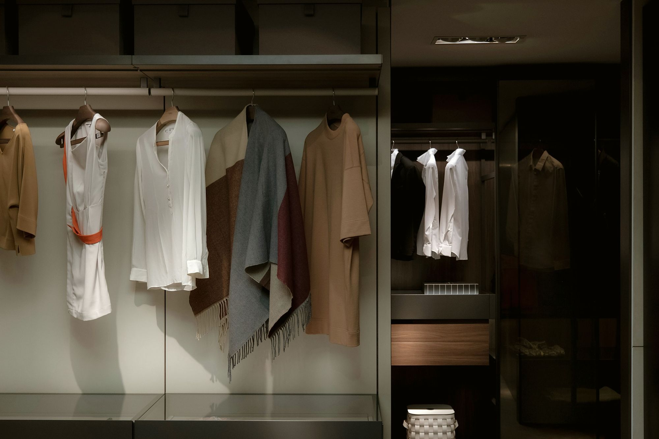
assets/m/foto/foto_024.jpg
