mbolgar11/zenit/assets/m/foto/foto_032.jpg

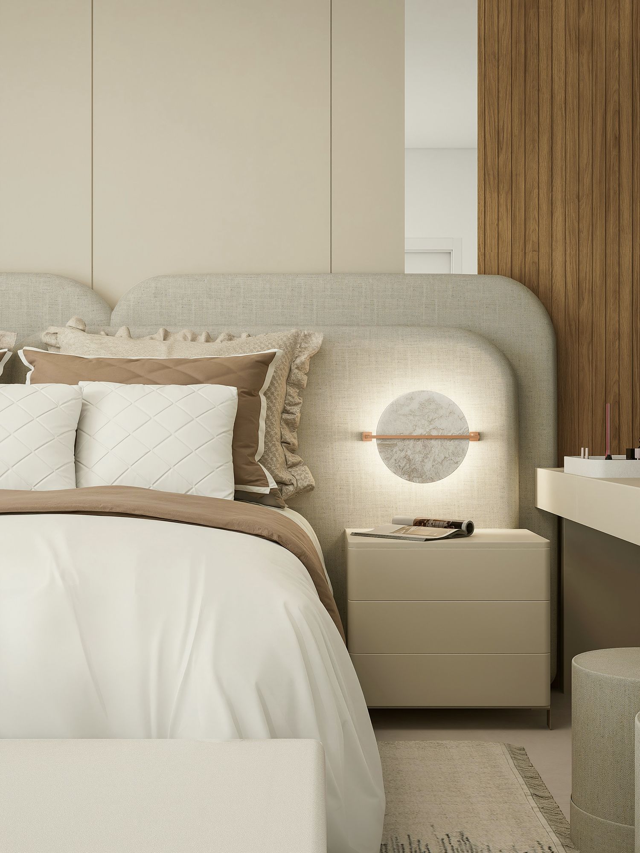
assets/m/foto/foto_032.jpg
