mbolgar11/zenit/assets/m/foto/foto_037.jpg

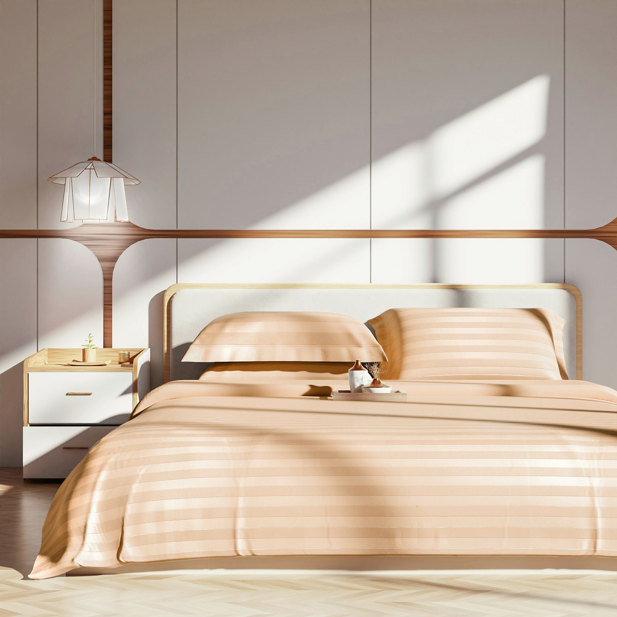
assets/m/foto/foto_037.jpg
