mbolgar11/zenit/assets/m/foto/foto_041.jpg

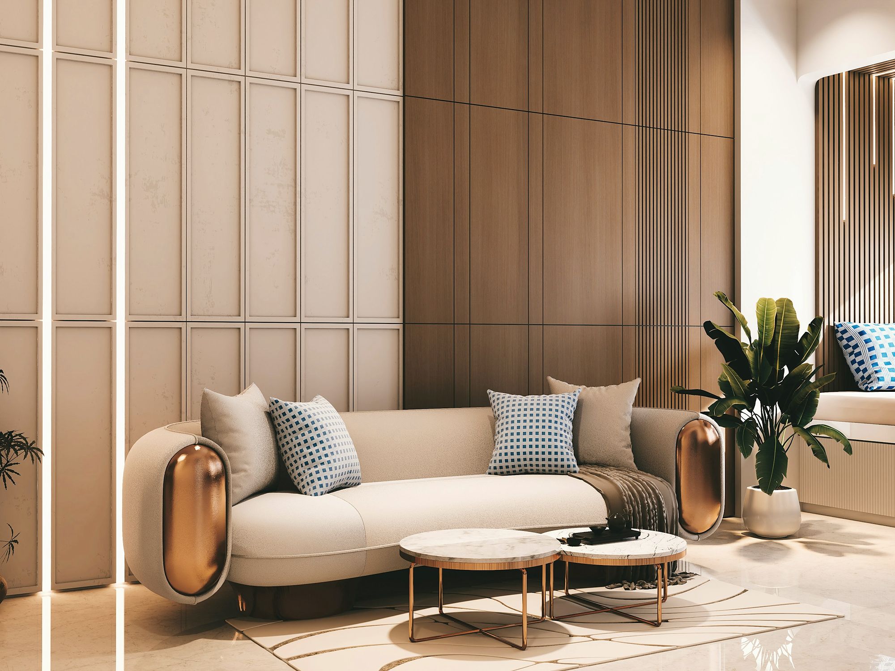
assets/m/foto/foto_041.jpg
