mbolgar11/zenit/assets/m/foto/foto_044.jpg

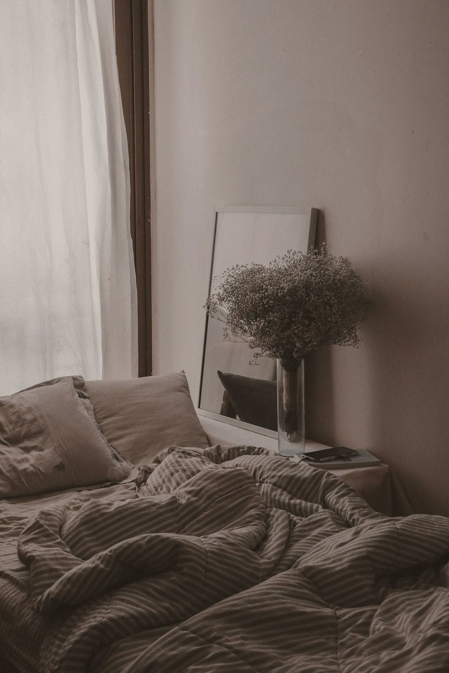
assets/m/foto/foto_044.jpg
