mbolgar11/zenit/assets/m/foto/foto_046.jpg

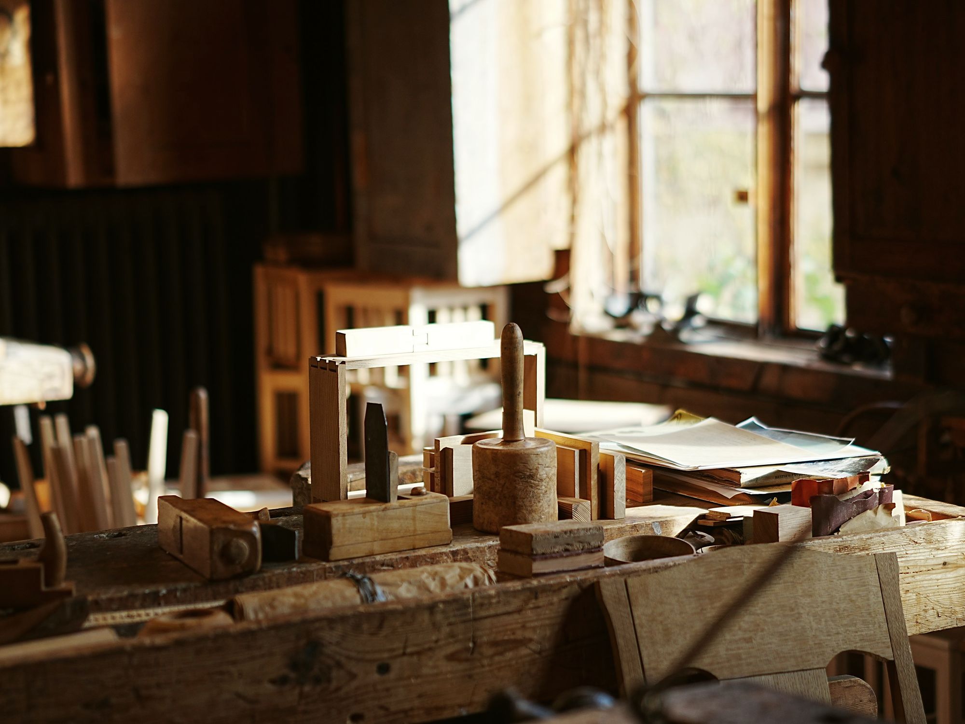
assets/m/foto/foto_046.jpg
