mbolgar11/zenit/assets/m/foto/foto_049.jpg

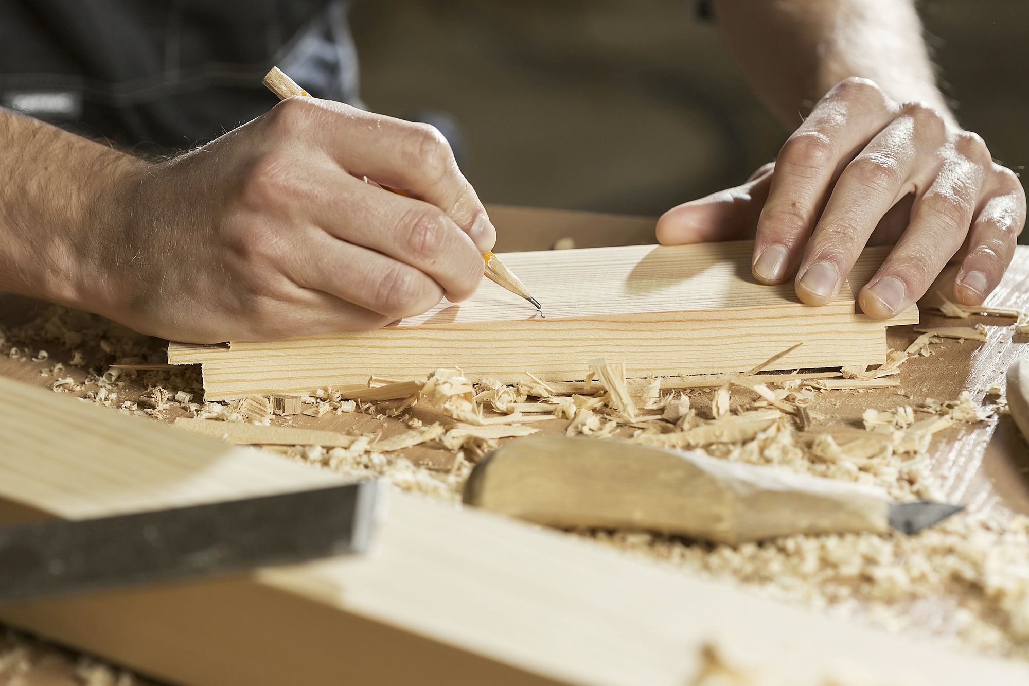
assets/m/foto/foto_049.jpg
