mbolgar11/zenit/assets/m/foto/foto_051.jpg

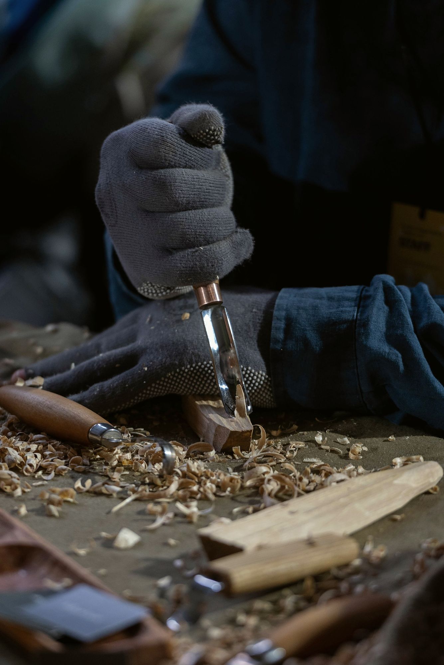
assets/m/foto/foto_051.jpg
