mbolgar11/zenit/assets/m/foto/foto_054.jpg

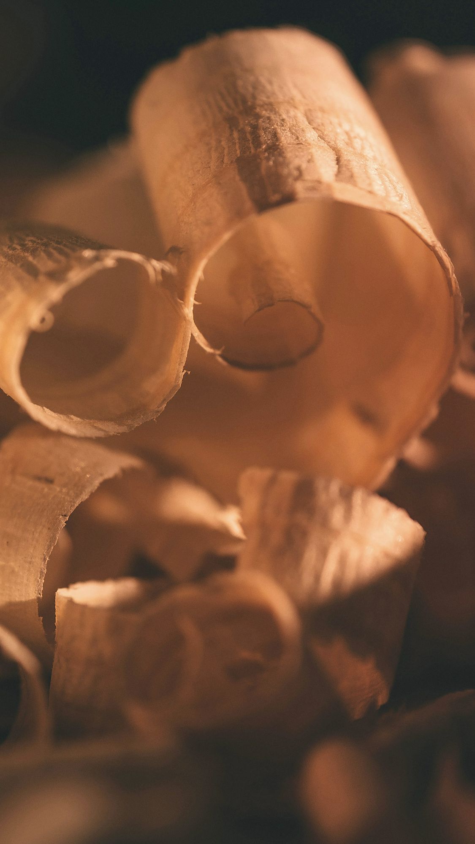
assets/m/foto/foto_054.jpg
