mbolgar11/zenit/assets/m/foto/foto_056.jpg

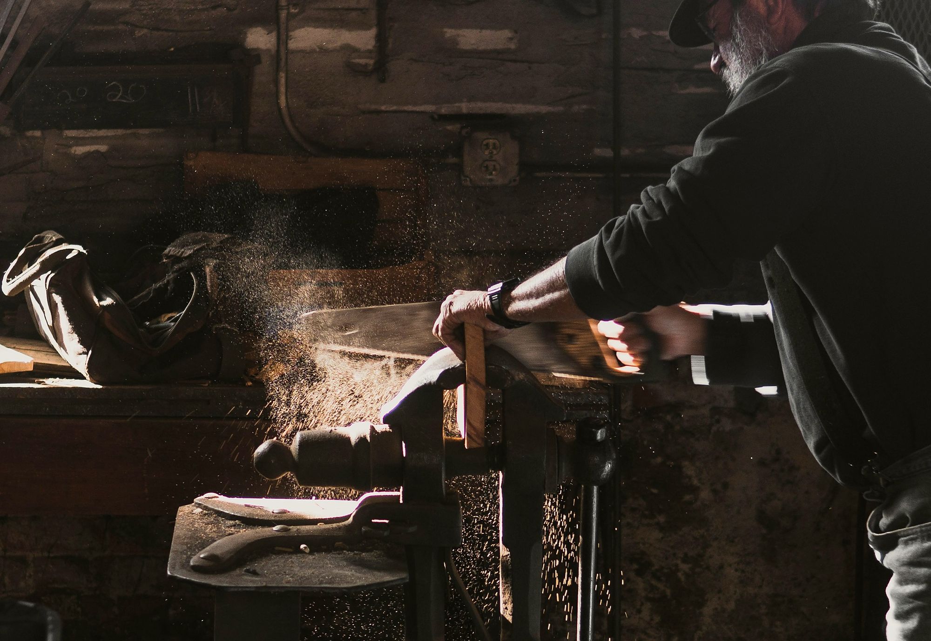
assets/m/foto/foto_056.jpg
