mbolgar11/zenit/assets/m/foto/foto_063.jpg

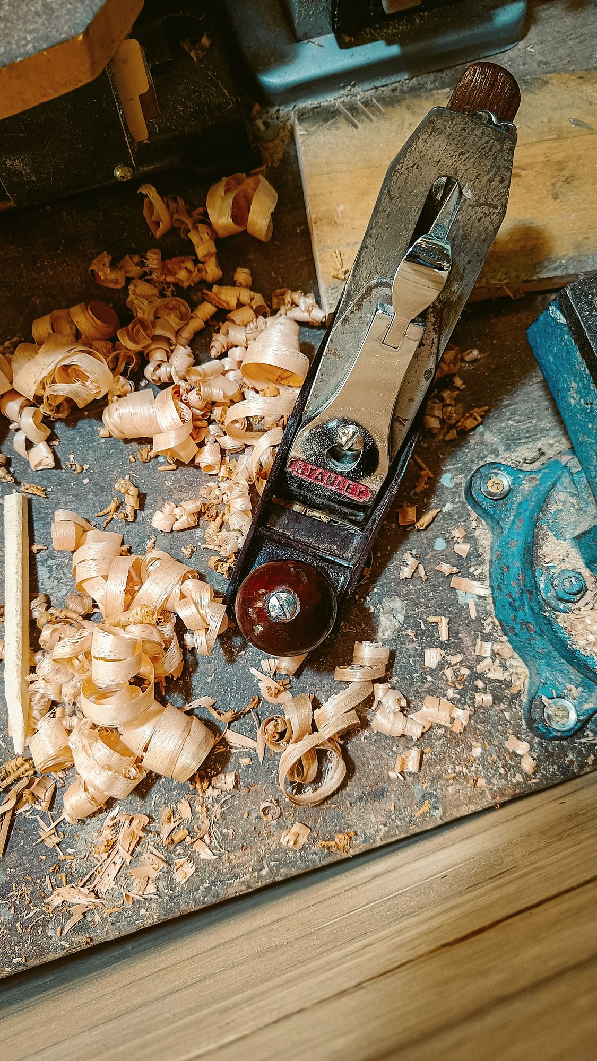
assets/m/foto/foto_063.jpg
