mbolgar11/zenit/assets/m/foto/foto_070.jpg

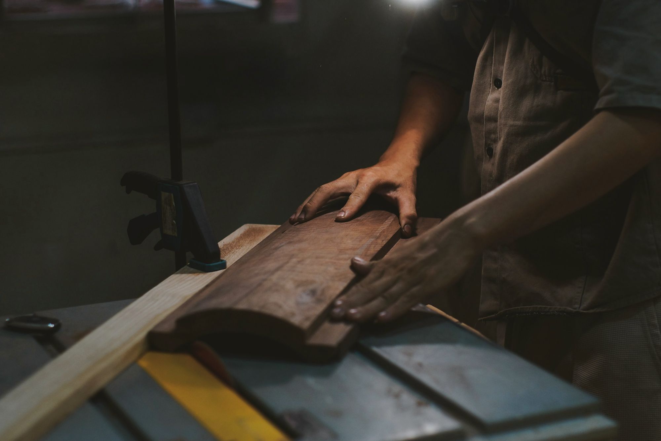
assets/m/foto/foto_070.jpg
