mbolgar11/zenit/assets/m/foto/foto_077.jpg

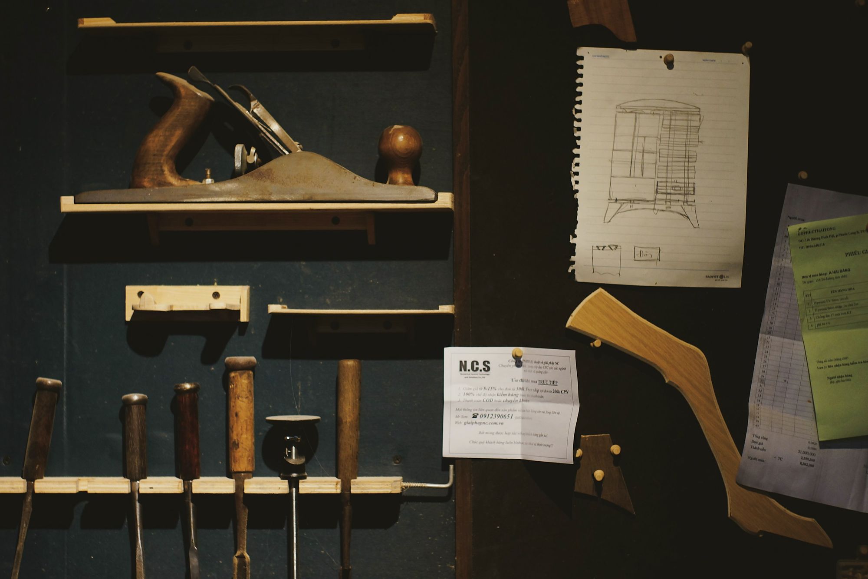
assets/m/foto/foto_077.jpg
