mbolgar11/zenit/assets/m/foto/foto_078.jpg

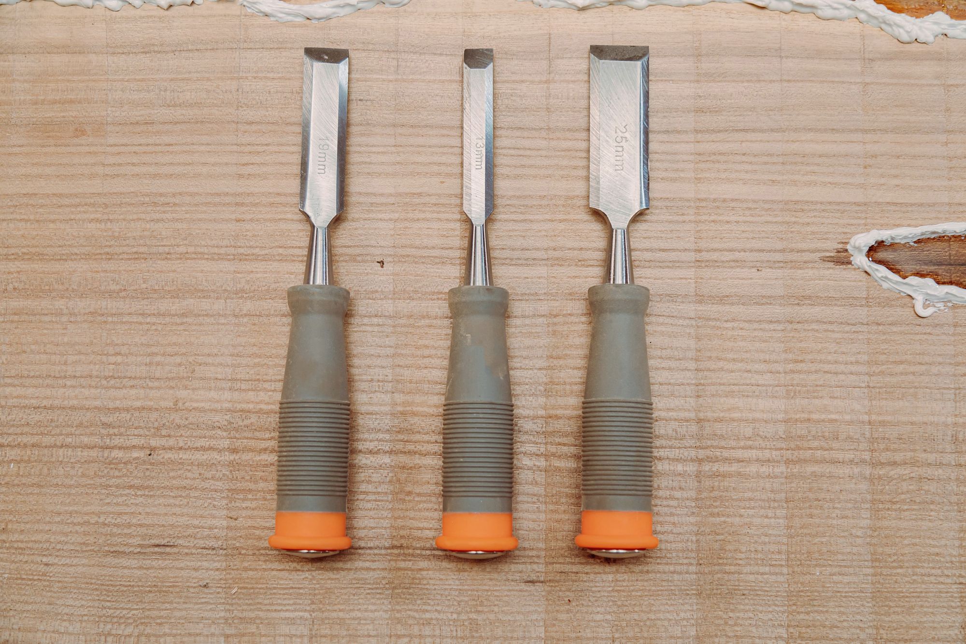
assets/m/foto/foto_078.jpg
