mbolgar11/zenit/assets/m/foto/foto_080.jpg

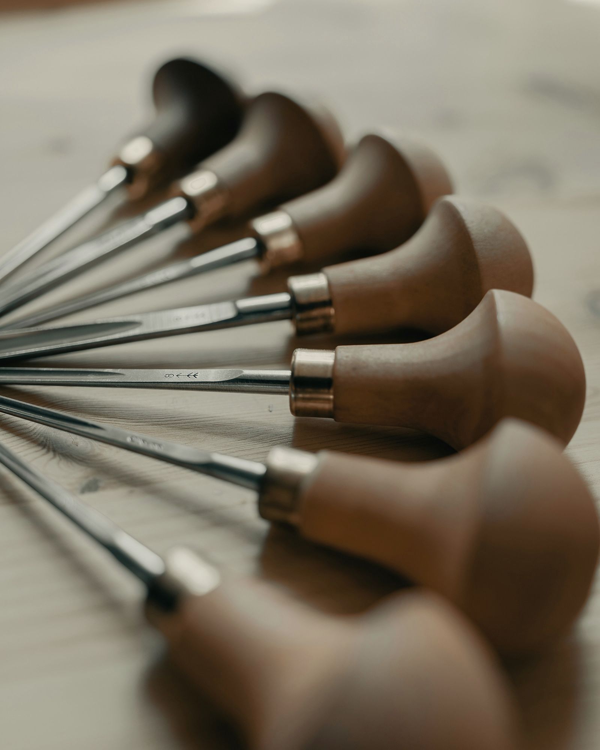
assets/m/foto/foto_080.jpg
