mbolgar11/zenit/assets/m/foto/foto_086.jpg

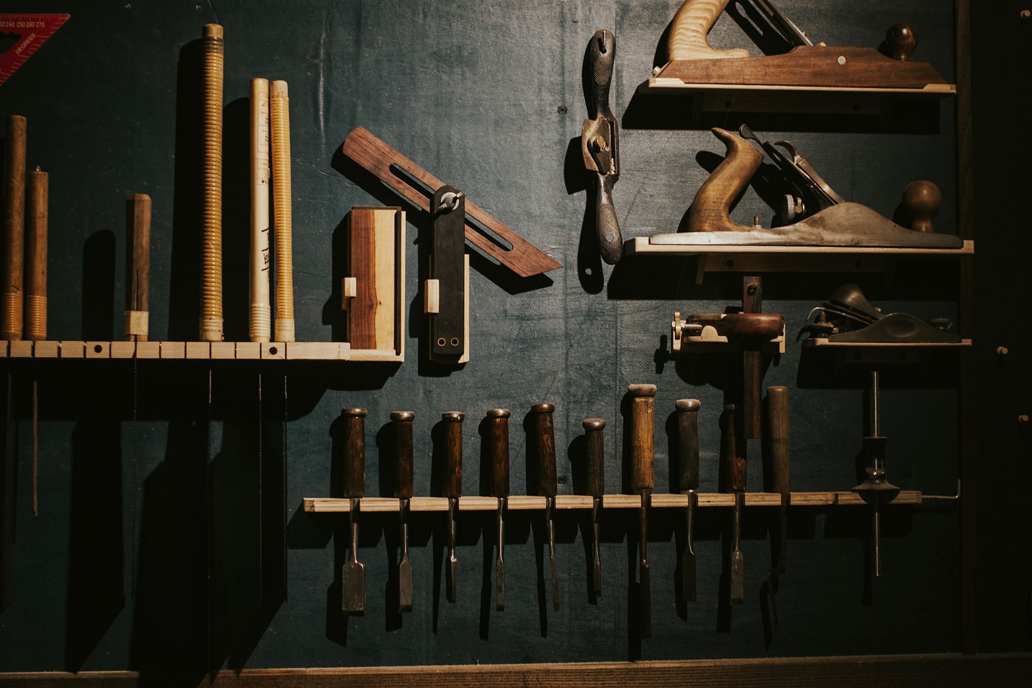
assets/m/foto/foto_086.jpg
