mbolgar11/zenit/assets/m/foto/foto_093.jpg

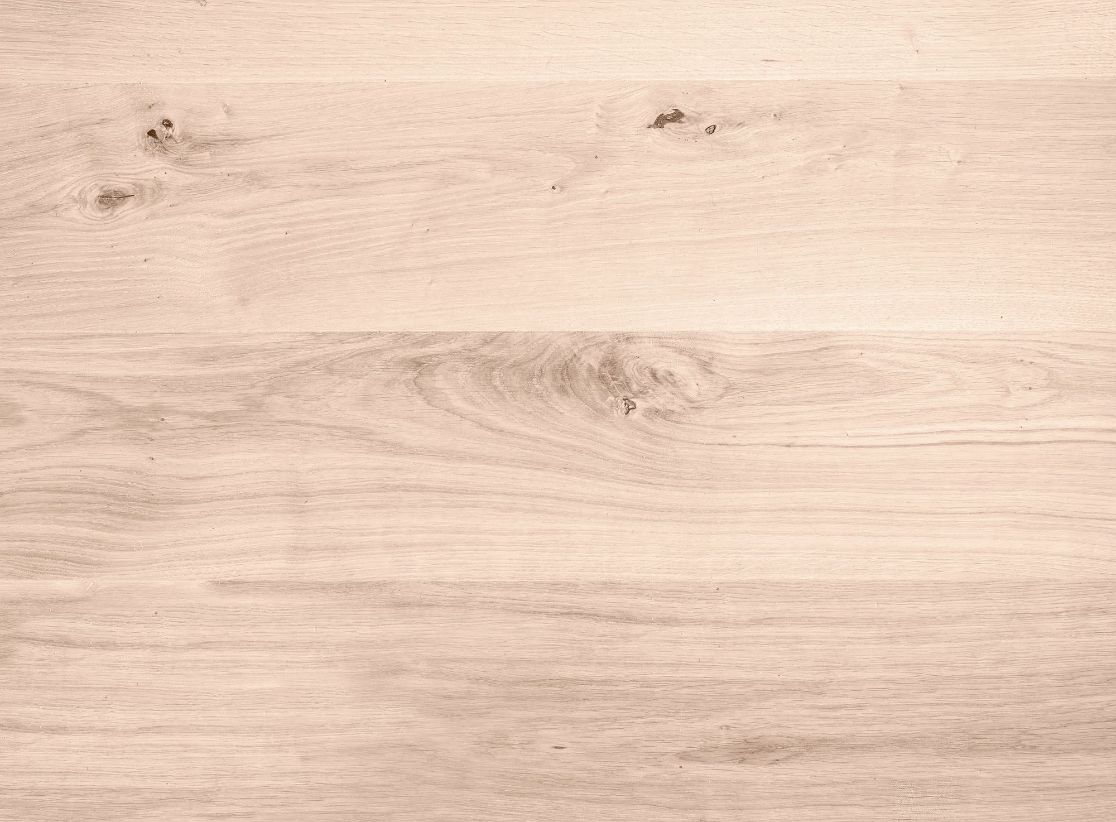
assets/m/foto/foto_093.jpg
