mbolgar11/zenit/assets/m/foto/foto_109.jpg

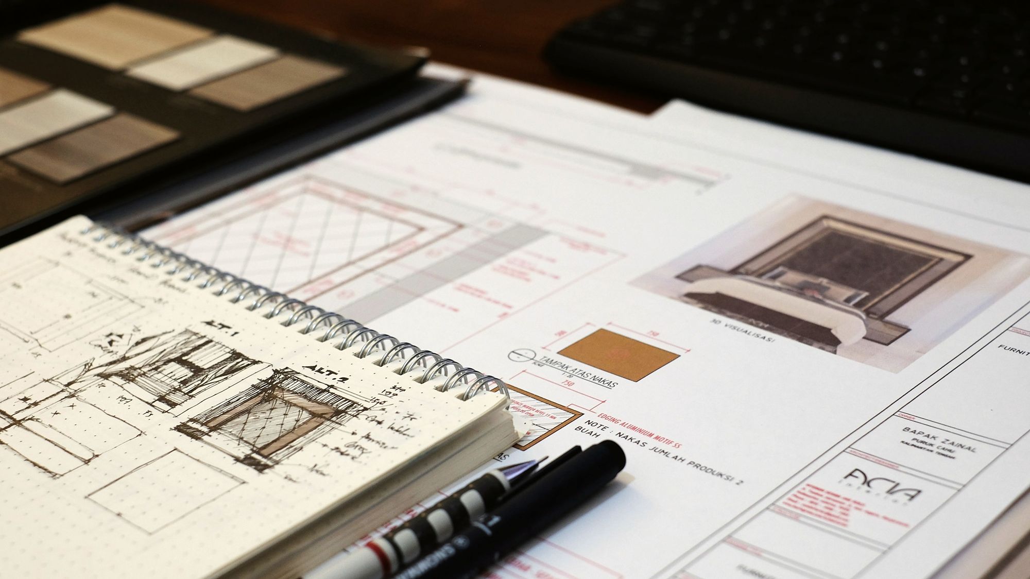
assets/m/foto/foto_109.jpg
