mbolgar11/zenit/assets/m/foto/foto_112.jpg

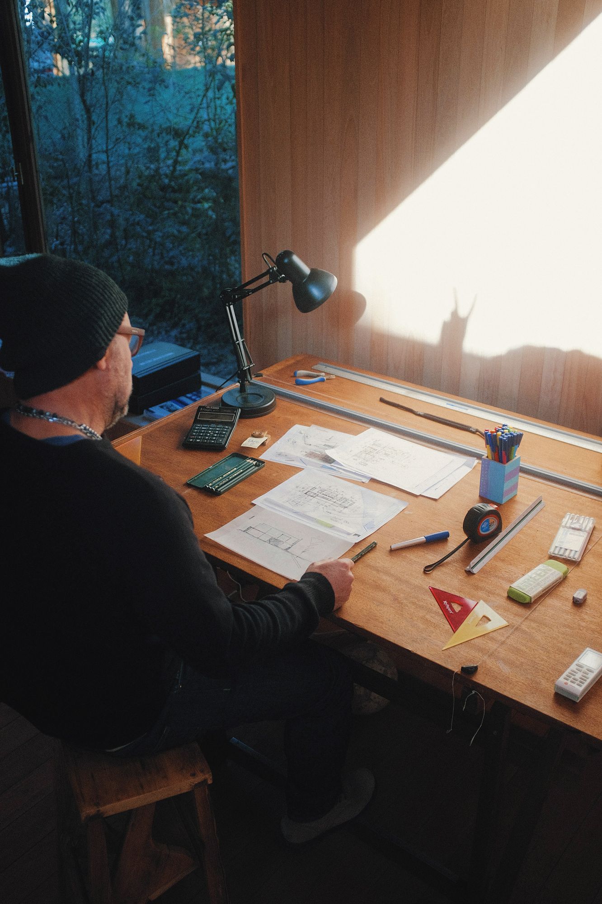
assets/m/foto/foto_112.jpg
