mbolgar11/zenit/assets/m/foto/foto_117.jpg

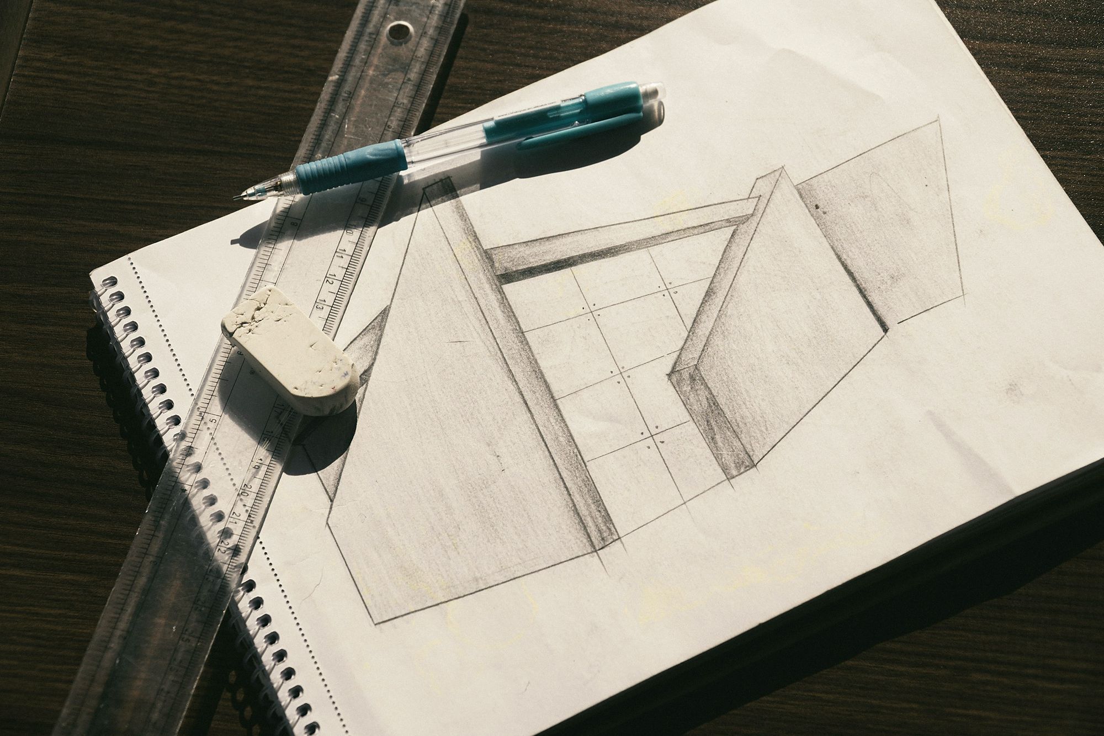
assets/m/foto/foto_117.jpg
