mbolgar11/zenit/assets/m/foto/foto_121.jpg

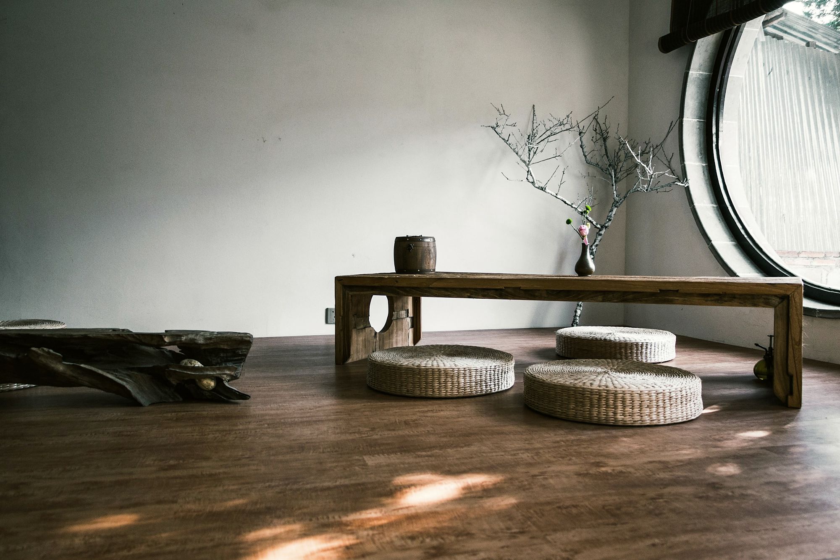
assets/m/foto/foto_121.jpg
