mbolgar11/zenit/assets/m/foto/foto_128.jpg

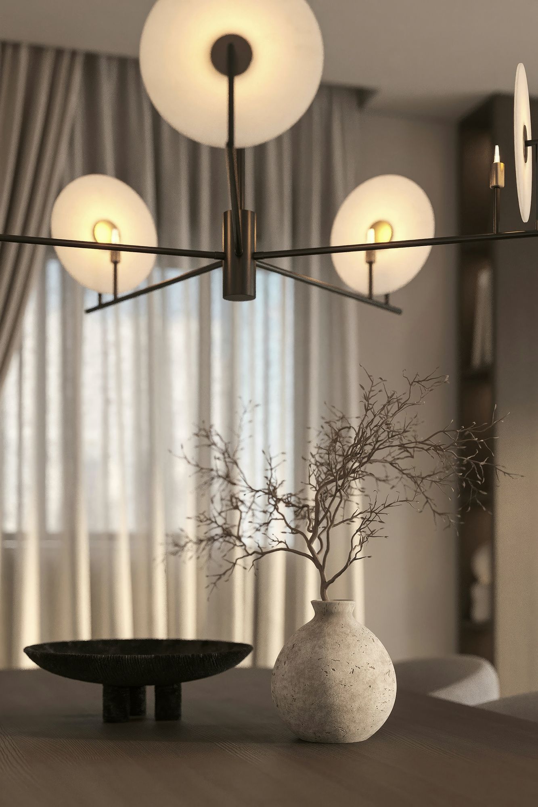
assets/m/foto/foto_128.jpg
