mbolgar11/zenit/assets/m/foto/foto_131.jpg

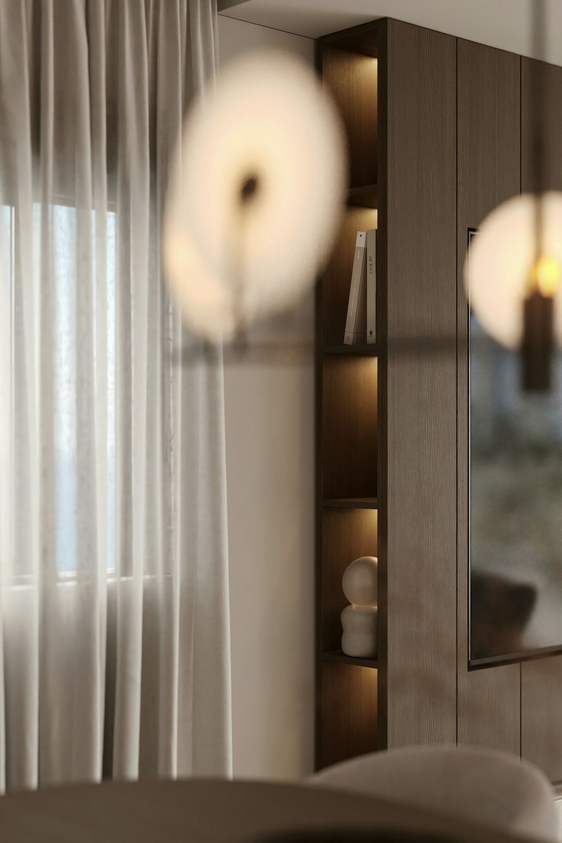
assets/m/foto/foto_131.jpg
