mbolgar11/zenit/assets/m/foto/foto_135.jpg

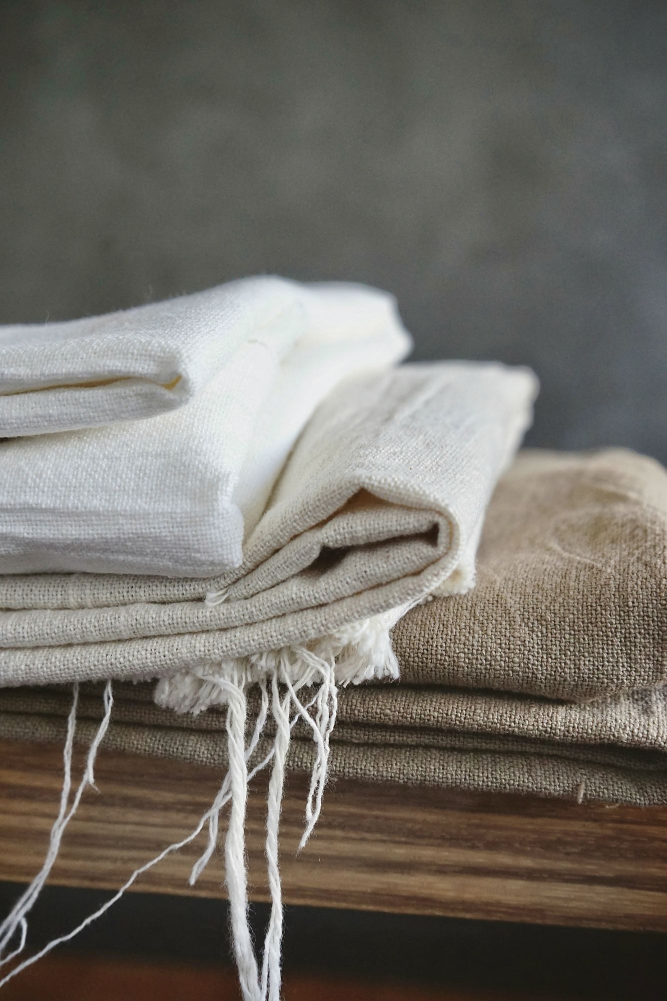
assets/m/foto/foto_135.jpg
