mbolgar11/zenit/assets/m/foto/foto_146.jpg

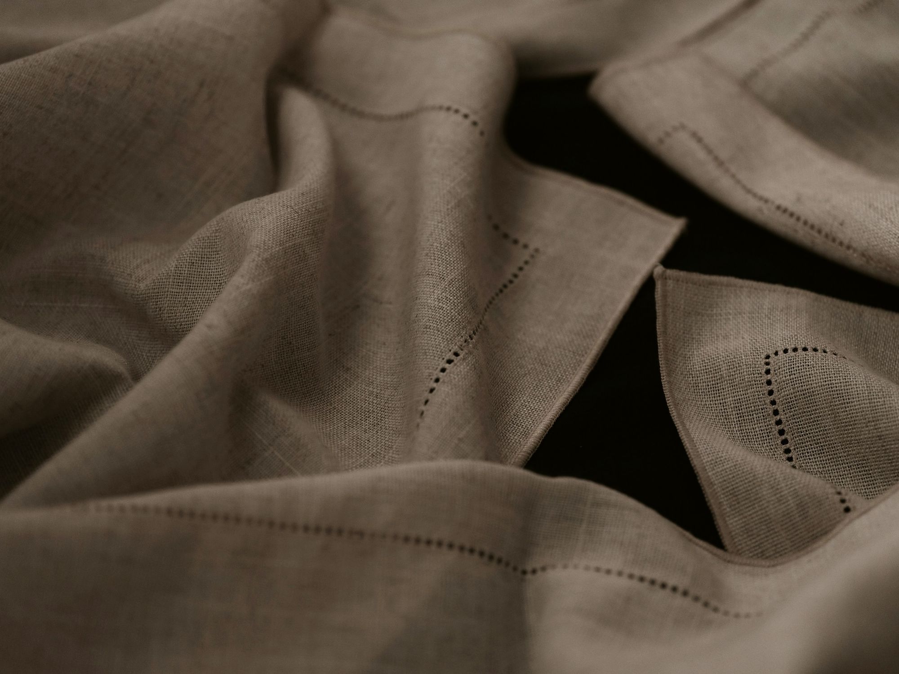
assets/m/foto/foto_146.jpg
