mbolgar11/zenit/assets/m/video/alaprajz.jpg

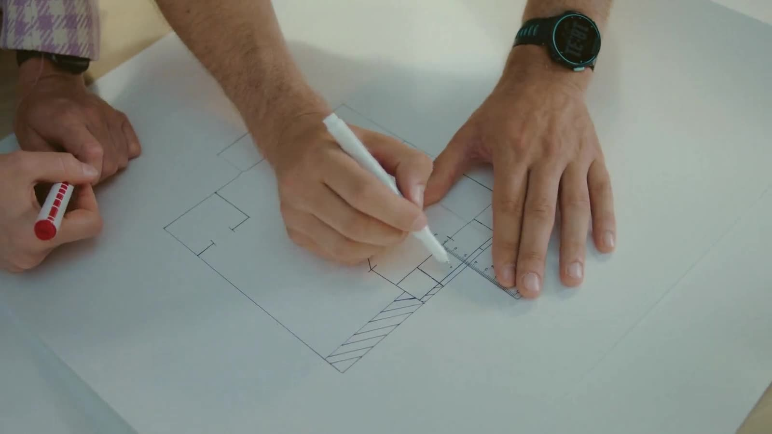
assets/m/video/alaprajz.jpg
