mbolgar11/zenit/assets/m/video/cnc.jpg

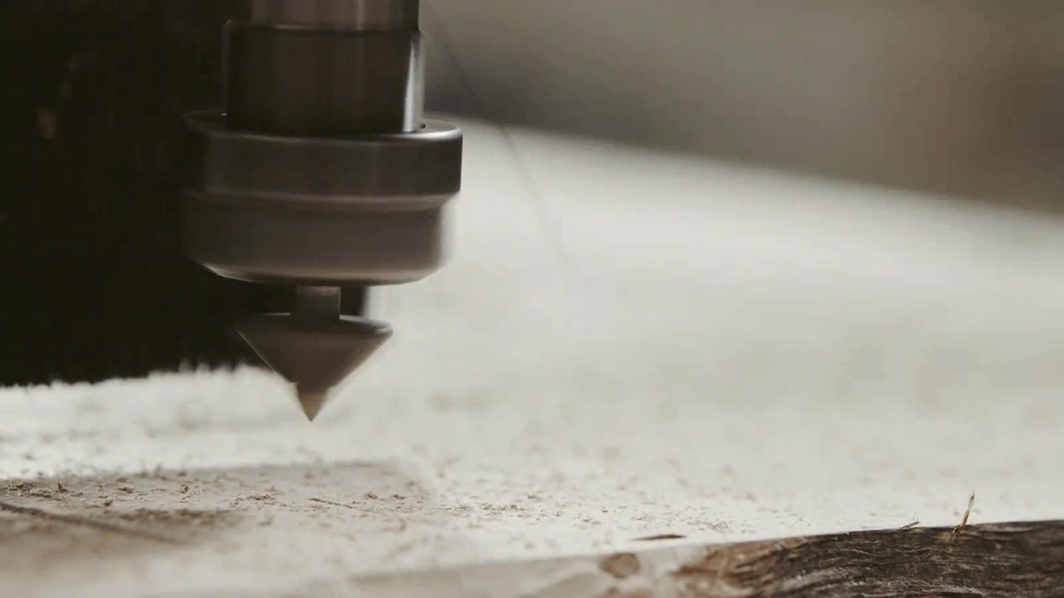
assets/m/video/cnc.jpg
