mbolgar11/zenit/assets/m/video/cnc_kozel.jpg

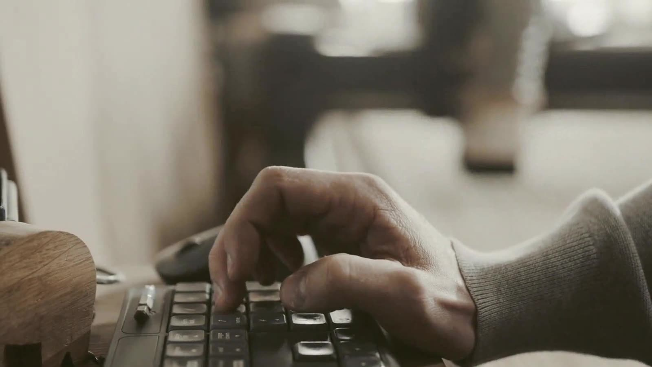
assets/m/video/cnc_kozel.jpg
