mbolgar11/zenit/assets/m/video/cnc_tag.jpg

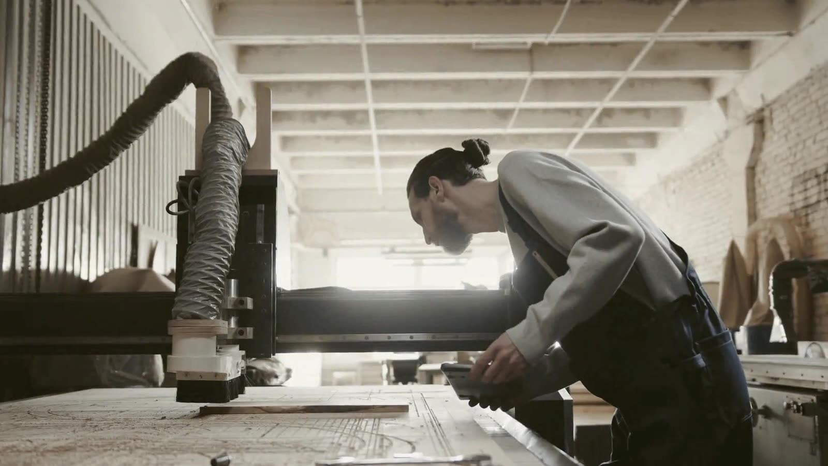
assets/m/video/cnc_tag.jpg
