mbolgar11/zenit/assets/m/video/csiszolo_v.jpg

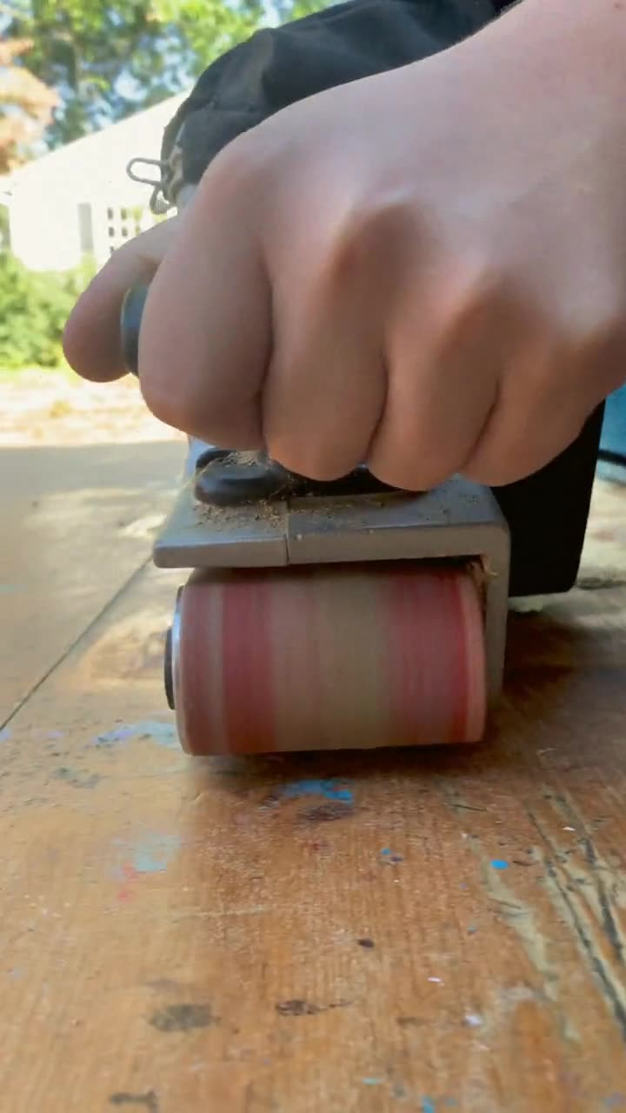
assets/m/video/csiszolo_v.jpg
