mbolgar11/zenit/assets/m/video/el.jpg

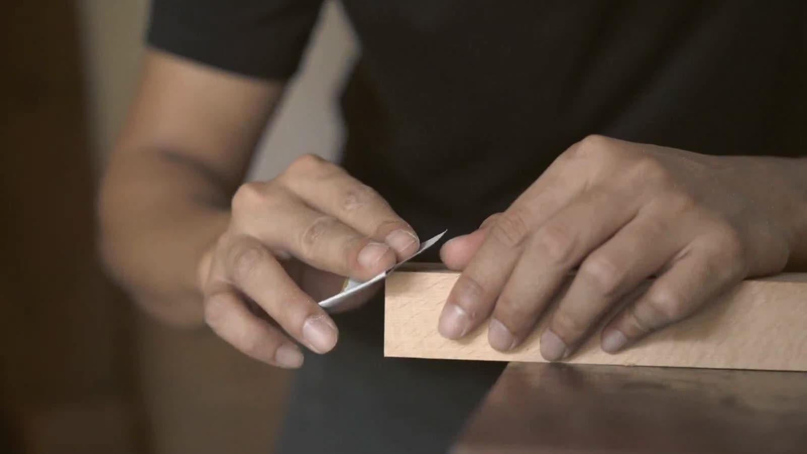
assets/m/video/el.jpg
