mbolgar11/zenit/assets/m/video/el_erintes.jpg

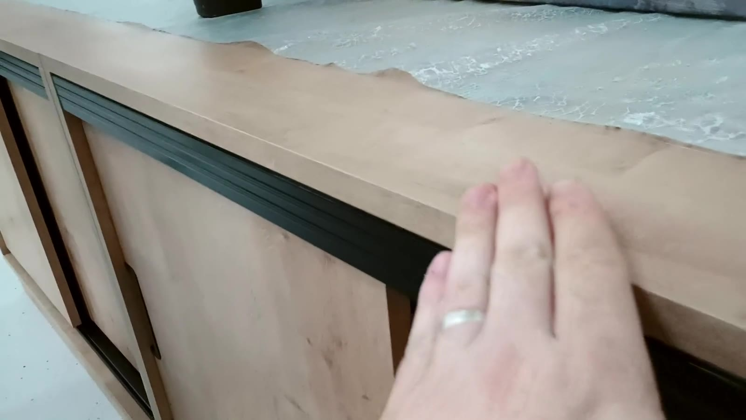
assets/m/video/el_erintes.jpg
