mbolgar11/zenit/assets/m/video/el_kez_v.jpg

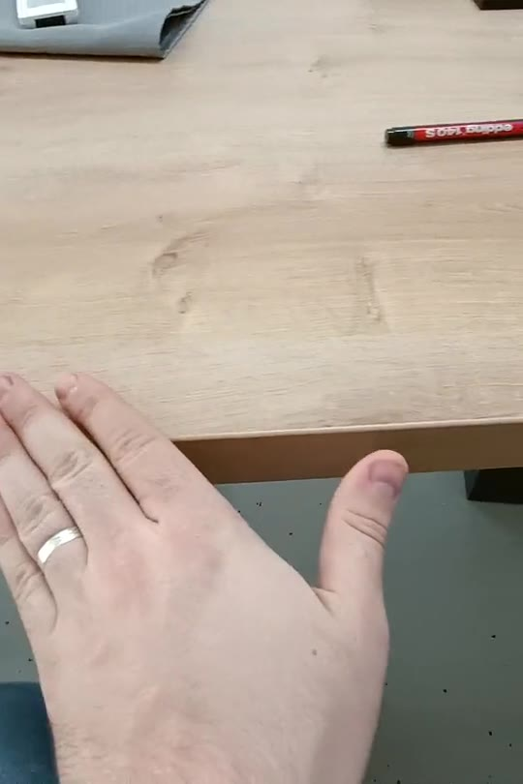
assets/m/video/el_kez_v.jpg
