mbolgar11/zenit/assets/m/video/fenyarnyek_v.jpg

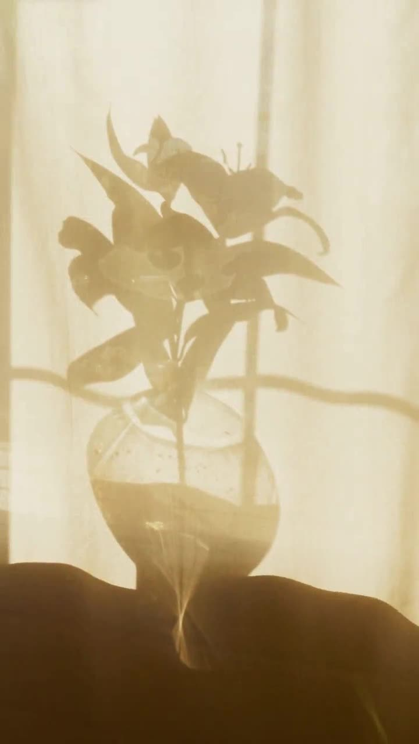
assets/m/video/fenyarnyek_v.jpg
