mbolgar11/zenit/assets/m/video/forgacs_v.jpg

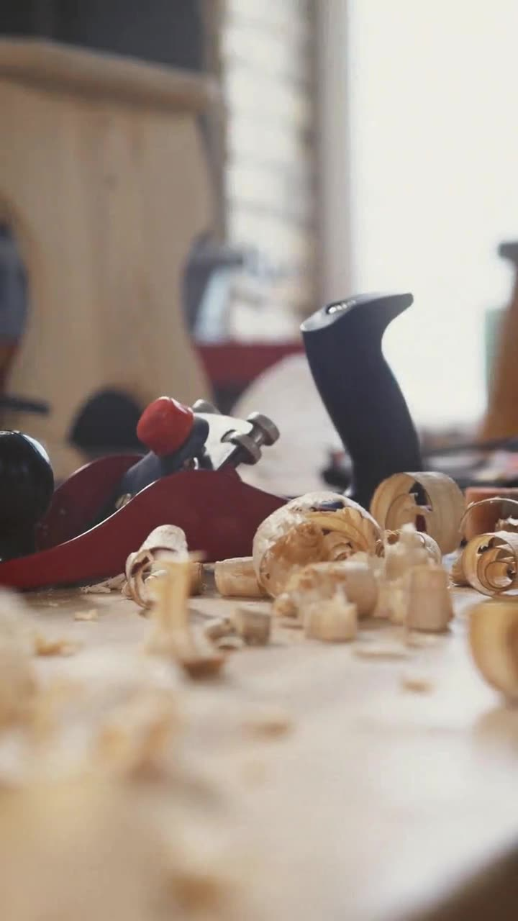
assets/m/video/forgacs_v.jpg
