mbolgar11/zenit/assets/m/video/fuggony_v.jpg

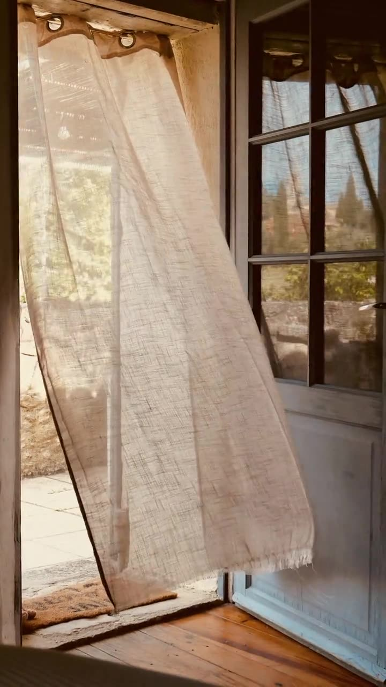
assets/m/video/fuggony_v.jpg
