mbolgar11/zenit/assets/m/video/furas.jpg

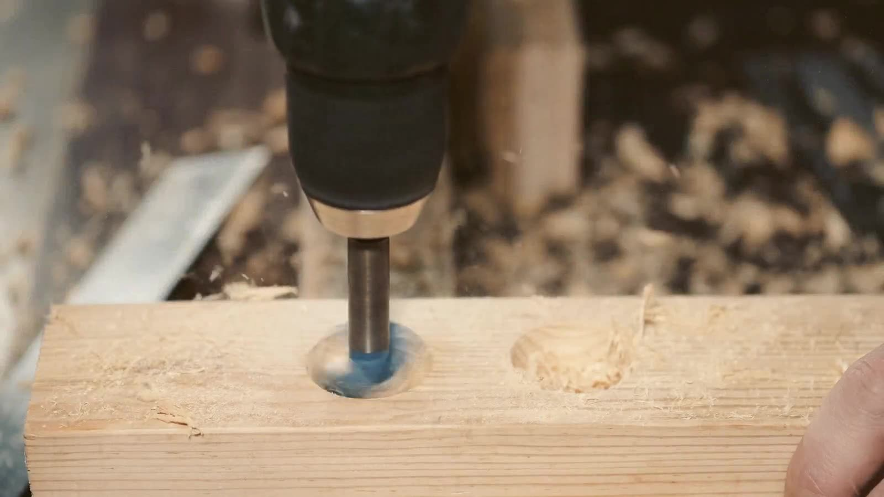
assets/m/video/furas.jpg
