mbolgar11/zenit/assets/m/video/gyalu.jpg

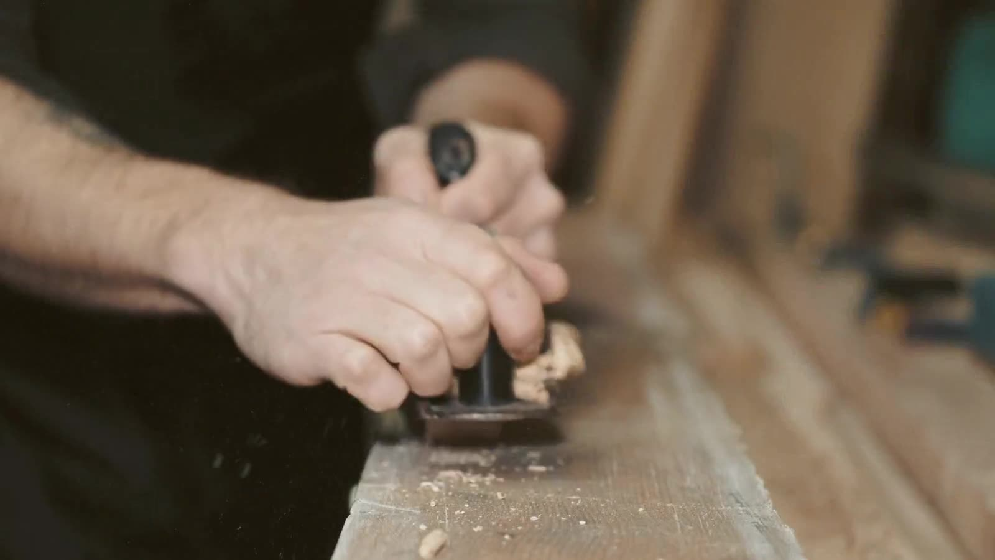
assets/m/video/gyalu.jpg
