mbolgar11/zenit/assets/m/video/gyalu_kez.jpg

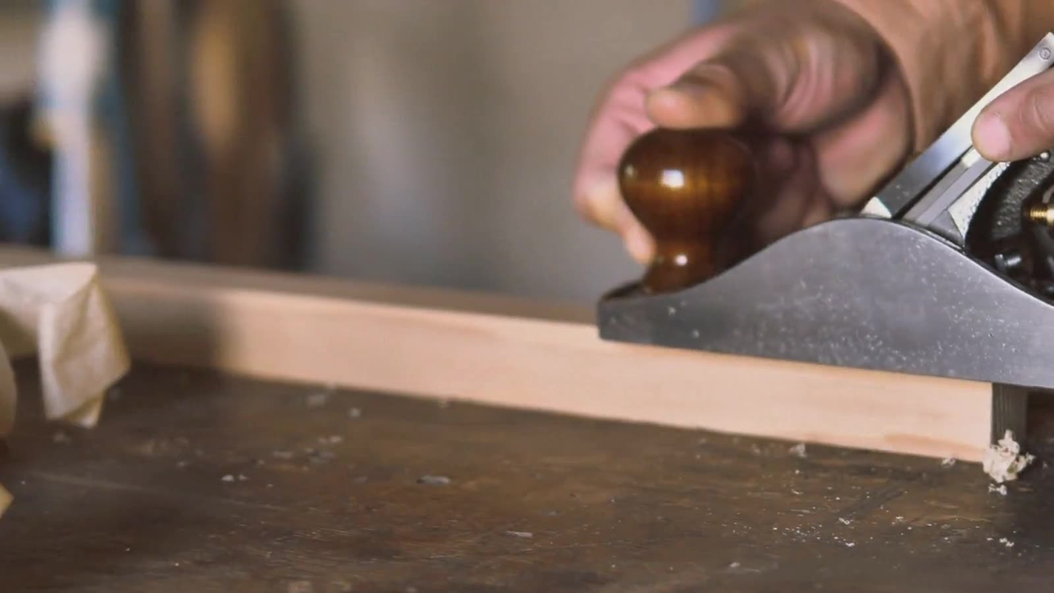
assets/m/video/gyalu_kez.jpg
