mbolgar11/zenit/assets/m/video/haloszoba_v.jpg

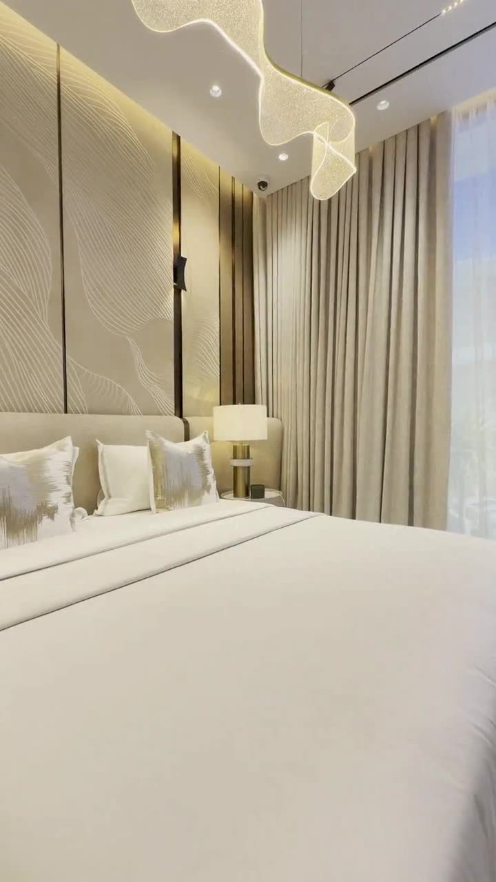
assets/m/video/haloszoba_v.jpg
