mbolgar11/zenit/assets/m/video/inspiracio_loop.jpg

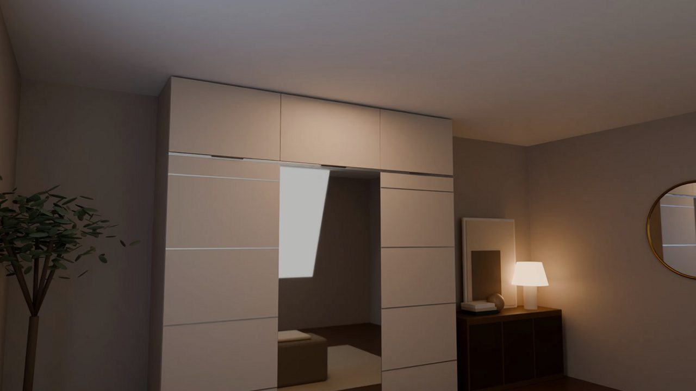
assets/m/video/inspiracio_loop.jpg
