mbolgar11/zenit/assets/m/video/nyitas.jpg

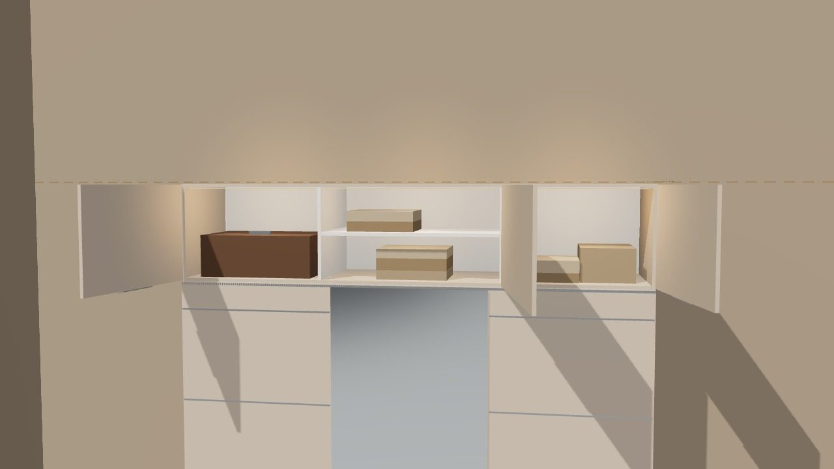
assets/m/video/nyitas.jpg
