mbolgar11/zenit/assets/m/video/pantcsesze.jpg

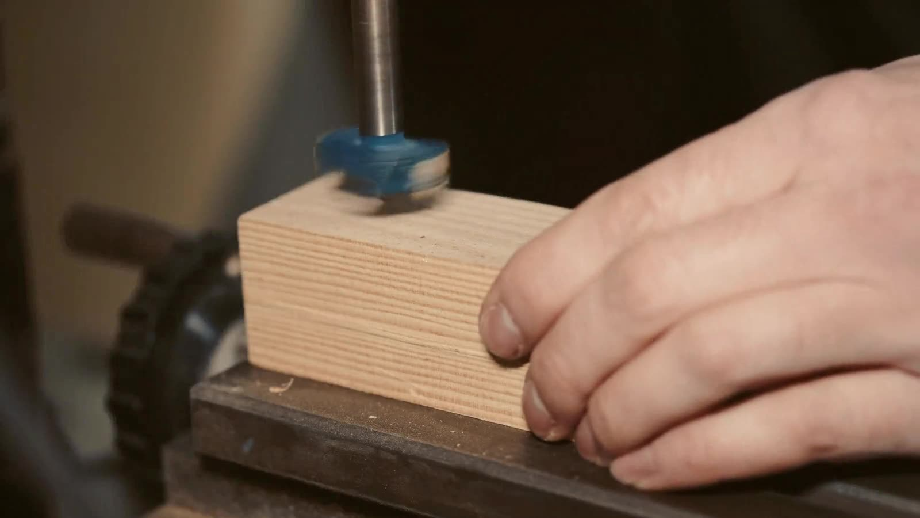
assets/m/video/pantcsesze.jpg
