mbolgar11/zenit/assets/m/video/projekt_loop.jpg

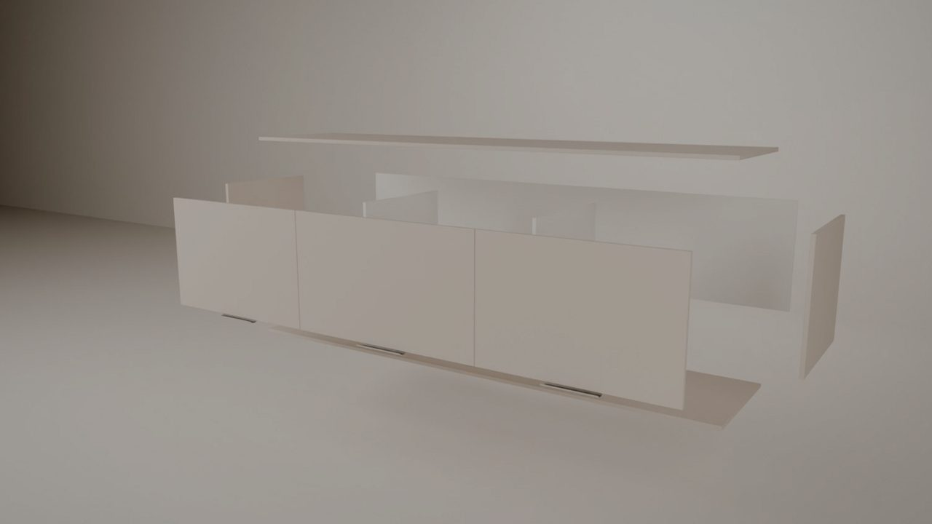
assets/m/video/projekt_loop.jpg
