mbolgar11/zenit/assets/m/video/ruhak.jpg

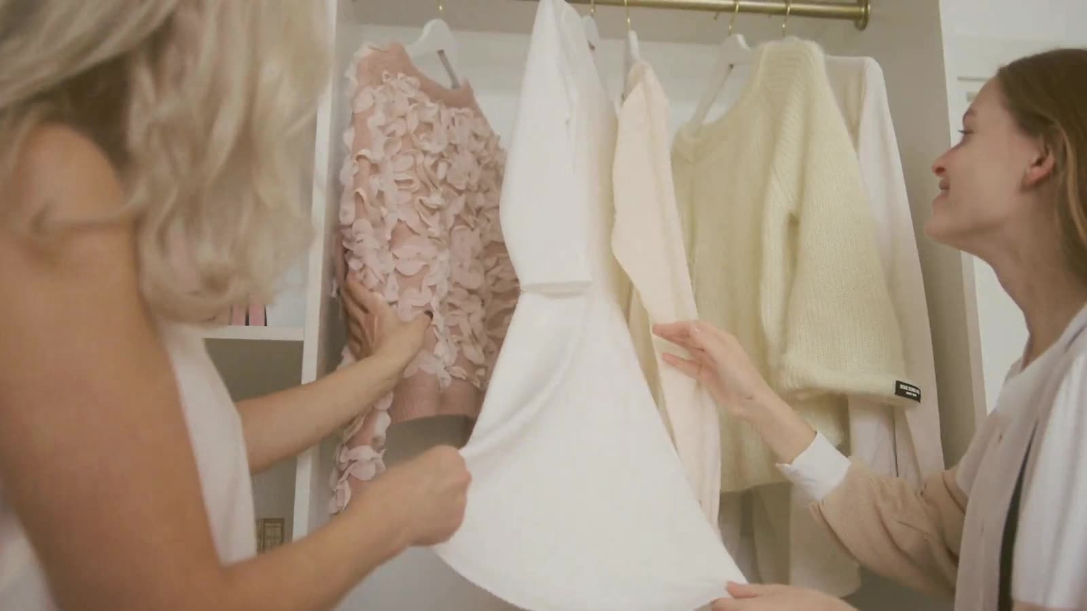
assets/m/video/ruhak.jpg
