mbolgar11/zenit/assets/m/video/szereles_loop.jpg

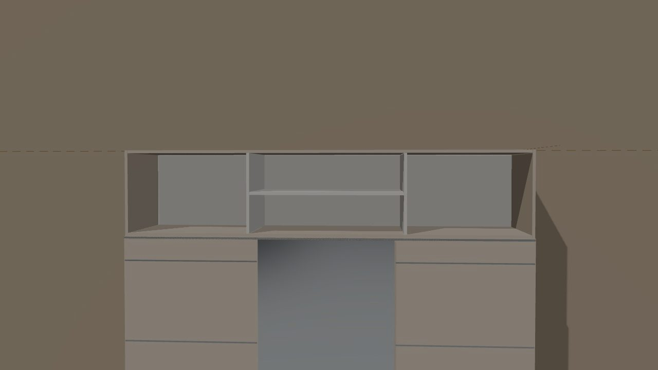
assets/m/video/szereles_loop.jpg
