mbolgar11/zenit/assets/m/video/tervezes.jpg

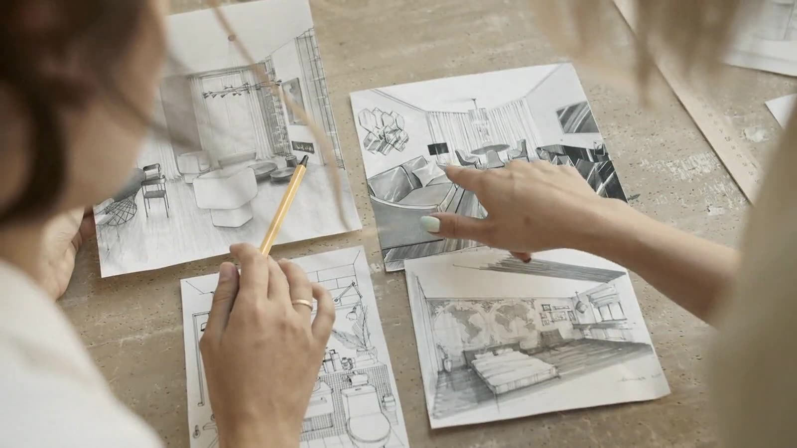
assets/m/video/tervezes.jpg
