mbolgar11/zenit/assets/m/video/toll.jpg

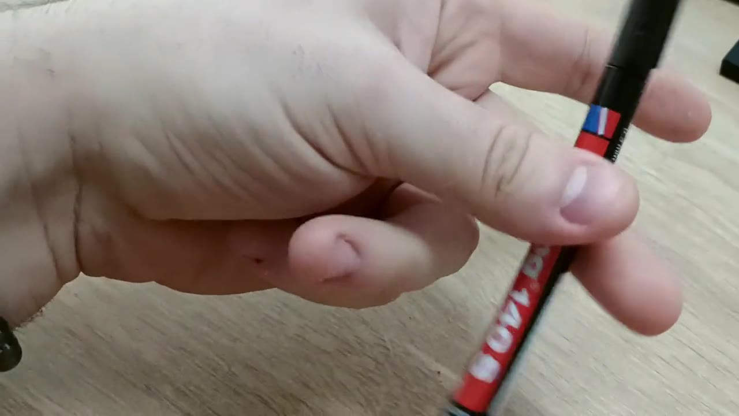
assets/m/video/toll.jpg
