mbolgar11/zenit/assets/m/video/uzem.jpg

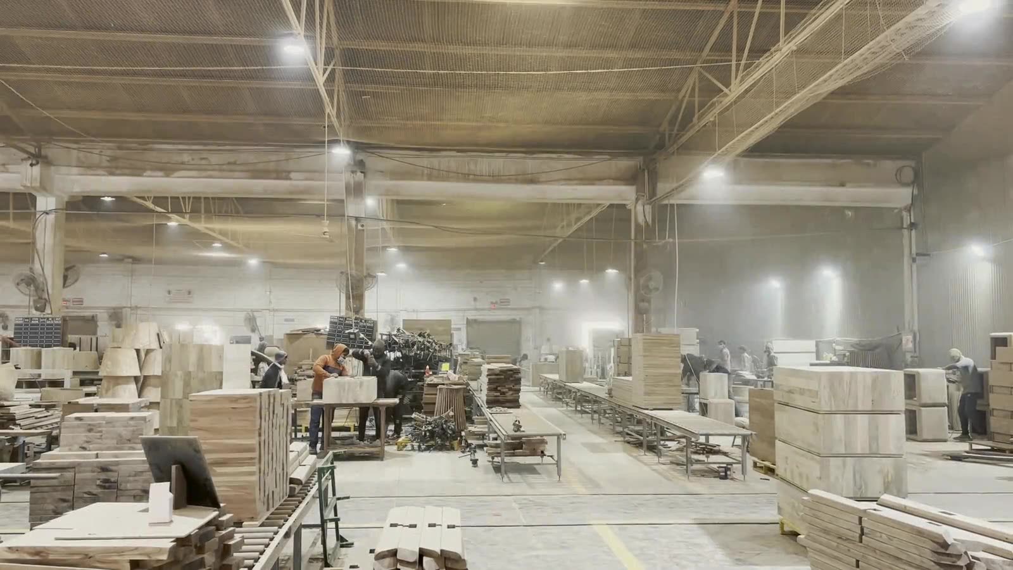
assets/m/video/uzem.jpg
