mbolgar11/zenit/assets/m/video/veso2.jpg

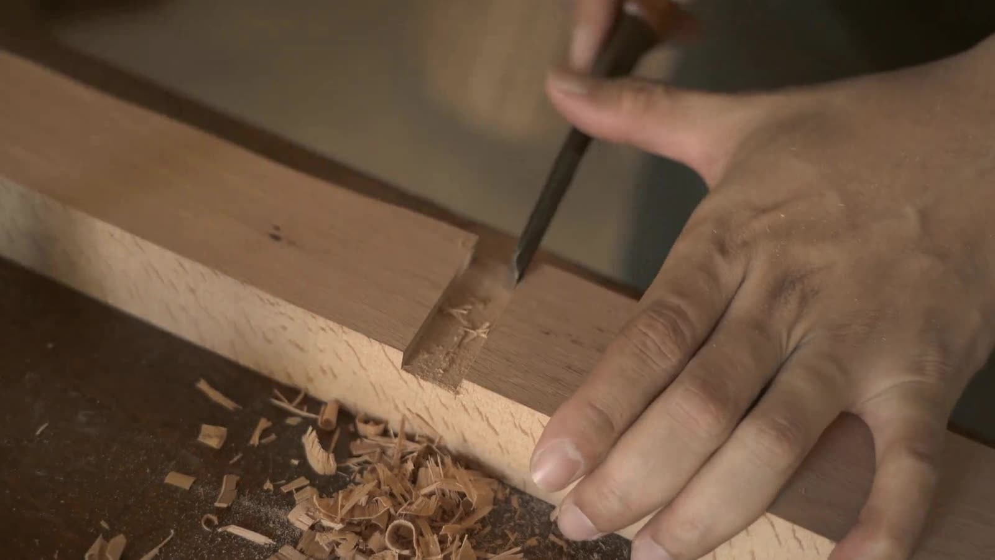
assets/m/video/veso2.jpg
