mbolgar11/zenit/assets/m/video/veso_v.jpg

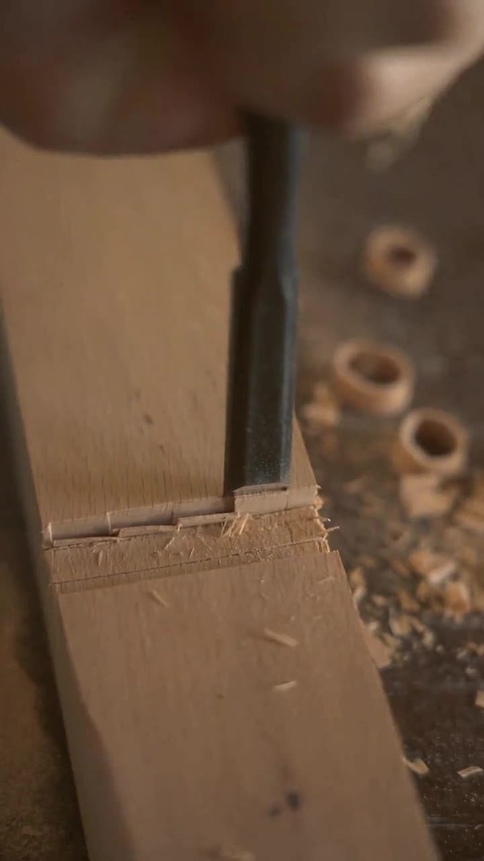
assets/m/video/veso_v.jpg
