mbolgar11/zenit/assets/m/video/vesok.jpg

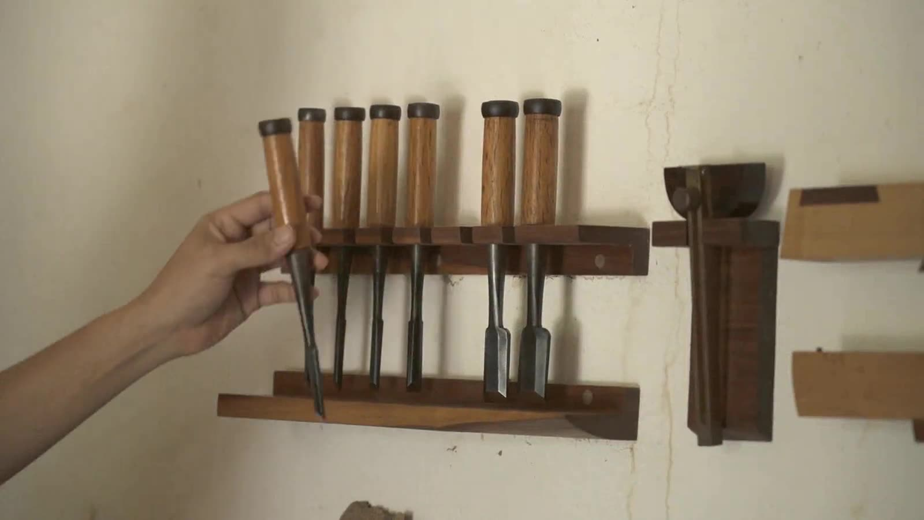
assets/m/video/vesok.jpg
