mbolgar11/zenit/assets/video/zenit_szereles_poster.jpg

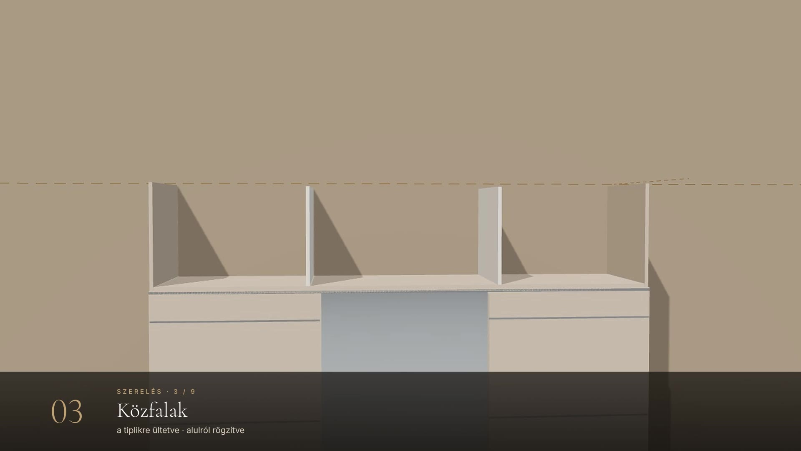
assets/video/zenit_szereles_poster.jpg
