mbolgar11/zenit/letoltes/Ratet_v10_Fusion_export.step

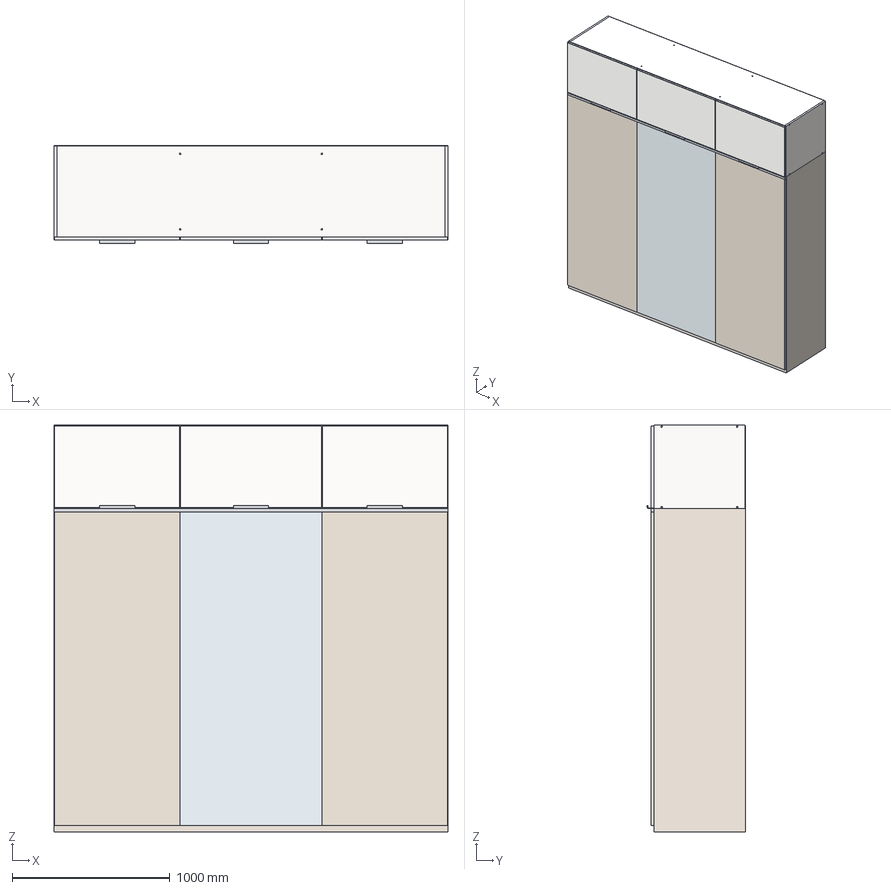
[picture p143: CAD file, 2026-11-04]
letoltes/Ratet_v10_Fusion_export.step
2500.0 x 622.0 x 2580.0 mm
