mbolgar11/zenit/(list of files, cad)

Other CAD files:
letoltes/Ratet_v10_CadQuery_teljes.step
letoltes/Ratet_v10_Fusion.f3d
