mbolgar11/zenit/(commit log)

2026-11-04 ZENIT v5: projektvideó + promóvideó, 3D GLB-nézegető, letöltések, napló oldal, tervező-kamera javítása
    Claude-Session: https://claude.ai/code/session_018JqTpqSX2Wg9reJontgD8J
    [Ratet_v10_CadQuery_teljes.step, Ratet_v10_Fusion.f3d, Ratet_v10_Fusion_export.step, Ratet_v10_kalkulacio.xlsx, Ratet_v10_szabasjegyzek_furattabla.xlsx]
2026-11-05 ZENIT v7: finomhangolás – láthatóság, új látványtervek, ajtónyitás- és szerelési videó
    - Tervező: visszafogott környezeti fény, melegszürke fal, füstölt tölgy padló – a kasmír tisztán elválik
    - Új renderek: második berendezés (dió komód, olajfa), zsálya, éjkék, tölgy, grafit+dió, fékes pánt belülről
    - Egységes utómunka (tónusgörbe, vignetta); kevesebb ismétlődő kép
    - Szerelés: háttérvideós fejléc, sötét szerszámszakasz, elmosott képsáv; új narrált szerelési videó
    - Garancia: esti render a fejlécben, elmosott képsáv, sötét ígéret-blokk
    - ZENIT oldal: „Nyisd ki” – valós idejű ajtónyitás belső LED-del
    - Olvashatós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
2026-11-05 ZENIT v7b: minden aloldal fejléce képet vagy videót kap
    - Inspiráció: hat szín montázsvideó; A projektről: modell → render → élő 3D montázs
    - Kézikönyv: a nyomtatott kézikönyv oldalai (külön álló kép mobilra)
    - Az Ön terve, Letöltések, Napló: hangulatkép/-videó, sötétített változatban
    - Erősebb bal oldali sötétítés a fejléceken, keskenyebb bevezető szöveg
    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
2026-11-05 ZENIT v7c: széles hangulatsávok minden oldalon
    - Oldalanként egy-egy új, teljes szélességű kép- vagy videósáv (műhely, gardrób, fény, szerszámok, élzárás)
    - Elmosott, szűrt változatok ott, ahol egy kép már szerepelt (tölgy textúra, belső LED, ajtónyitás)
    - A kézikönyv oldalán a sáv nyomtatásban rejtve marad
    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
2026-11-05 Napló: v7b–v7c fejlécek és hangulatsávok
    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
2026-11-05 Görgetésre mozgó ábrák: összeállás, színváltás, felemelkedés
    - Főoldal: a ZENIT darabról darabra összeáll görgetés közben (ferde axonometria, méretvonalak)
    - A ZENIT oldal: a dobozok eltűnnek, a ZENIT felnő a plafonig, a rés 540 mm-ről 10 mm-re csökken
    - Anyagok: a meglévő kasmír szekrény fölött hét szín vált egymásba
    - Továbblépés gomb: lüktető gyűrűk, mozduló nyíl, fénysáv
    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
2026-11-05 Saját fotók, alapító blokk, projektvideó v2 férfi narrációval és felirattal
    - A ZENIT oldal: valódi előtte–utána a saját ELIA szekrényről (retusált fotó + méretpontos fotómontázs), nagytotál fejléc
    - Manufaktúra: „A stúdió megálmodója” – portré a műhelyben, idézet, elvek, aláírás
    - Projektvideó v2 (1:30): valódi felvételek, laptop, renderek, weboldal, tervező, szerelés; férfi narráció, kikapcsolható felirat
    - Szerelési videó: férfi narráció, kikapcsolható felirat
    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
2026-11-05 Új saját fotók és felvételek: nyugodtabb alapítói portré, új videónyitás, élethű zárósnitt
    - Manufaktúra: új portré galléros ingben, bizalomkeltő arckifejezéssel; „Az él” kártya saját felvétellel
    - Anyagok: „Érintés” videósáv saját felvétellel; Concierge: elmosott vázlat-sáv
    - Projektvideó: két snittes portrényitás, új narrációs kezdés, kézi felvétel, zárásként a legélethűbb render
    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
2026-11-05 ÁSZF, süti- és adatkezelési tájékoztató, süti-hozzájárulás ablak
    - Új oldalak: aszf.html és suti.html (tartalomjegyzékkel, fejlécképpel; koncepció-jelöléssel, kitöltendő cégadatokkal)
    - Süti-ablak: „Süti, méretre szabva” – szükséges / statisztika / marketing kapcsolók, a döntés 12 hónapig megmarad
    - Lábléc: ÁSZF · Sütik és adatkezelés · Süti-beállítások
    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
2026-11-05 Üzleti terv 2027–2029 (oldal + PDF), pénzügyi modell, lábléc-link
    - uzleti-terv.html: piac, márka, üzleti modellek, ütemterv, értékesítés, marketing/PR, kiállítások, terjeszkedés, működés, kockázatok
    - Háromforgatókönyves negyedéves pénzügyi modell (src/uzleti_modell.py) SVG-grafikonokkal
    - letoltes/ZENIT_uzleti_terv.pdf – nyomtatható változat
    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
2026-11-05 Üzleti terv: képek és mozgás – számlálók, kirajzolódó grafikonok, Európa-térkép, telefonos makettek, képes kártyák, hangulatsávok
    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
2026-11-05 Manufaktúra: új alapítói portré világosabb fa műhelyben – tónusillesztés, ablakfény, fényátölelés, élesebb háttér
    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
